rcyaon/cmos-lnb/Schematic/Gain Stage/mc_data.csv

 _net0           out
 3.30000000e+00  1.68583395e+00
 3.30000000e+00  1.68202784e+00
 3.30000000e+00  1.63784445e+00
 3.30000000e+00  1.67969787e+00
 3.30000000e+00  1.66346403e+00
 3.30000000e+00  1.72007400e+00
 3.30000000e+00  1.66306128e+00
 3.30000000e+00  1.65420103e+00
 3.30000000e+00  1.64092329e+00
 3.30000000e+00  1.68198193e+00
 3.30000000e+00  1.68303207e+00
 3.30000000e+00  1.72075115e+00
 3.30000000e+00  1.74998021e+00
 3.30000000e+00  1.75943422e+00
 3.30000000e+00  1.70848397e+00
 3.30000000e+00  1.75111769e+00
 3.30000000e+00  1.63028762e+00
 3.30000000e+00  1.72789546e+00
 3.30000000e+00  1.71950260e+00
 3.30000000e+00  1.64782215e+00
 3.30000000e+00  1.65489096e+00
 3.30000000e+00  1.69533768e+00
 3.30000000e+00  1.70911867e+00
 3.30000000e+00  1.63577114e+00
 3.30000000e+00  1.69450837e+00
 3.30000000e+00  1.64470949e+00
 3.30000000e+00  1.66045326e+00
 3.30000000e+00  1.69922742e+00
 3.30000000e+00  1.68772599e+00
 3.30000000e+00  1.66191446e+00
 3.30000000e+00  1.65378743e+00
 3.30000000e+00  1.70569348e+00
 3.30000000e+00  1.71278133e+00
 3.30000000e+00  1.75738077e+00
 3.30000000e+00  1.71392175e+00
 3.30000000e+00  1.72858636e+00
 3.30000000e+00  1.67343731e+00
 3.30000000e+00  1.69081392e+00
 3.30000000e+00  1.75463824e+00
 3.30000000e+00  1.67305431e+00
 3.30000000e+00  1.66519034e+00
 3.30000000e+00  1.67364047e+00
 3.30000000e+00  1.71924878e+00
 3.30000000e+00  1.74024214e+00
 3.30000000e+00  1.77166651e+00
 3.30000000e+00  1.65648861e+00
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
 3.30000000e+00  1.70047558e+00
 3.30000000e+00  1.70060708e+00
 3.30000000e+00  1.68307297e+00
 3.30000000e+00  1.70125979e+00
 3.30000000e+00  1.66604276e+00
 3.30000000e+00  1.66890092e+00
 3.30000000e+00  1.68194118e+00
 3.30000000e+00  1.69823240e+00
 3.30000000e+00  1.72320882e+00
