rcyaon/cmos-lnb/Schematic/LDO/mc_data.csv

 _net2           out_1v7         out_2v5
 9.77246243e-01  1.70468408e+00  2.47625812e+00
 9.77421526e-01  1.70310513e+00  2.48603720e+00
 9.75590573e-01  1.70203683e+00  2.47949161e+00
 9.76550721e-01  1.70259062e+00  2.48273581e+00
 9.76596335e-01  1.70550087e+00  2.48212616e+00
 9.75005960e-01  1.69989950e+00  2.48236986e+00
 9.76549995e-01  1.69609739e+00  2.47823842e+00
 9.73409559e-01  1.70357592e+00  2.48407099e+00
 9.75771300e-01  1.70350521e+00  2.47812514e+00
 9.74613815e-01  1.70708728e+00  2.48560461e+00
 9.76063830e-01  1.70111546e+00  2.47862901e+00
 9.72481360e-01  1.70052850e+00  2.47899641e+00
 9.74198809e-01  1.70414366e+00  2.47800581e+00
 9.75233957e-01  1.70443093e+00  2.47888064e+00
 9.74503848e-01  1.70601858e+00  2.48215969e+00
 9.74639859e-01  1.70541854e+00  2.48683475e+00
 9.76736413e-01  1.69925143e+00  2.48072915e+00
 9.77827186e-01  1.70107792e+00  2.47469940e+00
 9.74937529e-01  1.70460157e+00  2.48048242e+00
 9.77582034e-01  1.70518079e+00  2.47160845e+00
 9.75825789e-01  1.70420694e+00  2.48341043e+00
 9.77357153e-01  1.70313988e+00  2.48285104e+00
 9.77428814e-01  1.69990745e+00  2.46804022e+00
 9.76853585e-01  1.70119539e+00  2.48719937e+00
 9.76476334e-01  1.70490760e+00  2.47670279e+00
 9.76364884e-01  1.70555823e+00  2.47984207e+00
 9.74880539e-01  1.70559182e+00  2.47901247e+00
 9.78136822e-01  1.70012559e+00  2.48126371e+00
 9.74008382e-01  1.70031722e+00  2.48817627e+00
 9.74580847e-01  1.69861129e+00  2.47567711e+00
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
 9.76390307e-01  1.70285434e+00  2.48463038e+00
 9.77330476e-01  1.70351396e+00  2.48061591e+00
 9.75548920e-01  1.70058418e+00  2.47610699e+00
 9.76323225e-01  1.70569119e+00  2.48474366e+00
 9.76735605e-01  1.70648532e+00  2.48374045e+00
 9.76780395e-01  1.70302016e+00  2.48521266e+00
 9.75597833e-01  1.70398375e+00  2.48273363e+00
 9.76262722e-01  1.70223109e+00  2.47880831e+00
 9.79748683e-01  1.70448570e+00  2.48529902e+00
 9.76016633e-01  1.69828643e+00  2.47832998e+00
 9.76586605e-01  1.70104679e+00  2.47897045e+00
 9.75772829e-01  1.70842233e+00  2.48127845e+00
 9.77791422e-01  1.69877060e+00  2.48227929e+00
 9.76446421e-01  1.70296661e+00  2.47796003e+00
 9.77571122e-01  1.70454232e+00  2.47848129e+00
 9.75471506e-01  1.70080852e+00  2.48277905e+00
 9.77778661e-01  1.70513684e+00  2.47938800e+00
 9.75961408e-01  1.70553503e+00  2.47356947e+00
 9.78091968e-01  1.69991725e+00  2.48165223e+00
 9.75946097e-01  1.70102088e+00  2.48385812e+00
 9.75693006e-01  1.69732371e+00  2.47734892e+00
 9.75691131e-01  1.70352415e+00  2.47394726e+00
 9.76035717e-01  1.70485462e+00  2.47853882e+00
 9.77915350e-01  1.70219673e+00  2.48410119e+00
 9.76820954e-01  1.70484325e+00  2.47872105e+00
 9.75818506e-01  1.70050121e+00  2.47844079e+00
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
