rcyaon/cmos-lnb/Images/LNA_Block_Diagram.png

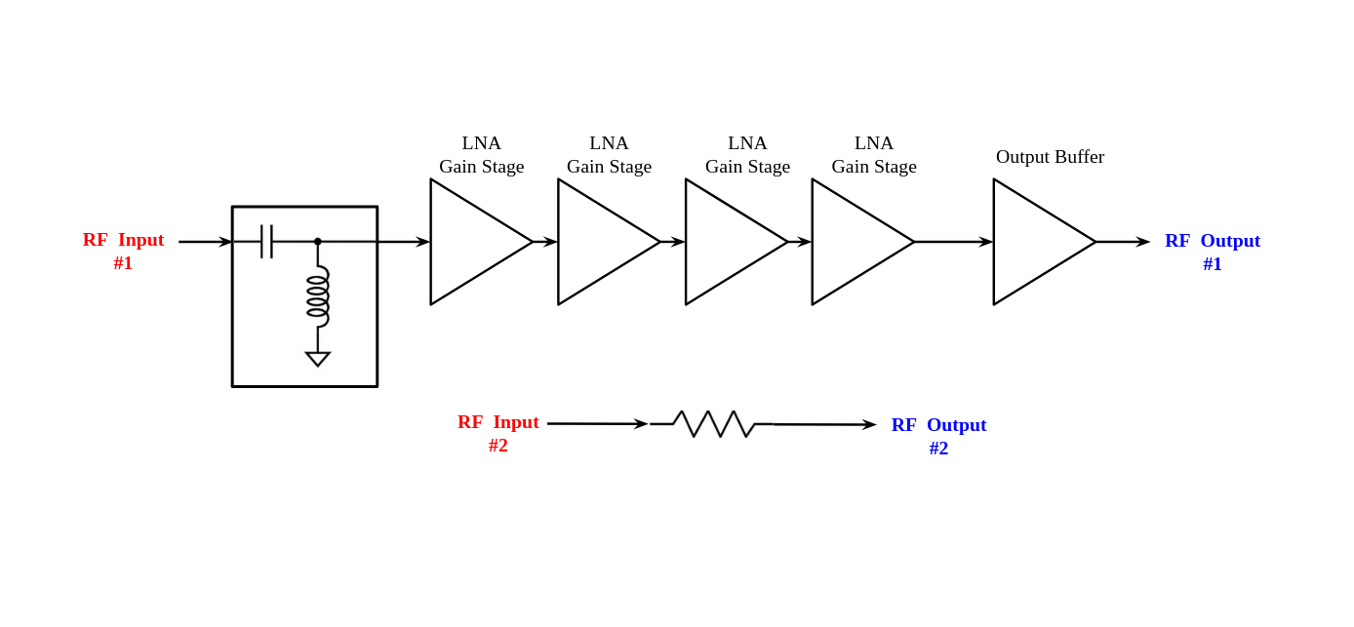
Images/LNA_Block_Diagram.png
