rcyaon/cmos-lnb/Images/LNB_Block_Diagram.png

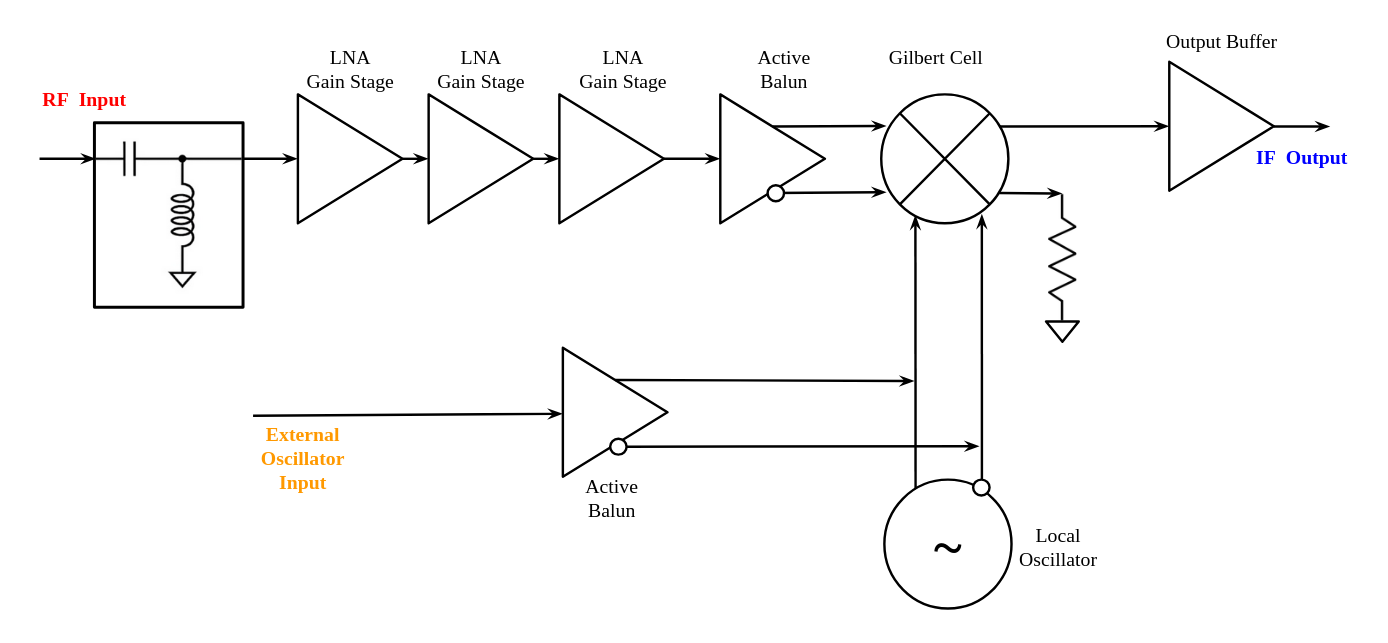
Images/LNB_Block_Diagram.png
