rcyaon/cmos-lnb/Images/LNB_Frequency_Converter_Block_Diagram.png

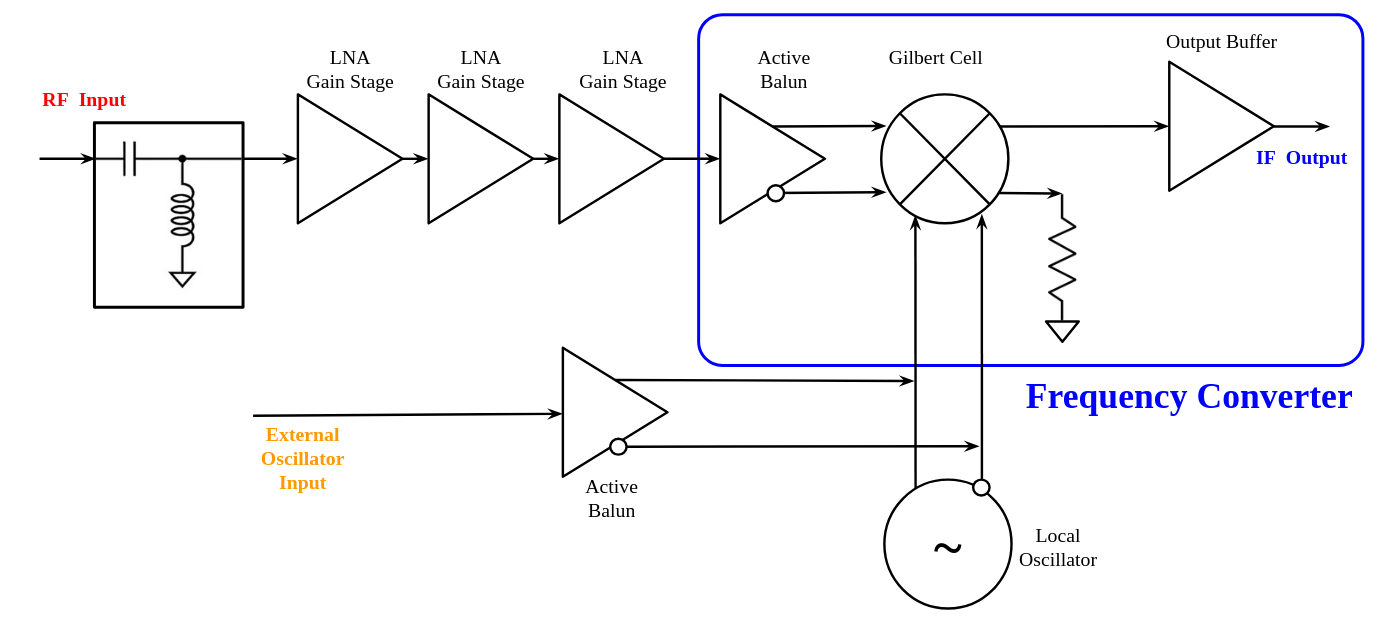
Images/LNB_Frequency_Converter_Block_Diagram.png
