rcyaon/cmos-lnb/Images/LNB_Front_End_Block_Diagram.png

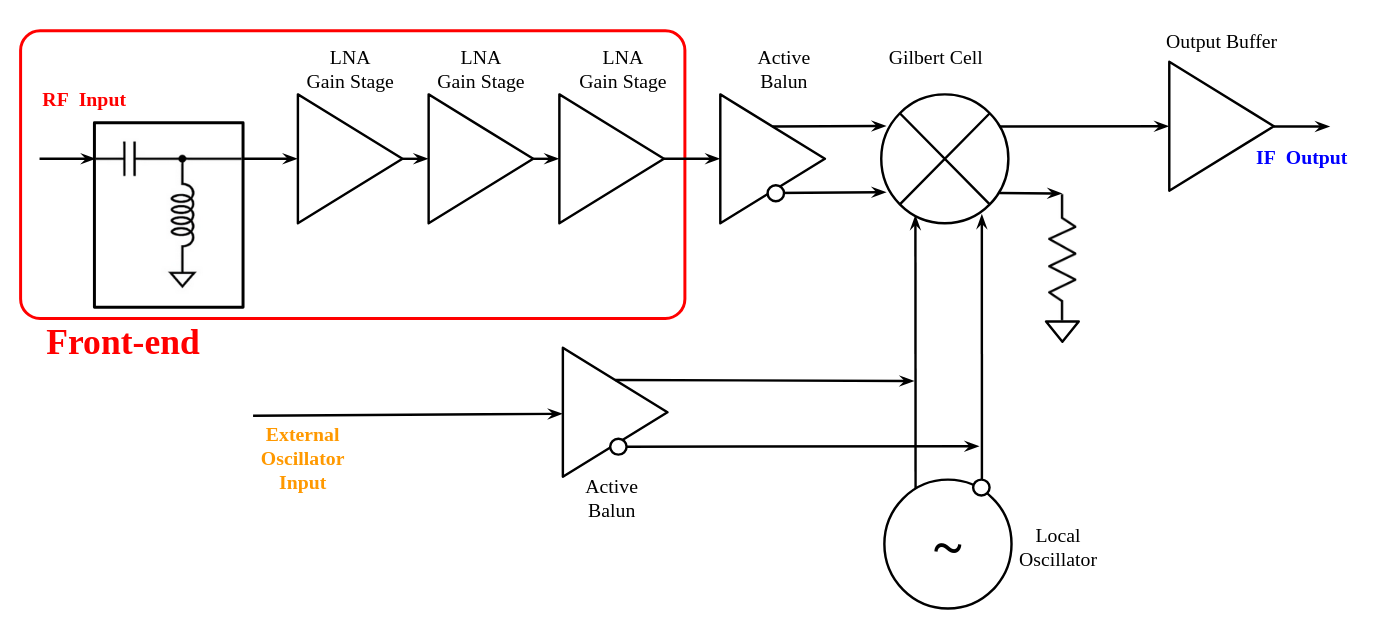
Images/LNB_Front_End_Block_Diagram.png
