rcyaon/cmos-lnb/Images/MC__net0_TT.png

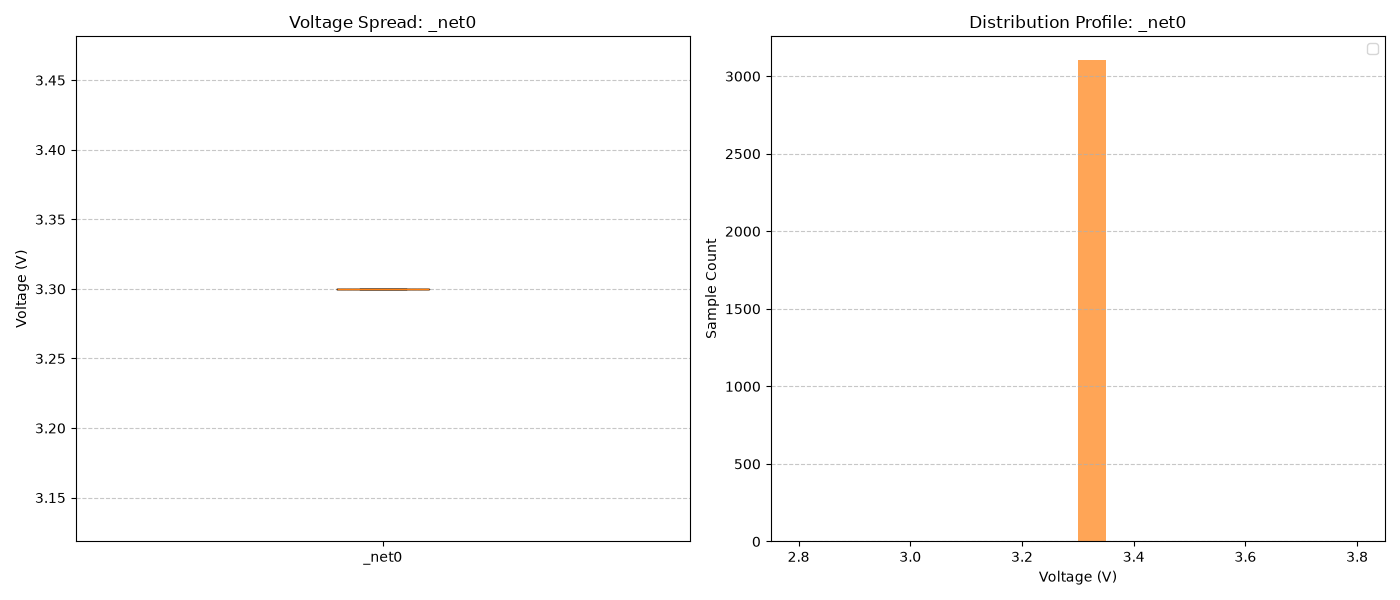
Images/MC__net0_TT.png
