rcyaon/cmos-lnb/Images/MC__net2_TT.png

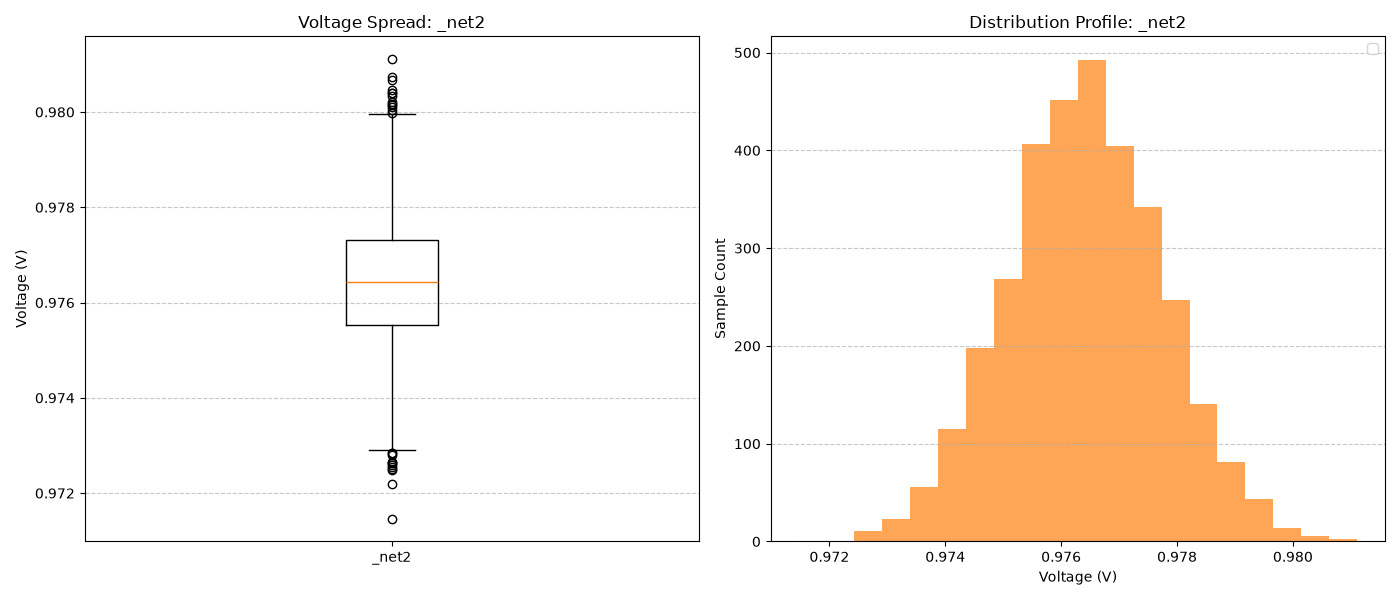
Images/MC__net2_TT.png
