rcyaon/cmos-lnb/Images/QUCS_ota5.png

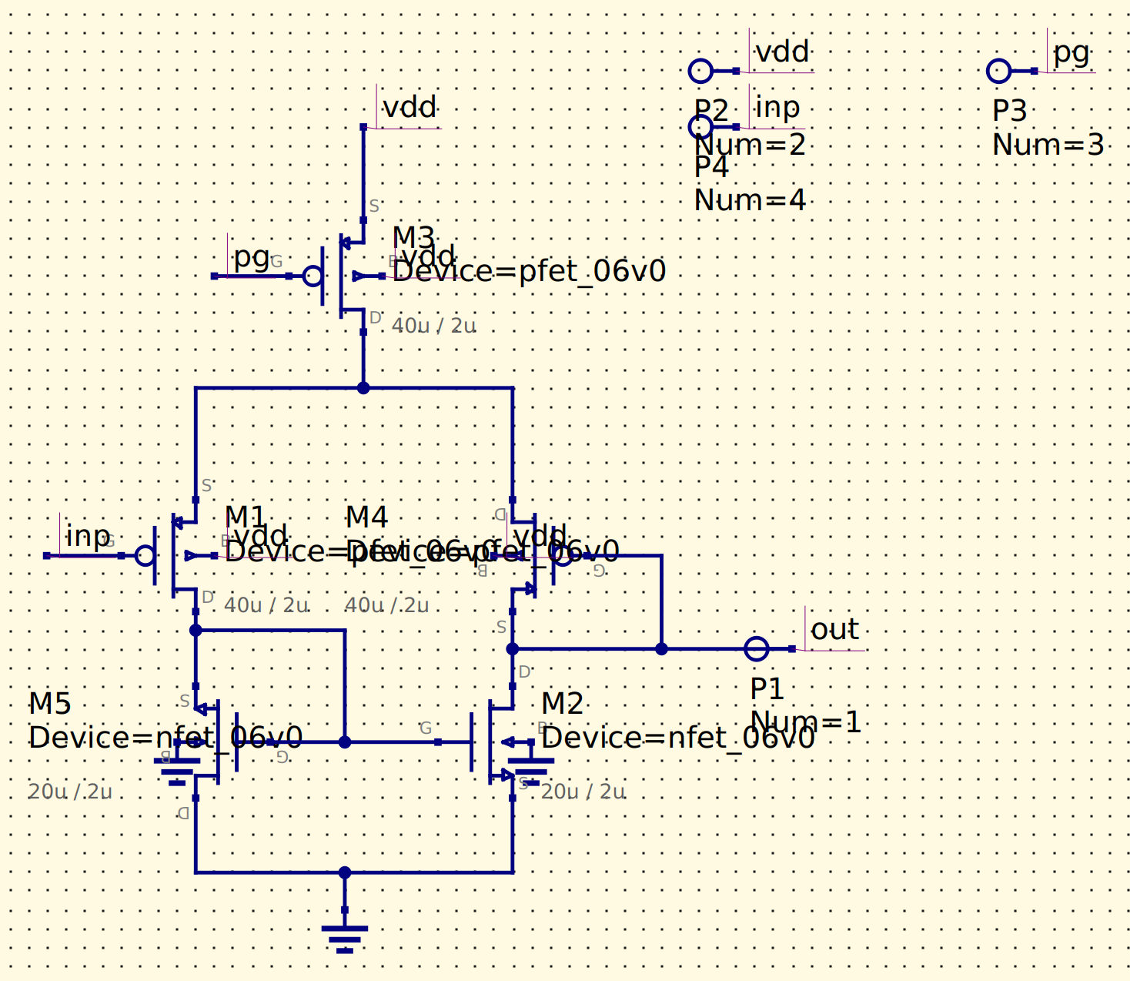
Images/QUCS_ota5.png
