rcyaon/cmos-lnb/Images/QUCS_tb_beta_mult_startup.png

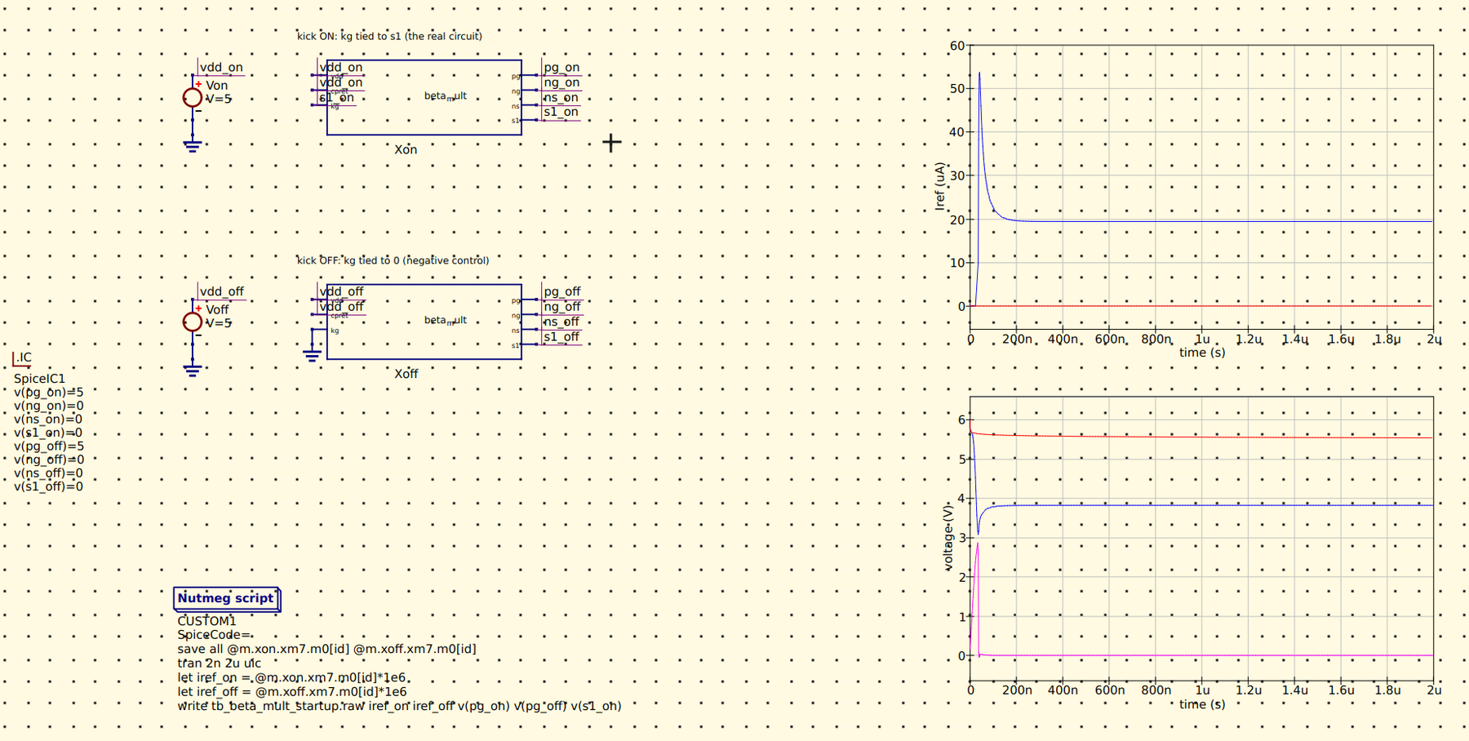
Images/QUCS_tb_beta_mult_startup.png
