rcyaon/cmos-lnb/Images/QUCS_tb_beta_mult_supply.png

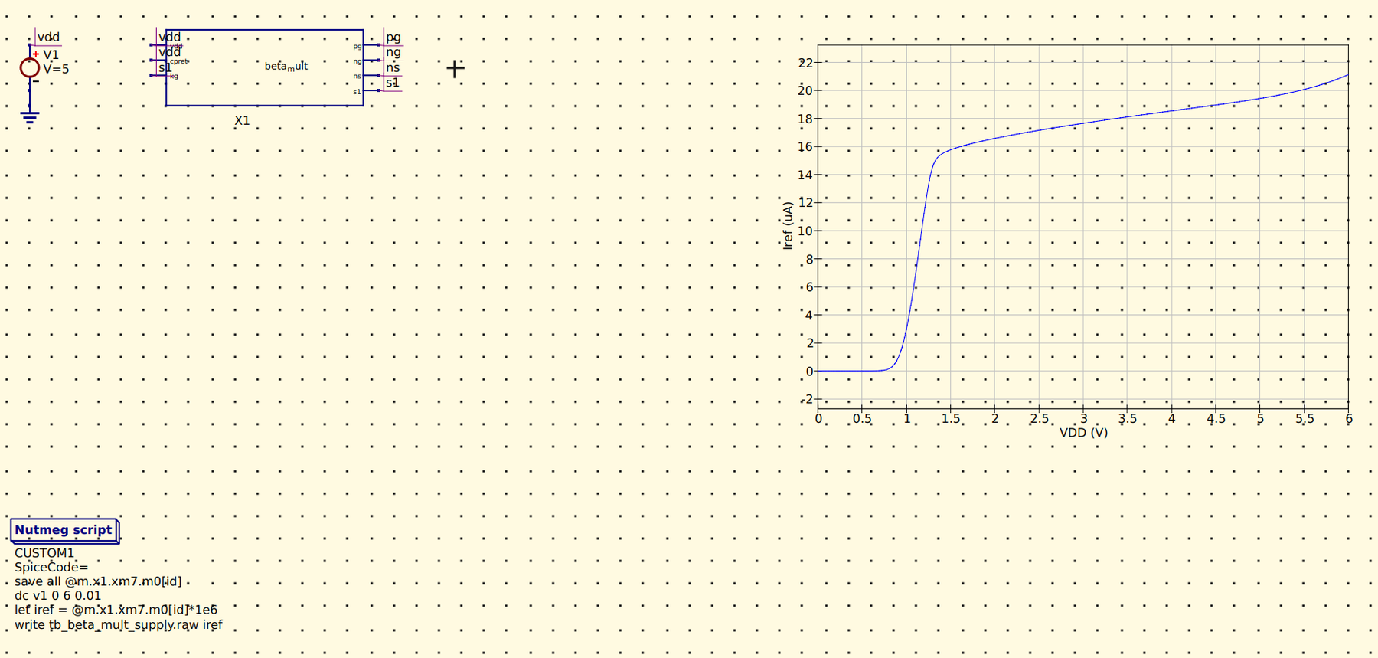
Images/QUCS_tb_beta_mult_supply.png
