rcyaon/cmos-lnb/Images/QUCS_tb_beta_mult_temp.png

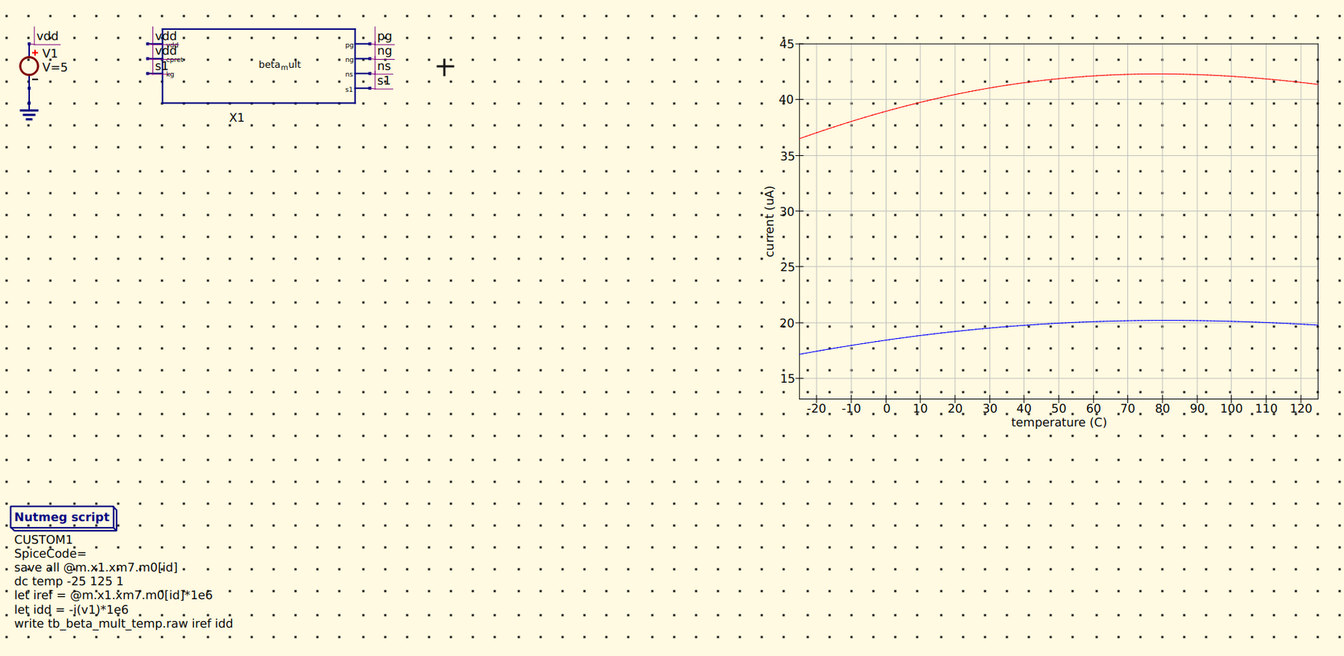
Images/QUCS_tb_beta_mult_temp.png
