rcyaon/cmos-lnb/Images/QUCS_tb_inv_vtc.png

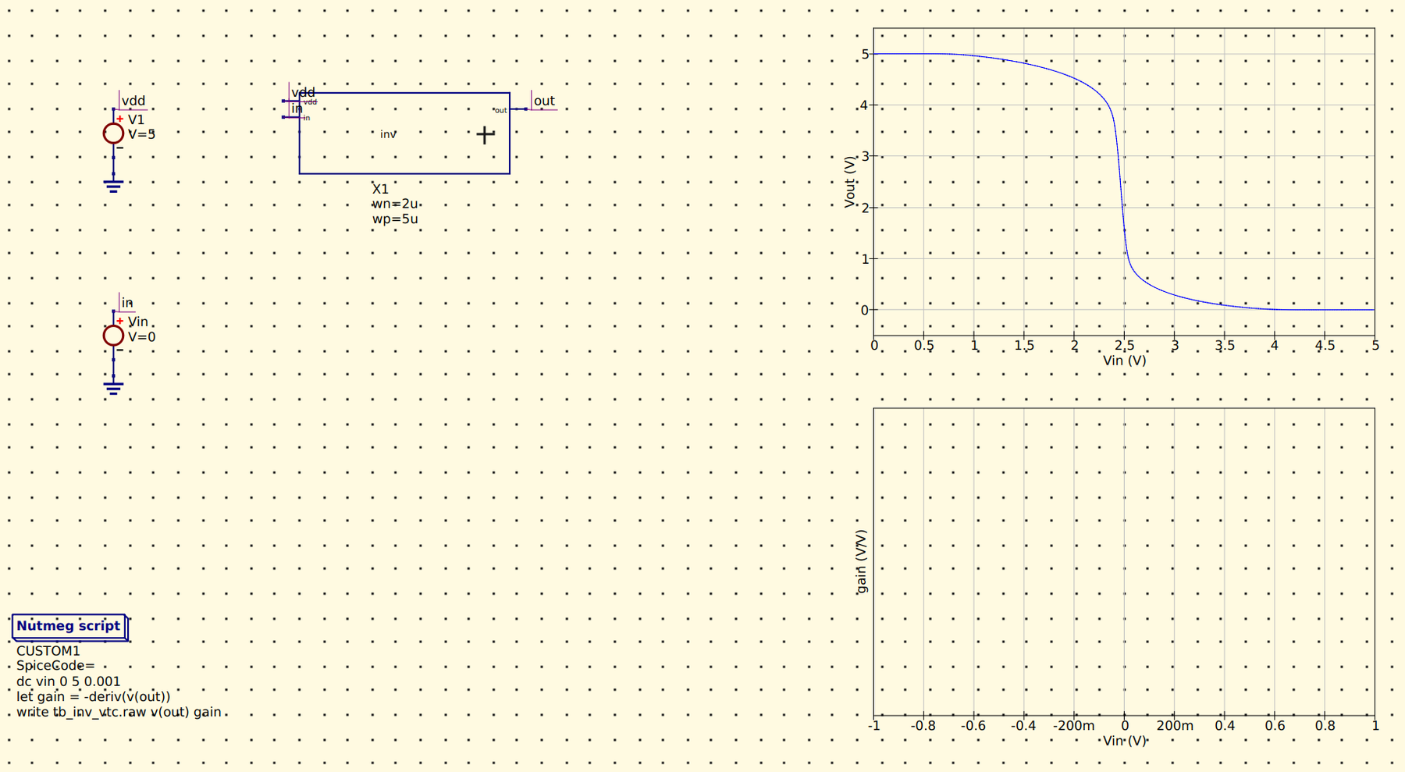
Images/QUCS_tb_inv_vtc.png
