rcyaon/cmos-lnb/Images/QUCS_tb_ringosci.png

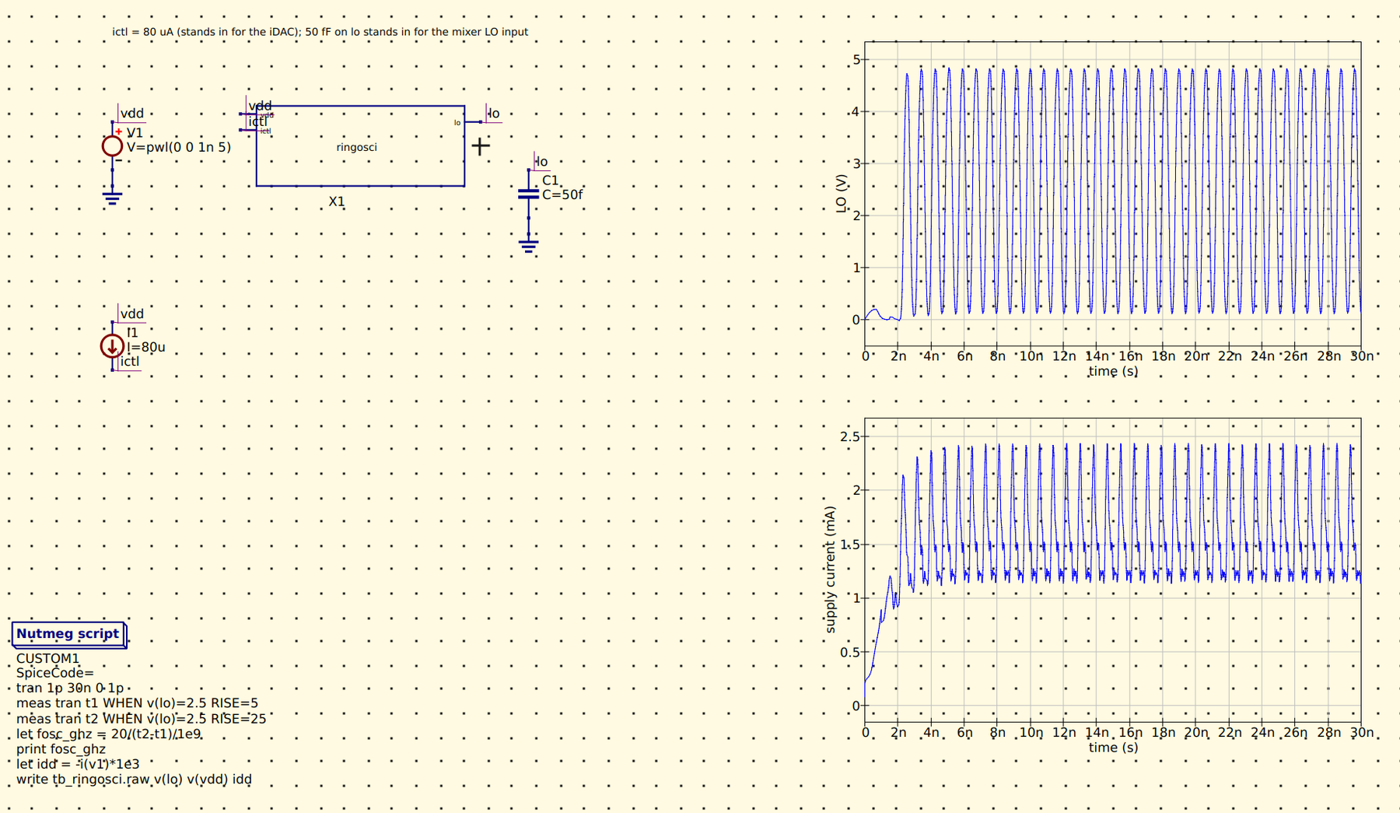
Images/QUCS_tb_ringosci.png
