rcyaon/cmos-lnb/Images/QUCS_tb_ringosci_disable.png

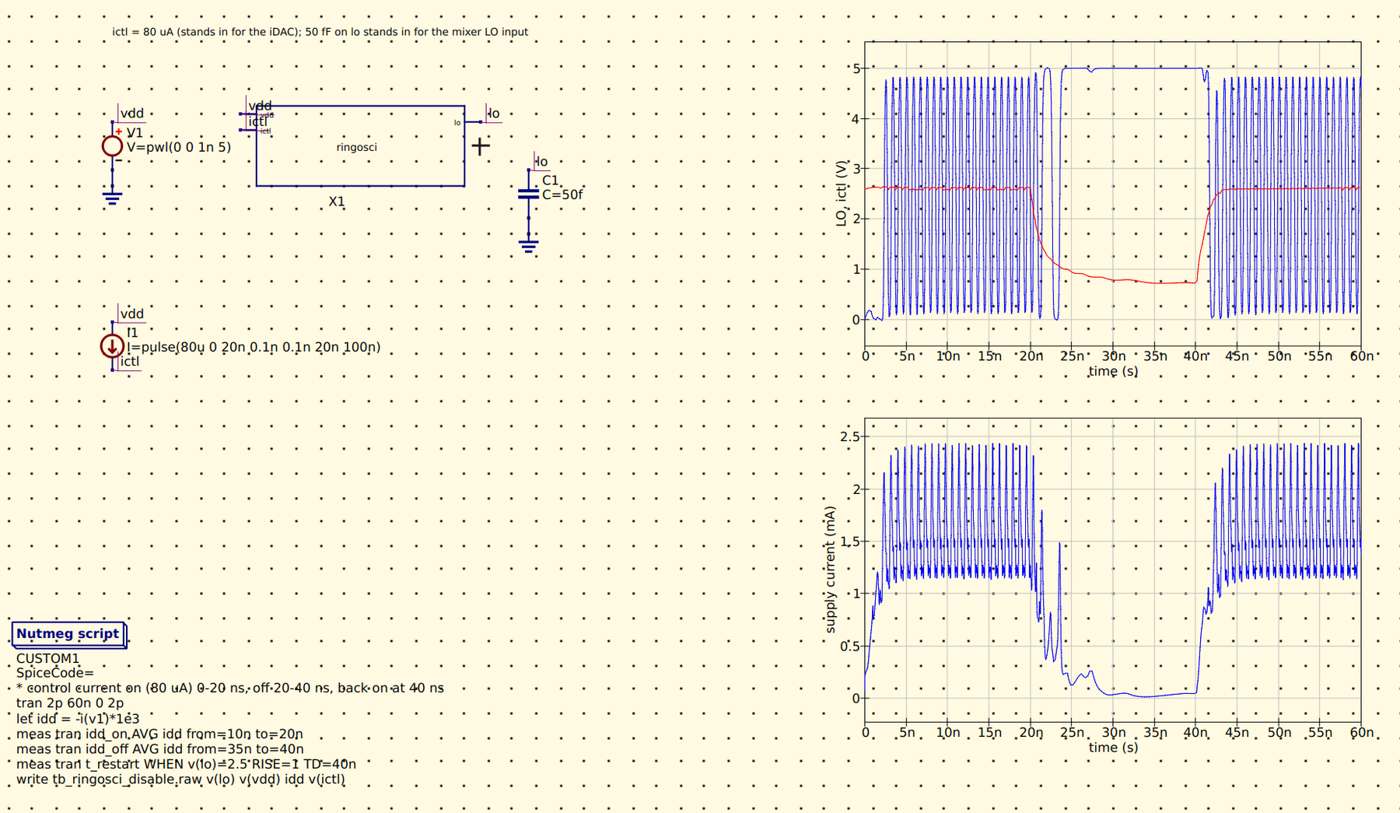
Images/QUCS_tb_ringosci_disable.png
