rcyaon/cmos-lnb/Images/QUCS_tb_vref_load.png

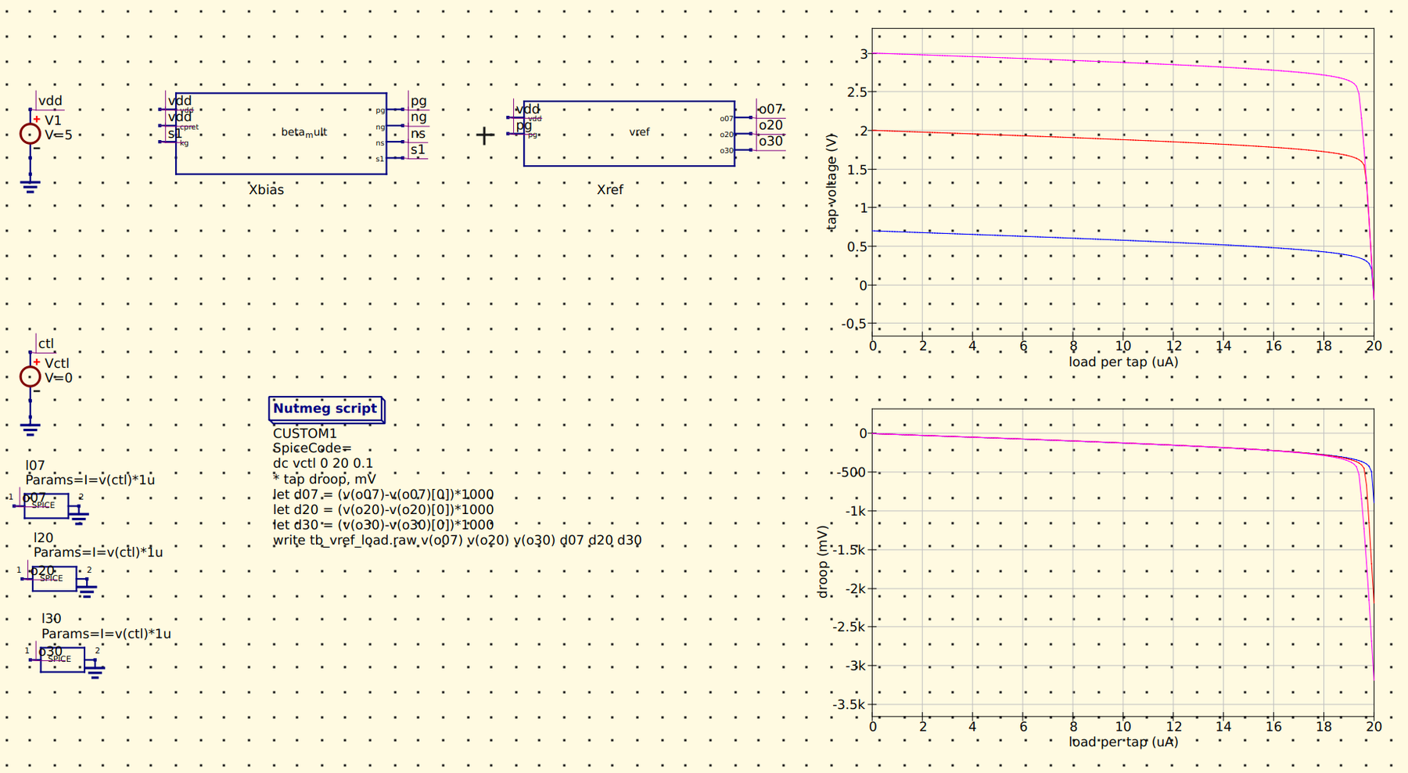
Images/QUCS_tb_vref_load.png
