rcyaon/cmos-lnb/Images/QUCS_tb_vref_loadstep.png

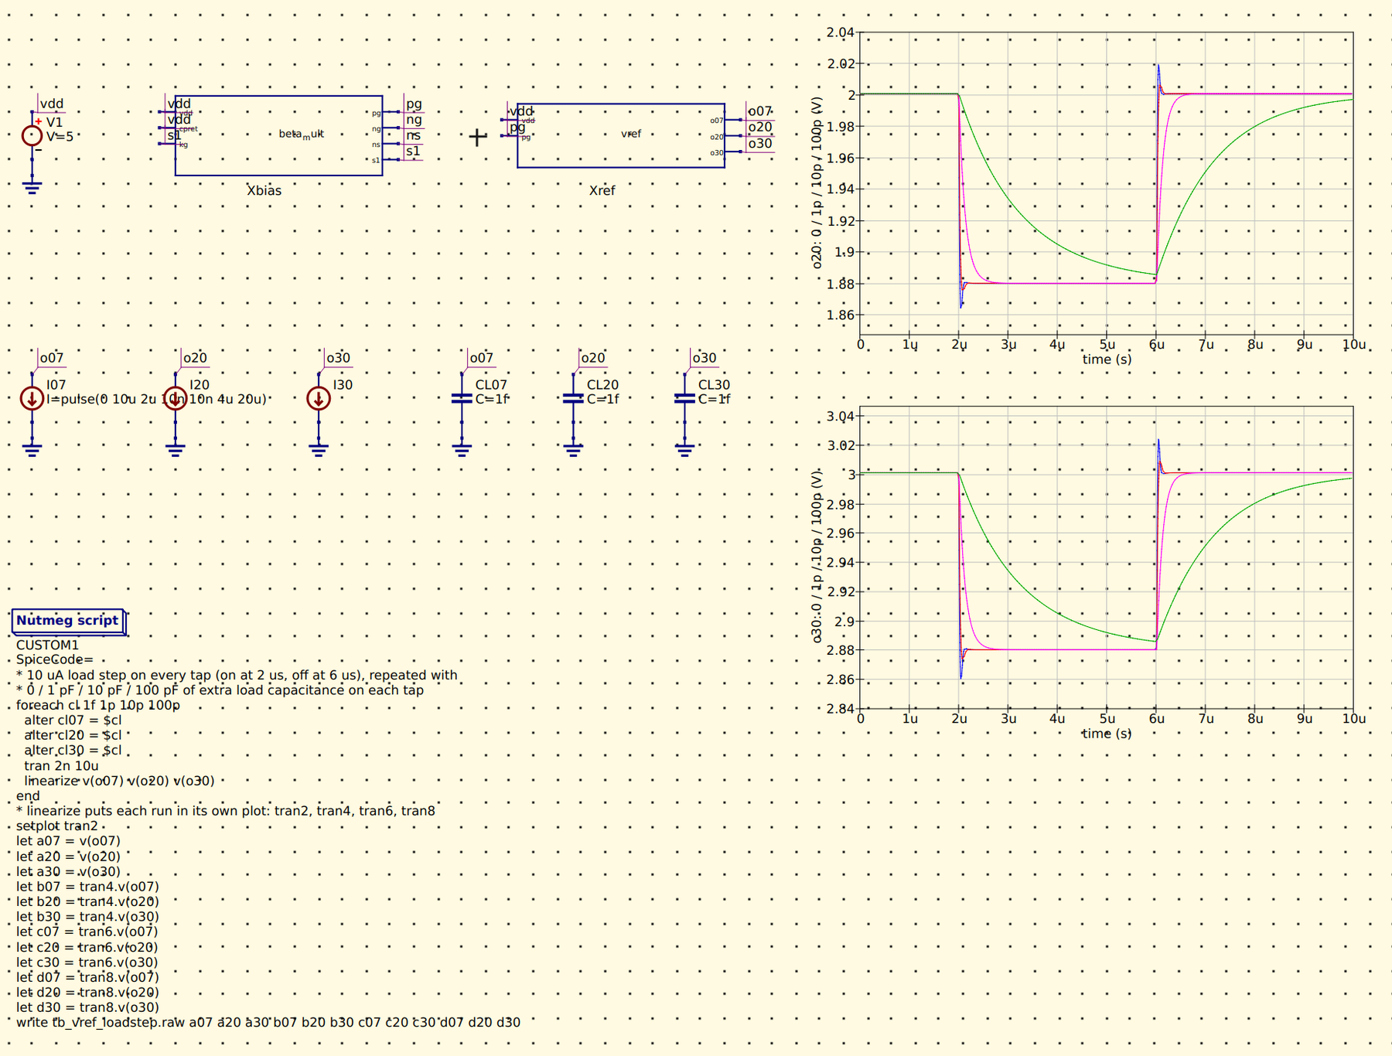
Images/QUCS_tb_vref_loadstep.png
