rcyaon/cmos-lnb/Images/QUCS_tb_vref_noise.png

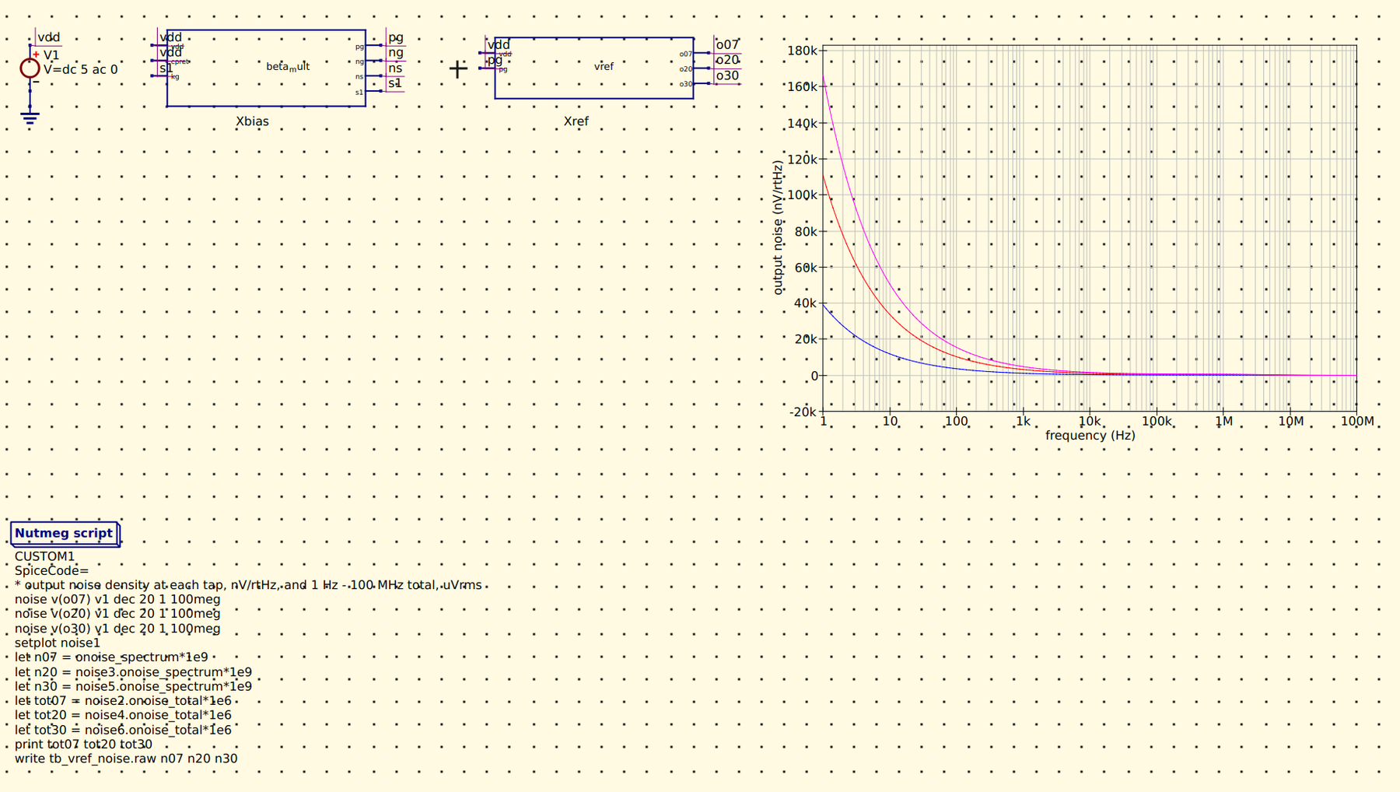
Images/QUCS_tb_vref_noise.png
