rcyaon/cmos-lnb/Images/QUCS_tb_vref_powerup.png

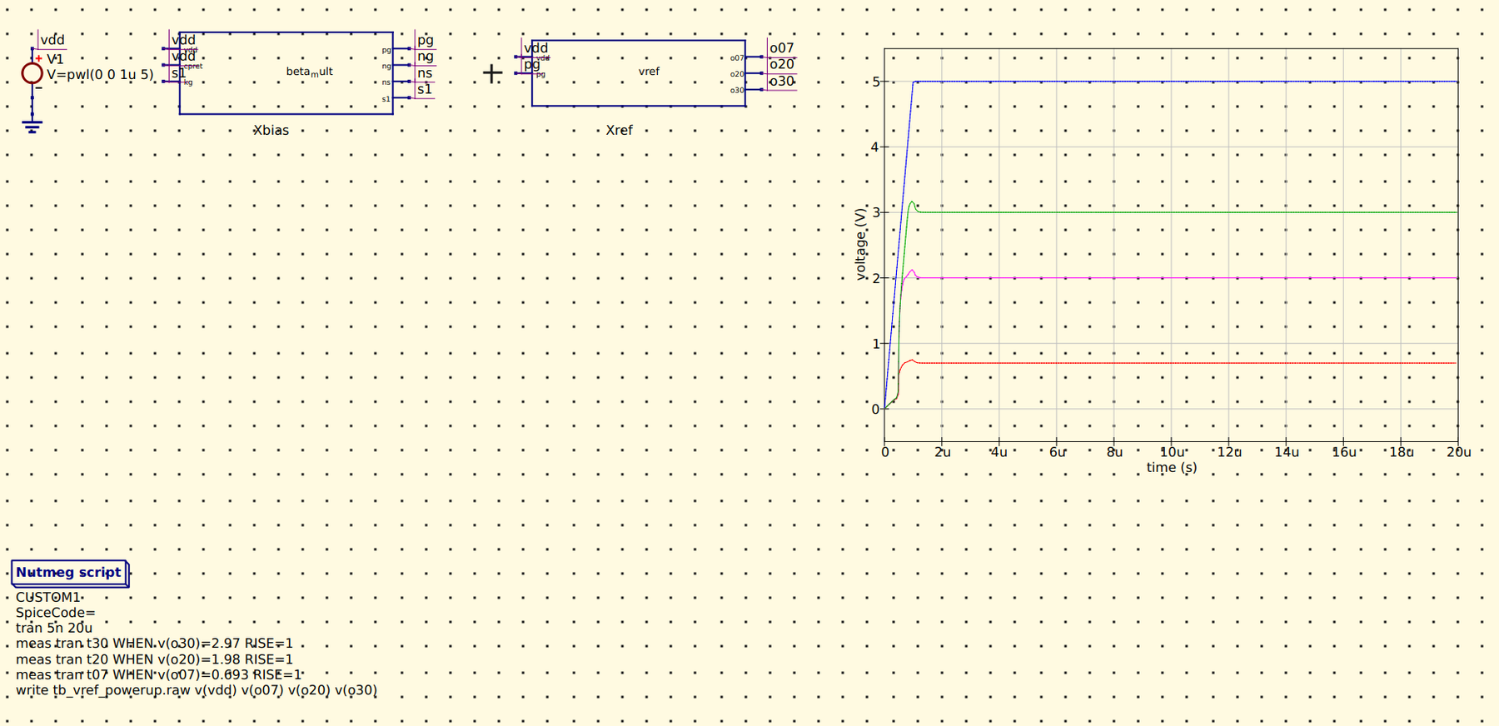
Images/QUCS_tb_vref_powerup.png
