rcyaon/cmos-lnb/Images/QUCS_tb_vref_psrr.png

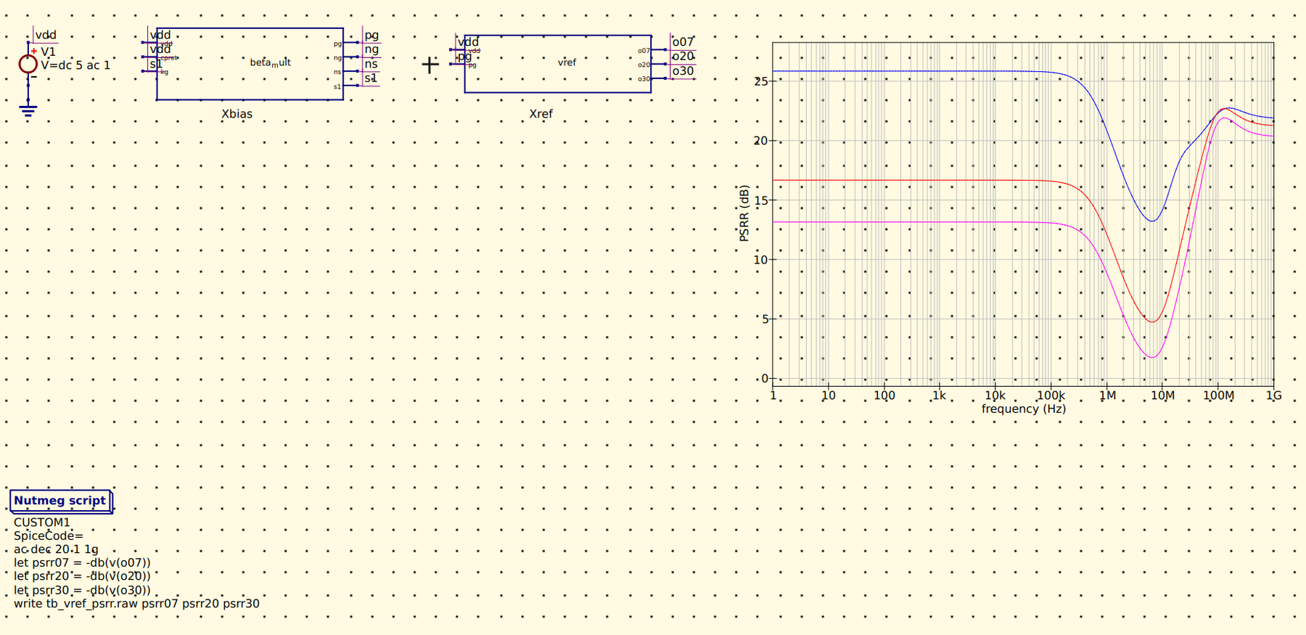
Images/QUCS_tb_vref_psrr.png
