rcyaon/cmos-lnb/Images/QUCS_tb_vref_supply.png

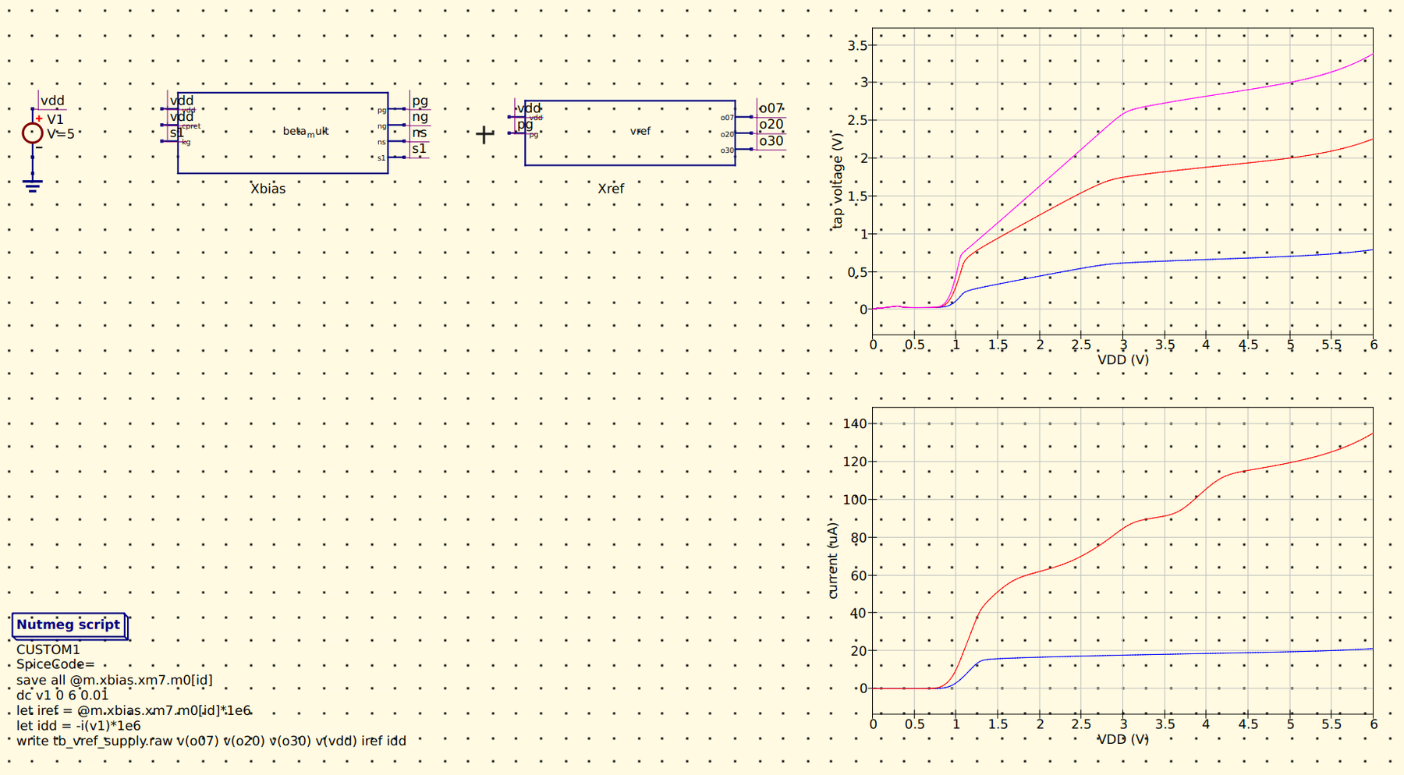
Images/QUCS_tb_vref_supply.png
