rcyaon/cmos-lnb/Images/QUCS_tb_vref_temp.png

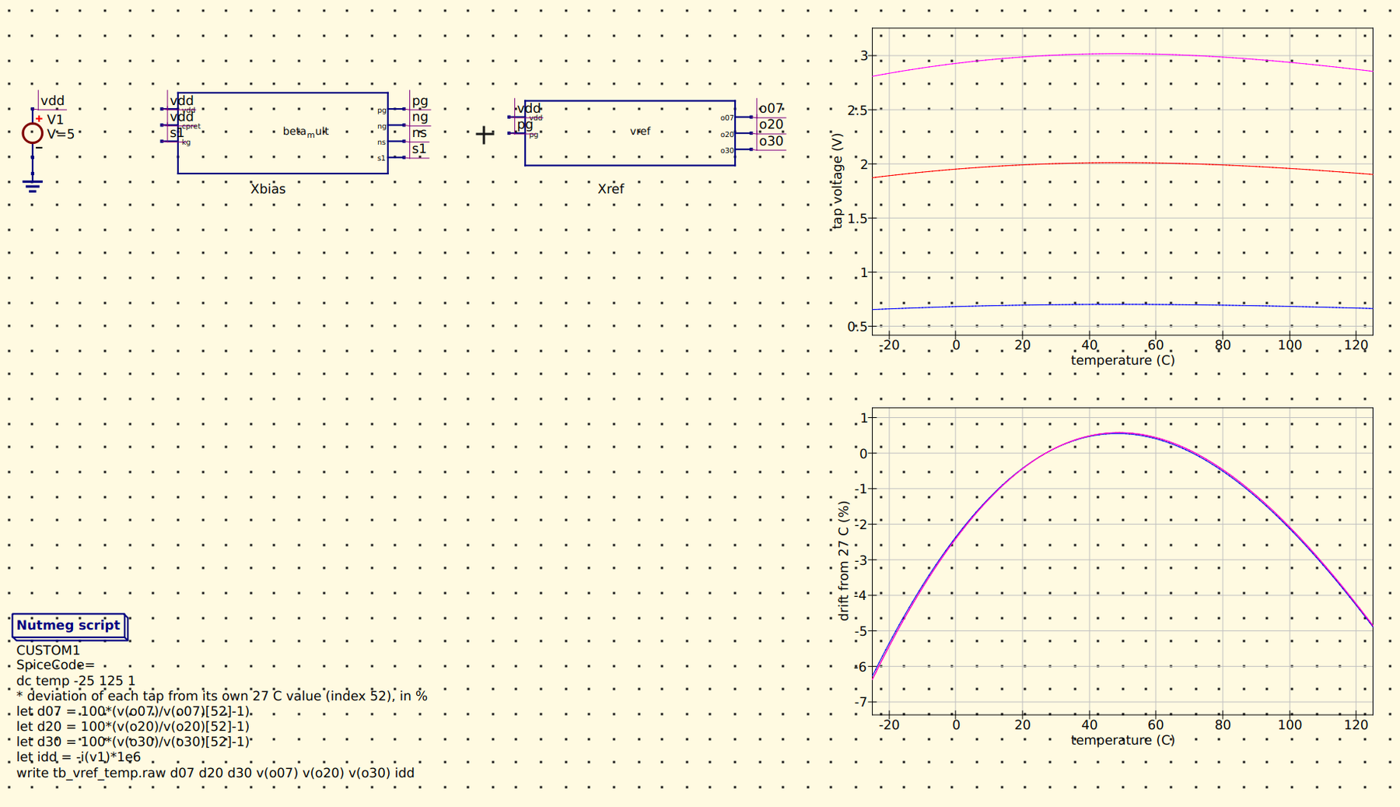
Images/QUCS_tb_vref_temp.png
