rcyaon/cmos-lnb/Images/Reference_Rise_Time_FF.png

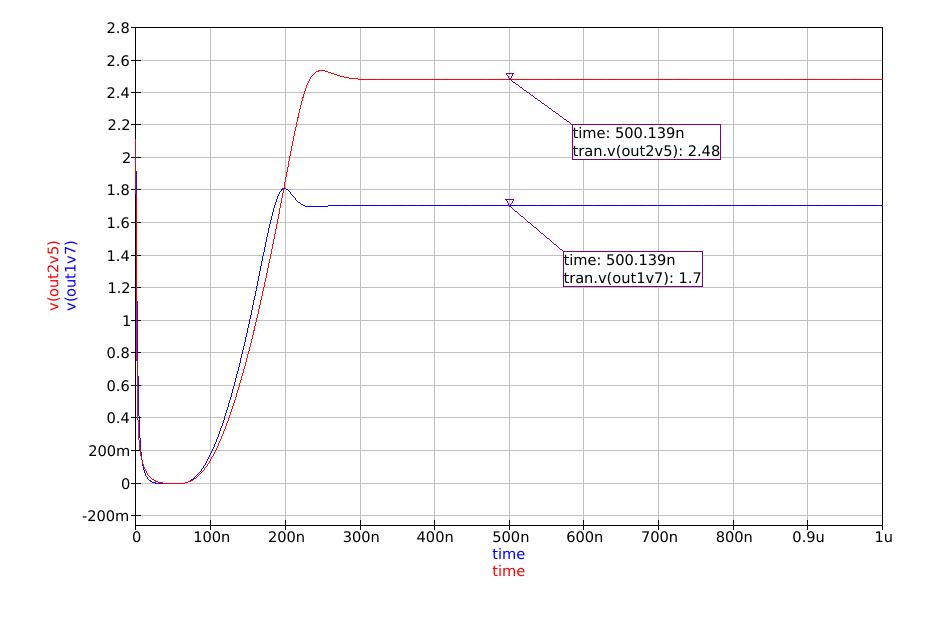
Images/Reference_Rise_Time_FF.png
