rcyaon/cmos-lnb/Images/Reference_Rise_Time_SF.png

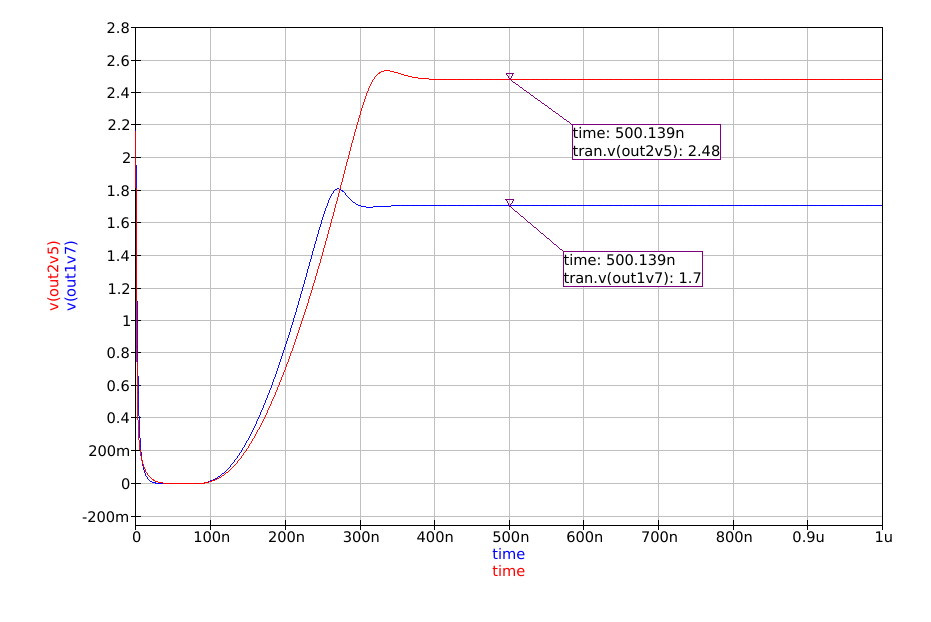
Images/Reference_Rise_Time_SF.png
