rcyaon/cmos-lnb/Images/Reference_Rise_Time_SS.png

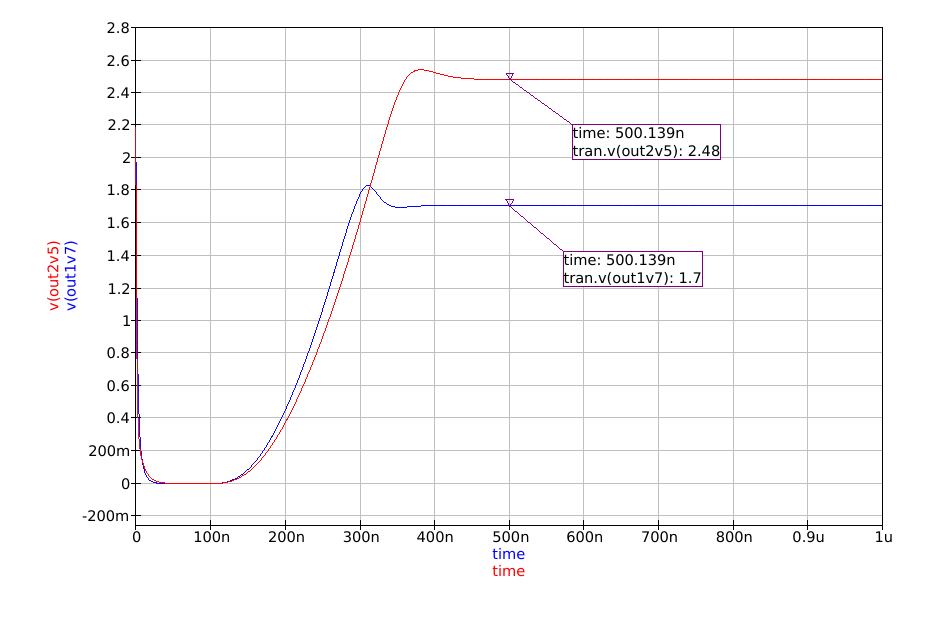
Images/Reference_Rise_Time_SS.png
