rcyaon/cmos-lnb/Schematic/LNB/Characterization.md

# Low Noise Block Down Converter

*Most Up-To-Date Schematic: Schematic/LNB/LNBMkII.sch*

All characterization was done with a 3.3V supply, at 27 C and with the oscillator current limiters provided with 2 mA of current.

## S Parameter Test Bench

*Most Up-To-Date Schematic: Schematic/LNB/LNB_Testing_S_Parameters_MkI.sch*

### Typical

|Parameter|Simulation|
|---|---|
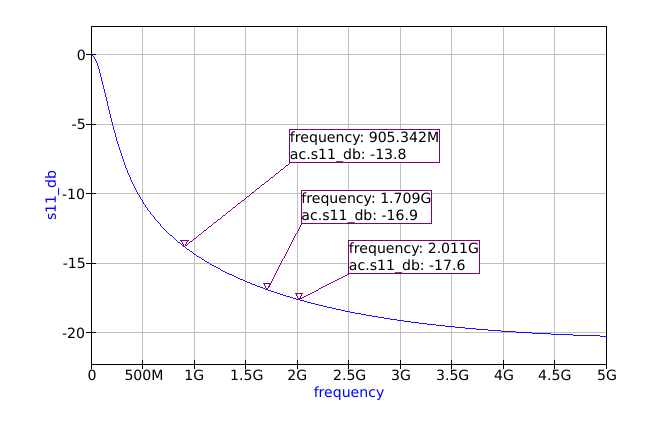
[picture p45: Images/LNB_S11_TT.png]
|S11||
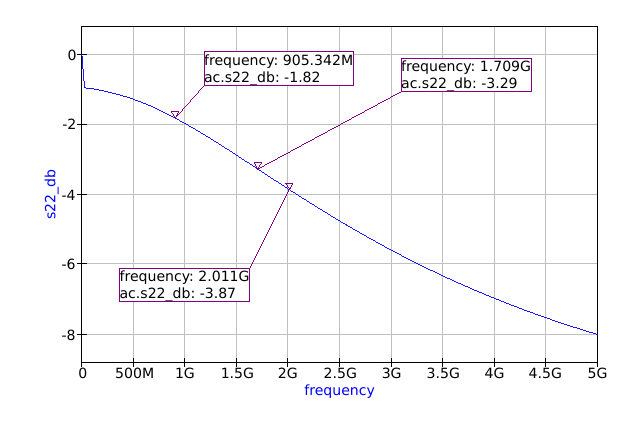
[picture p46: Images/LNB_S22_TT.png]
|S22||

### Slow-Slow Corner

|Parameter|Simulation|
|---|---|
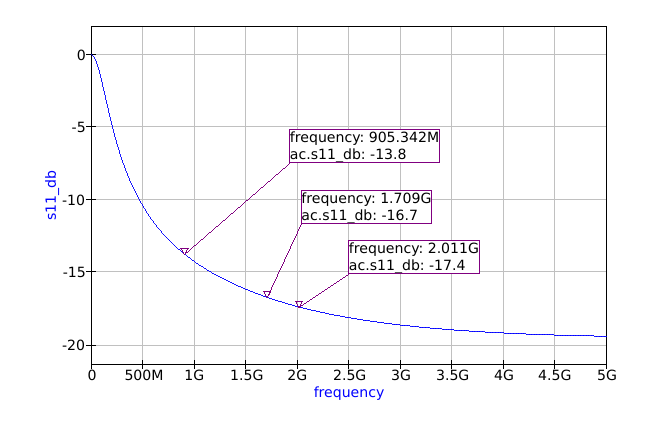
[picture p47: Images/LNB_S11_SS.png]
|S11||
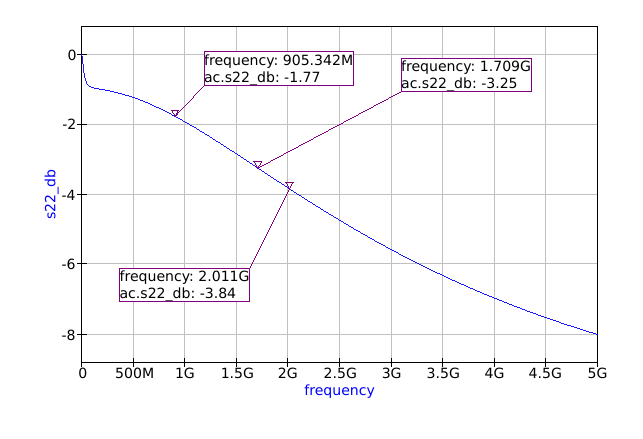
[picture p48: Images/LNB_S22_SS.png]
|S22||

### Fast-Fast Corner

|Parameter|Simulation|
|---|---|
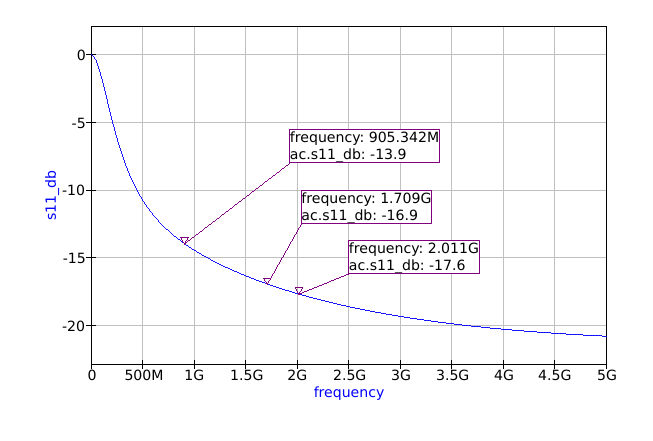
[picture p49: Images/LNB_S11_FF.png]
|S11||
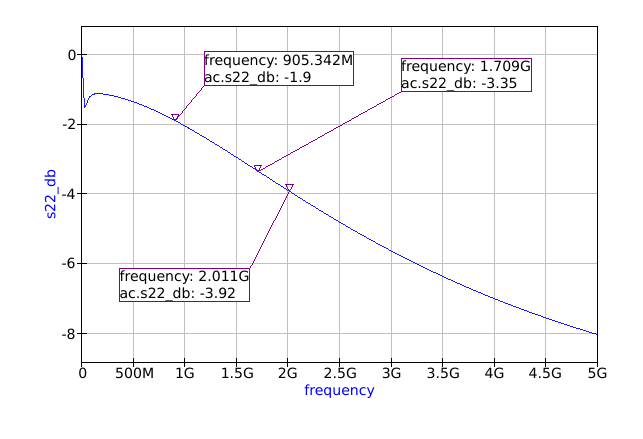
[picture p50: Images/LNB_S22_FF.png]
|S22||

### Slow-Fast Corner

|Parameter|Simulation|
|---|---|
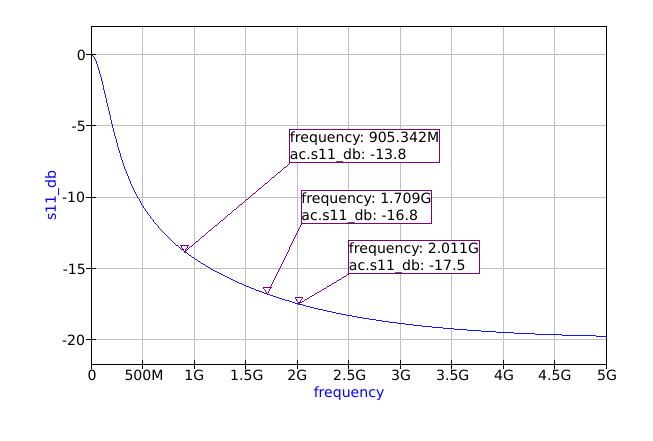
[picture p51: Images/LNB_S11_SF.png]
|S11||
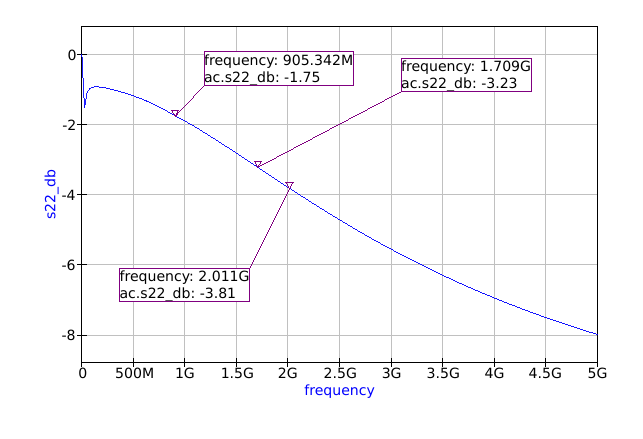
[picture p52: Images/LNB_S22_SF.png]
|S22||

### Fast-Slow Corner

|Parameter|Simulation|
|---|---|
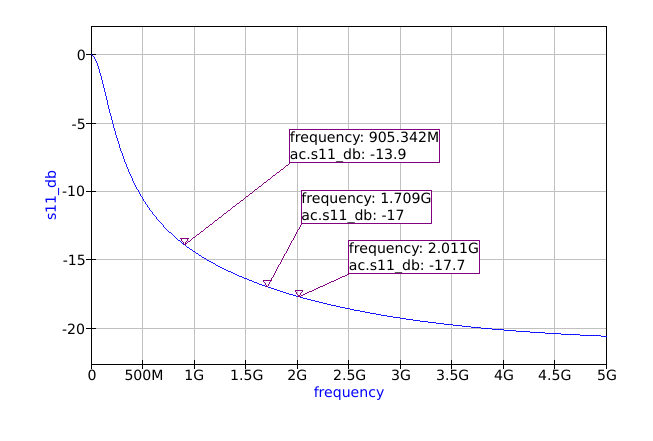
[picture p53: Images/LNB_S11_FS.png]
|S11||
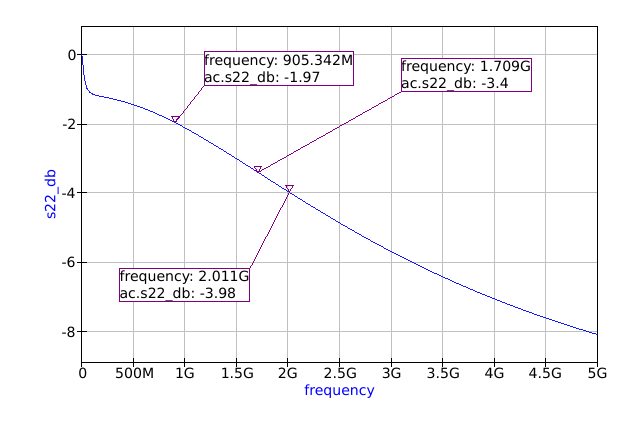
[picture p54: Images/LNB_S22_FS.png]
|S22||

## Gain Test Bench

*Most Up-To-Date Schematic: Schematic/LNB/LNB_Testing_Gain_MkI.sch*

### Typical

|900 MHz|1.7 GHz|2.0 GHz|
|---|---|---|
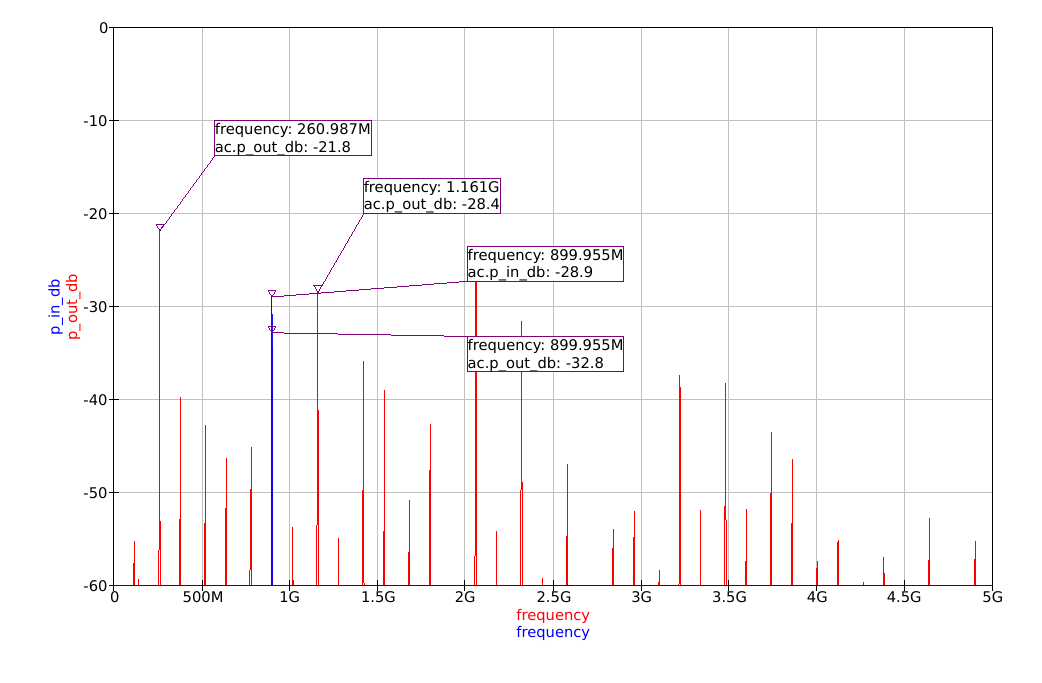
[picture p55: Images/LNB_Gain_0p9G_TT.png]
Gain
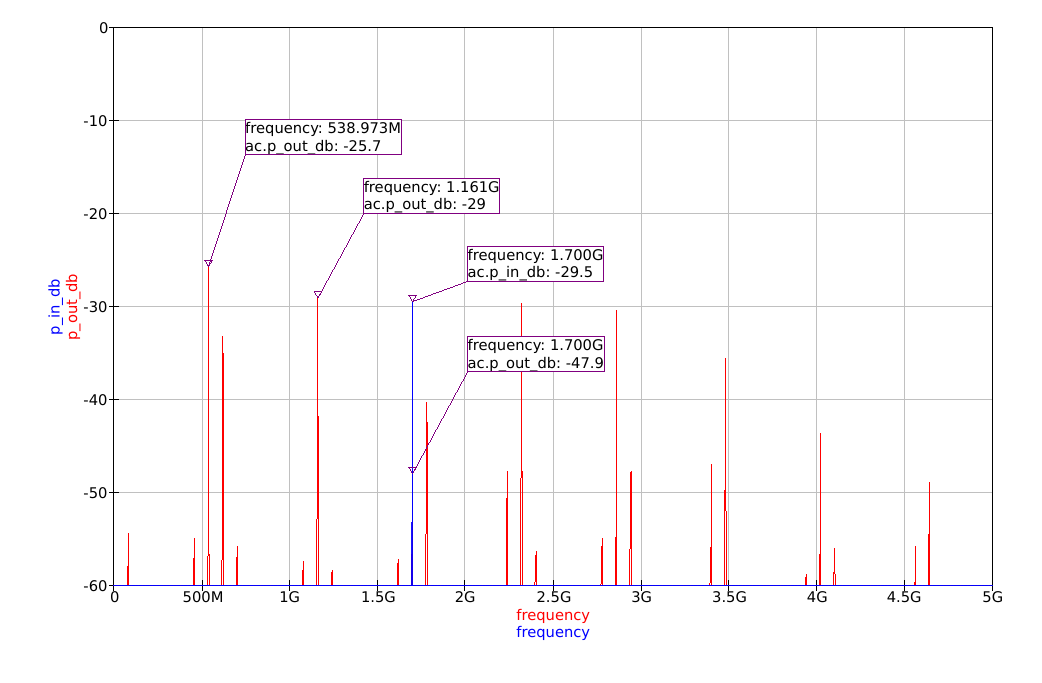
[picture p56: Images/LNB_Gain_1p7G_TT.png]
Gain
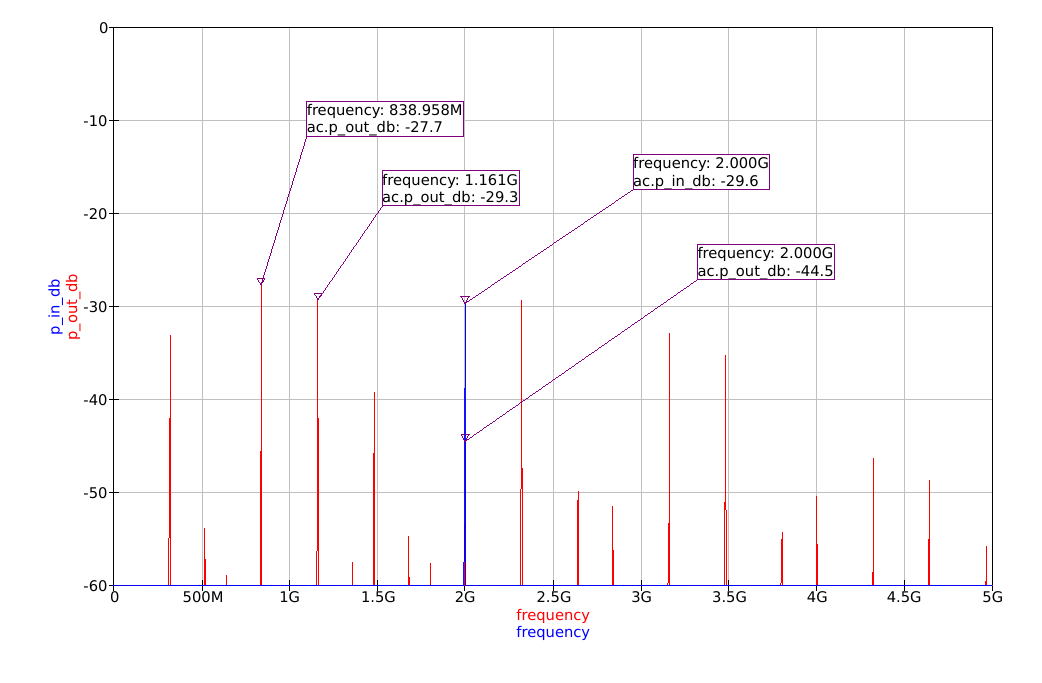
[picture p57: Images/LNB_Gain_2p0G_TT.png]
Gain
||||

### Slow-Slow Corner

|900 MHz|1.7 GHz|2.0 GHz|
|---|---|---|
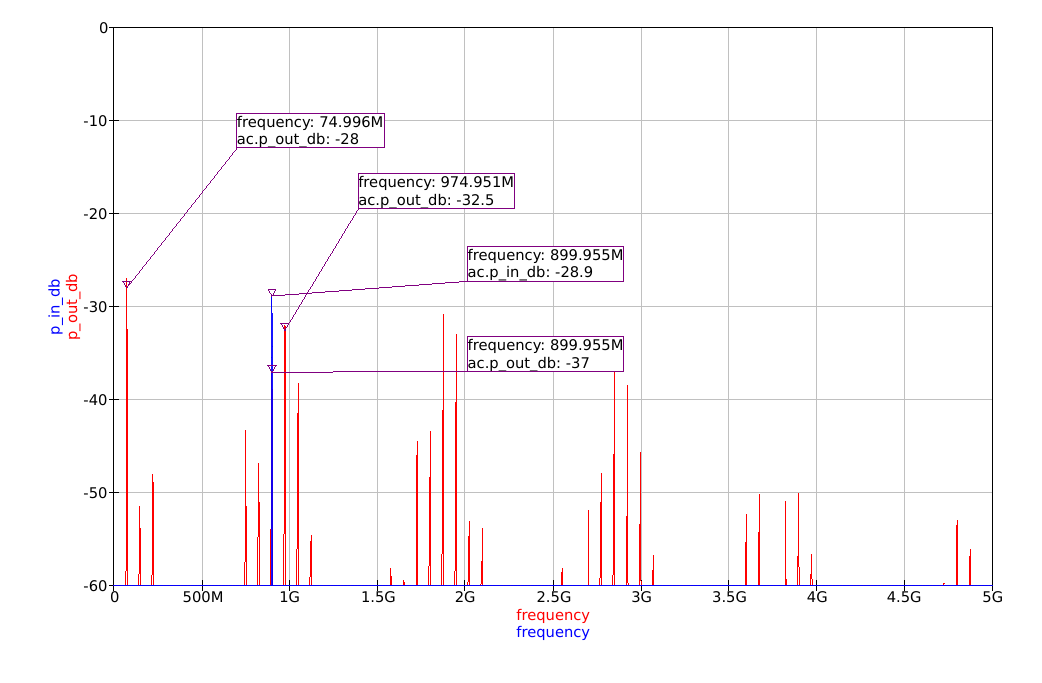
[picture p58: Images/LNB_Gain_0p9G_SS.png]
Gain
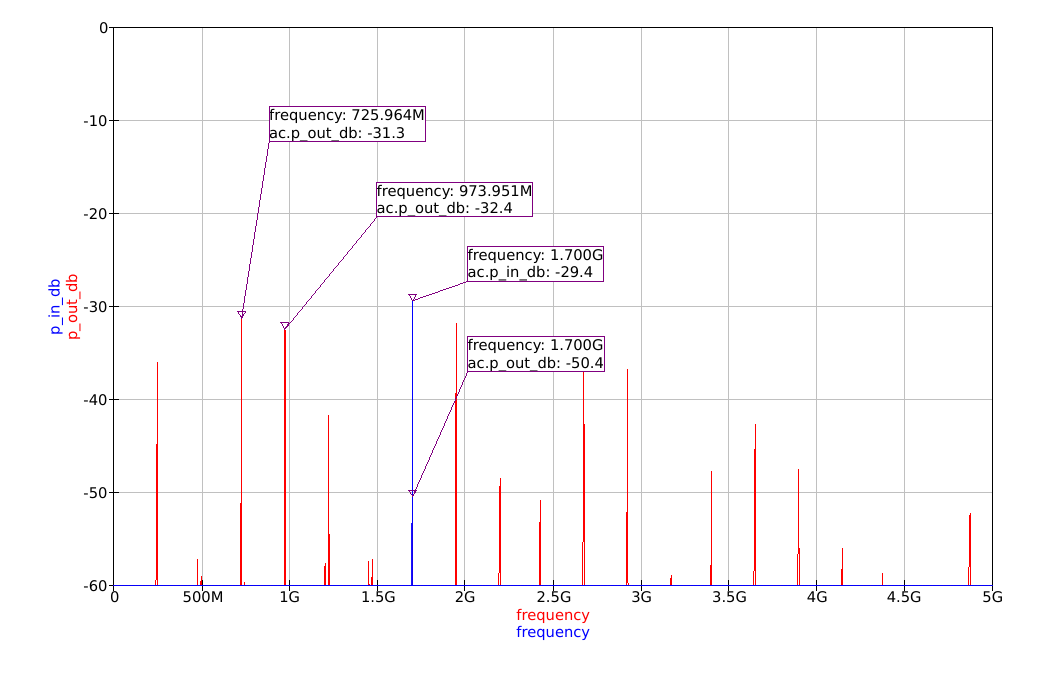
[picture p59: Images/LNB_Gain_1p7G_SS.png]
Gain
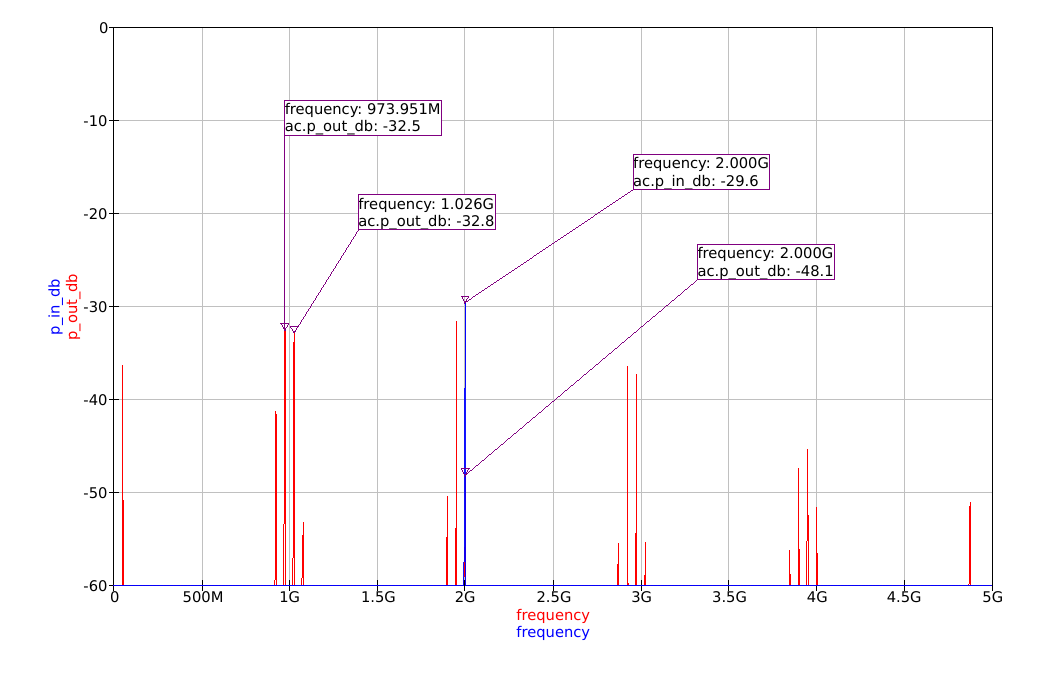
[picture p60: Images/LNB_Gain_2p0G_SS.png]
Gain
||||

### Fast-Fast Corner

|900 MHz|1.7 GHz|2.0 GHz|
|---|---|---|
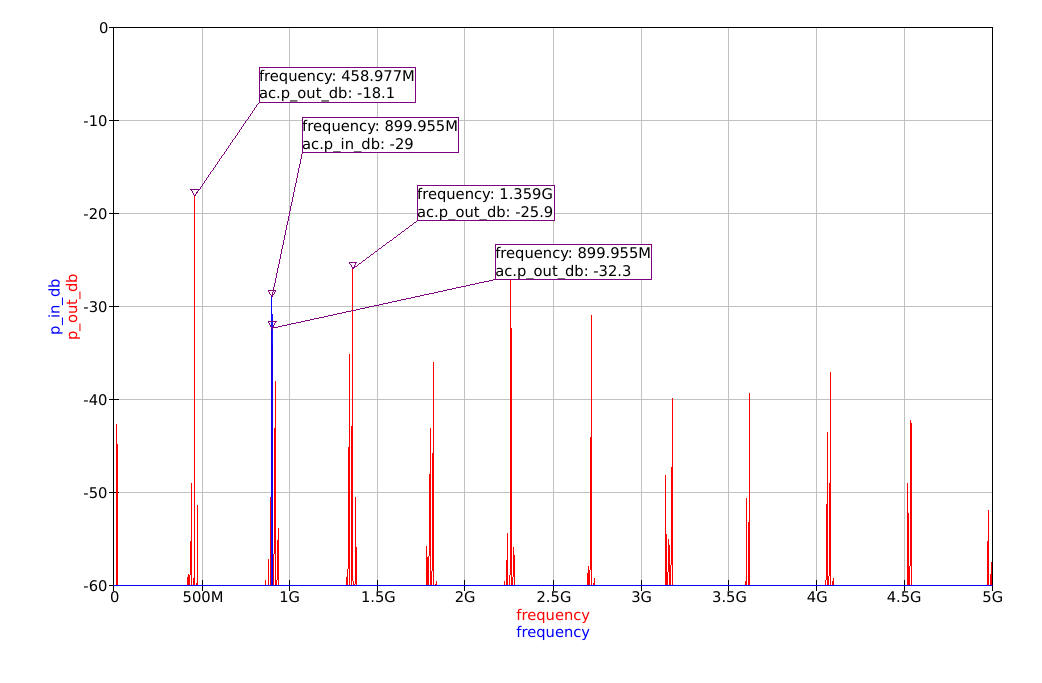
[picture p61: Images/LNB_Gain_0p9G_FF.png]
Gain
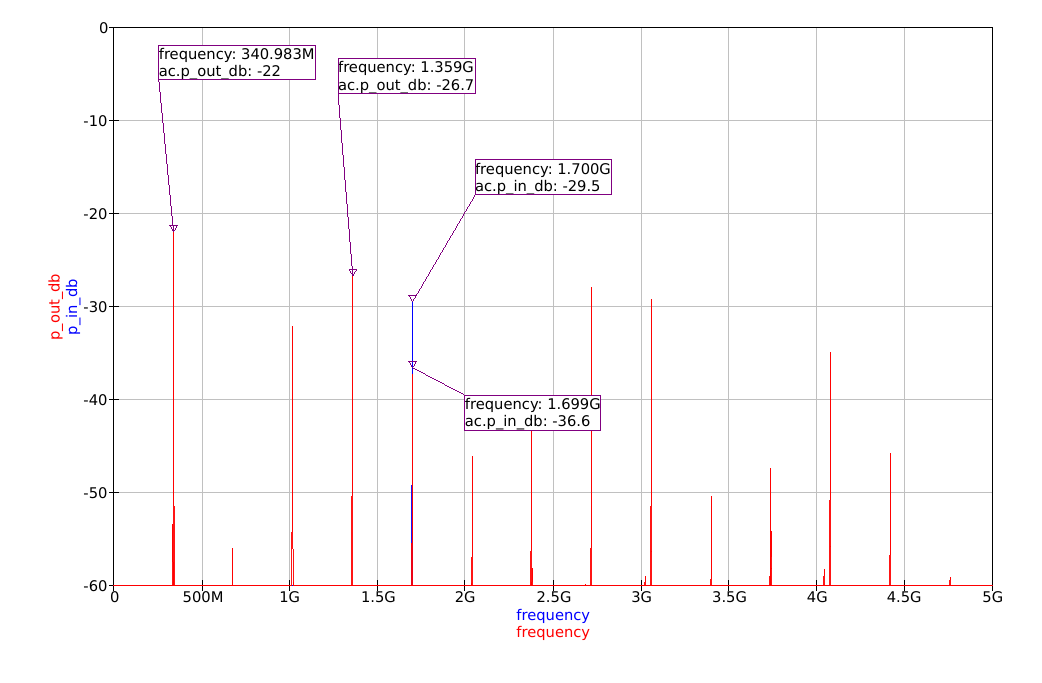
[picture p62: Images/LNB_Gain_1p7G_FF.png]
Gain
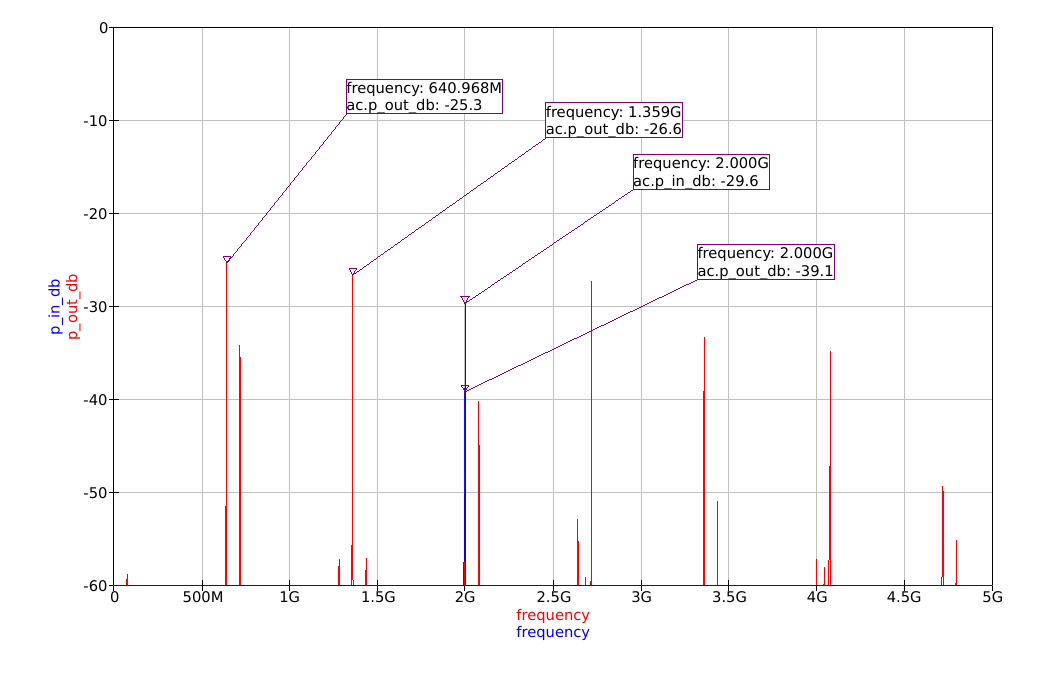
[picture p63: Images/LNB_Gain_2p0G_FF.png]
Gain
||||

### Slow-Fast Corner

|900 MHz|1.7 GHz|2.0 GHz|
|---|---|---|
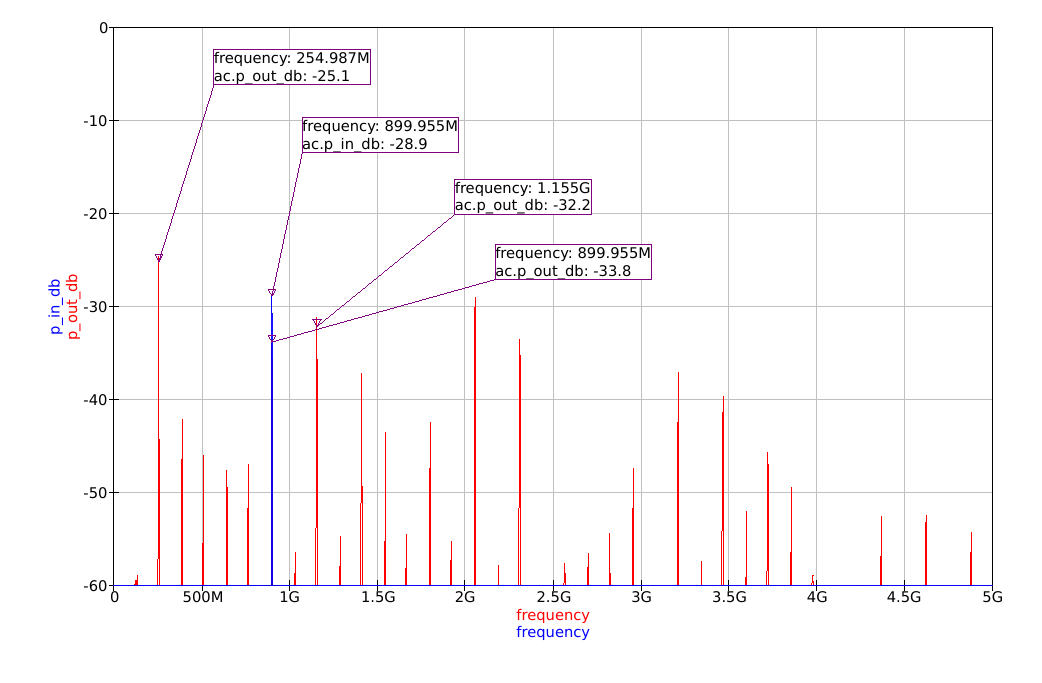
[picture p64: Images/LNB_Gain_0p9G_SF.png]
Gain
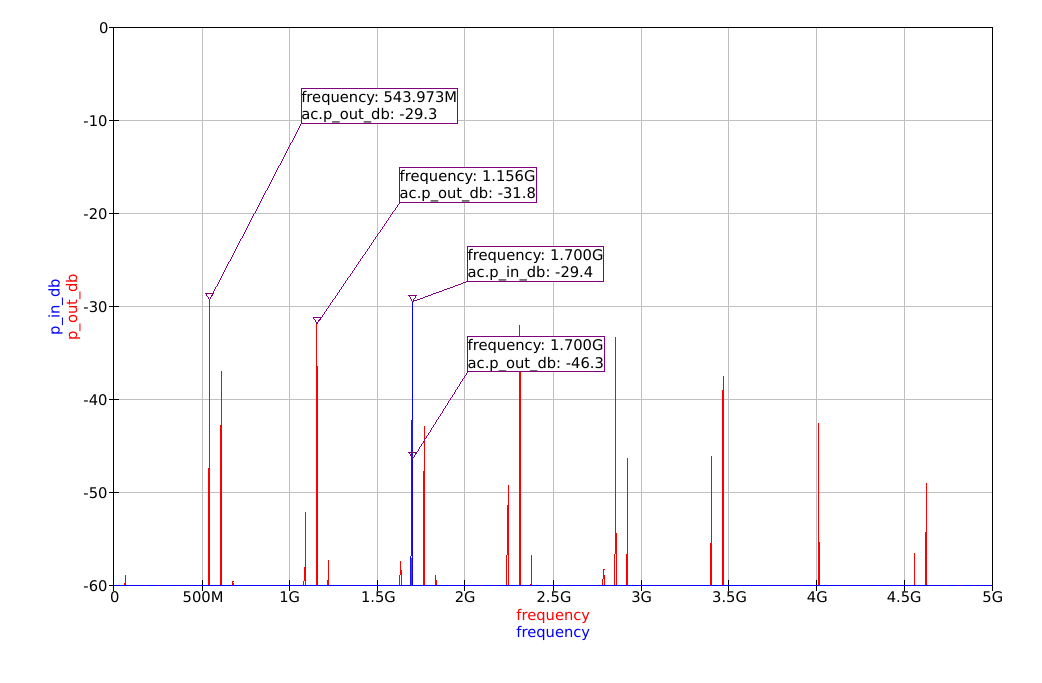
[picture p65: Images/LNB_Gain_1p7G_SF.png]
Gain
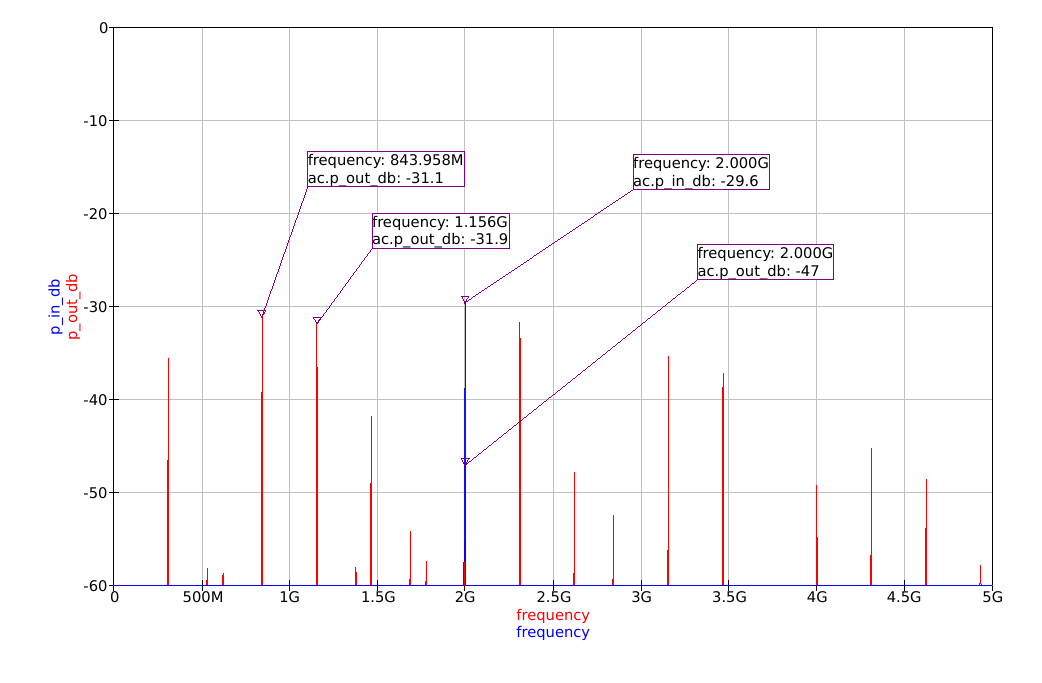
[picture p66: Images/LNB_Gain_2p0G_SF.png]
Gain
||||

### Fast-Slow Corner

|900 MHz|1.7 GHz|2.0 GHz|
|---|---|---|
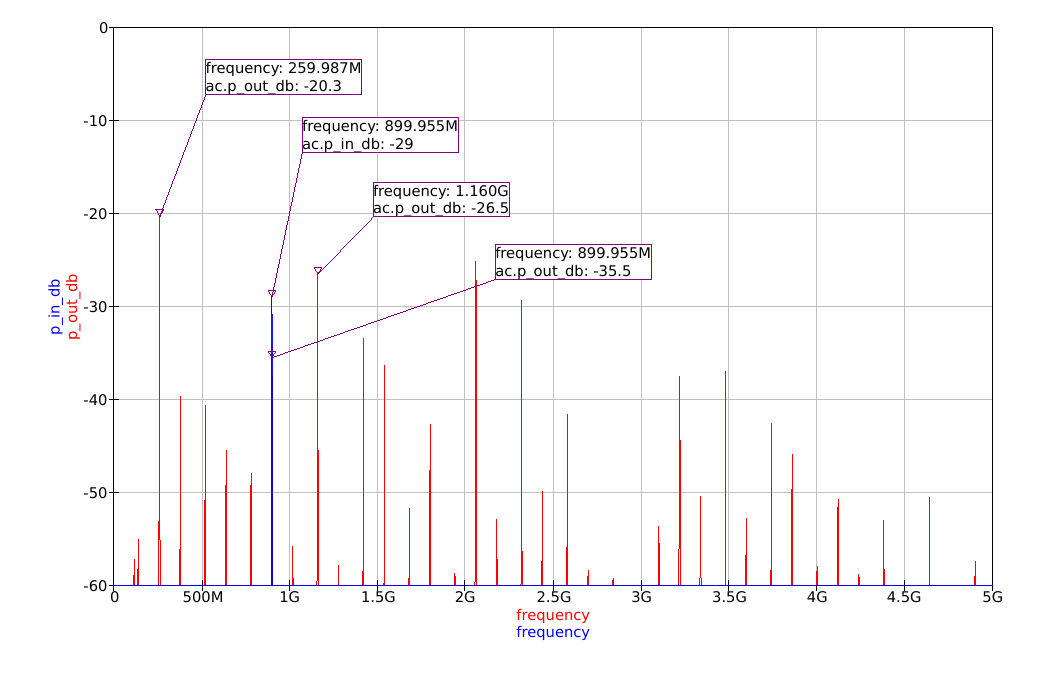
[picture p67: Images/LNB_Gain_0p9G_FS.png]
Gain
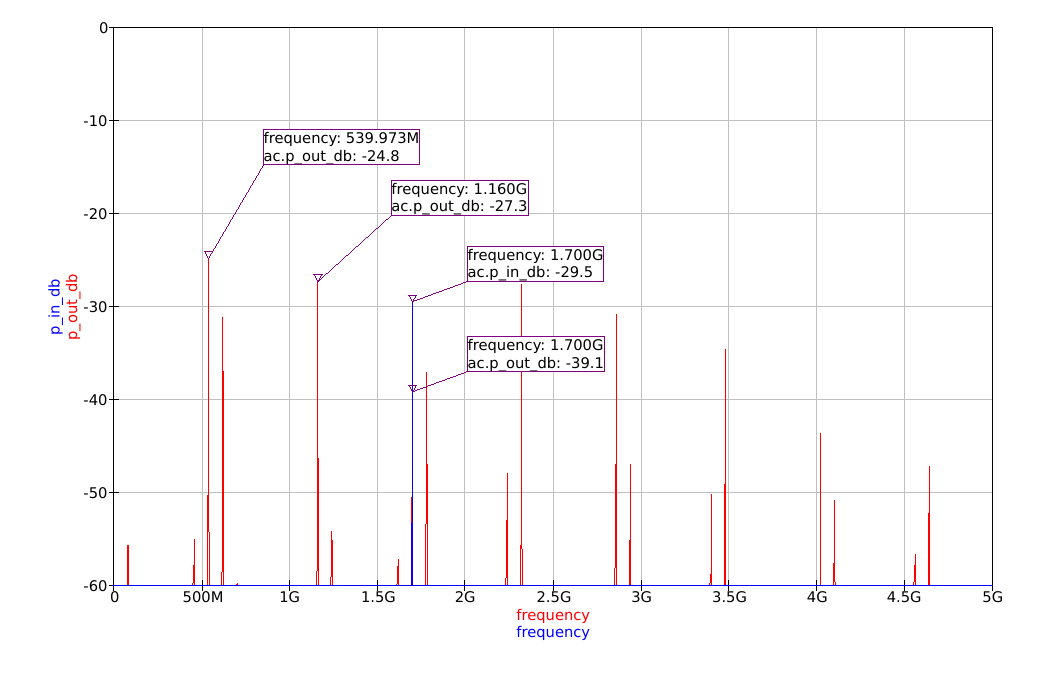
[picture p68: Images/LNB_Gain_1p7G_FS.png]
Gain
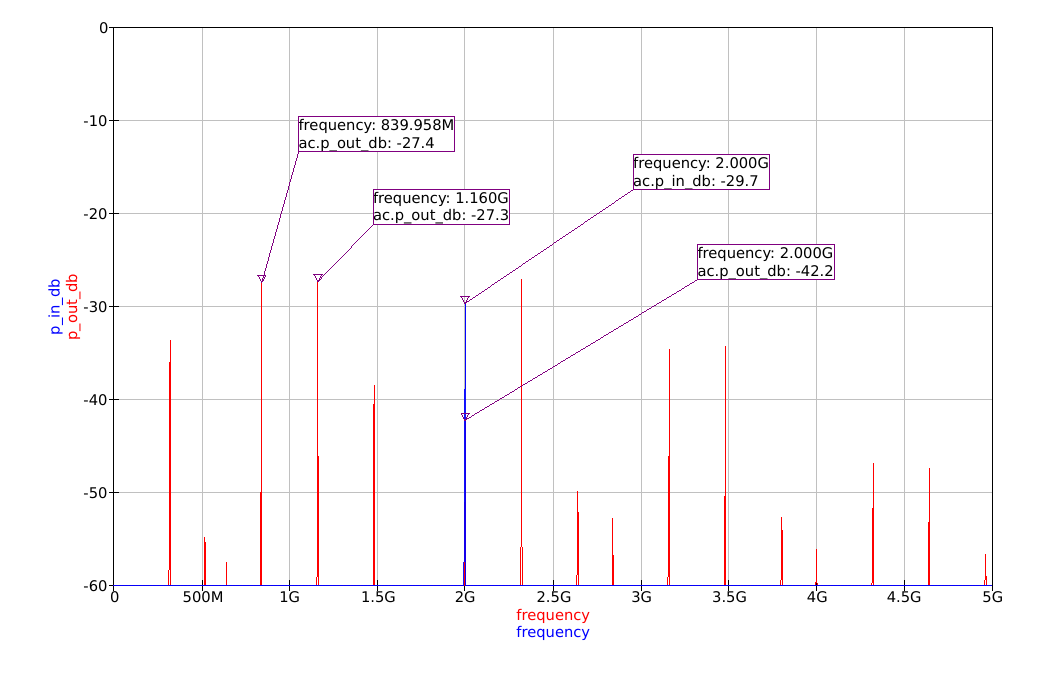
[picture p69: Images/LNB_Gain_2p0G_FS.png]
Gain
||||

## Compression Test Bench
*The newest topology is not fully characterized yet*

## Linearity Test Bench
*The newest topology is not fully characterized yet*

## Power Consumption Test Bench
*The newest topology is not fully characterized yet*

## Supply Test Bench
*The newest topology is not fully characterized yet*

## Temperature Test Bench
*The newest topology is not fully characterized yet*
