rcyaon/cmos-lnb/Schematic/LDO/Characterization.md

# Biasing Reference Supply

*Most Up-To-Date Schematic: Schematic/LDO/Reference.sch*

This characterization assumes an ideally stable 1.2V supply because the performance of the GF180MCU harness band gap reference design remains unclear.  In actuality, many of these performance metrics may be limited by the stability of the band gap reference.  Testing was performed with the reference supply unloaded because the biased transistor gates provide nearly no additional loading to the reference.

## Rise Time Test Bench

*Most Up-To-Date Schematic: Schematic/LDO/LDO_Testing_Rise_Time_MkI.sch*

The voltage reference takes at most 500 nS to stabilize, reaching the desired steady output voltage.

### Typical 
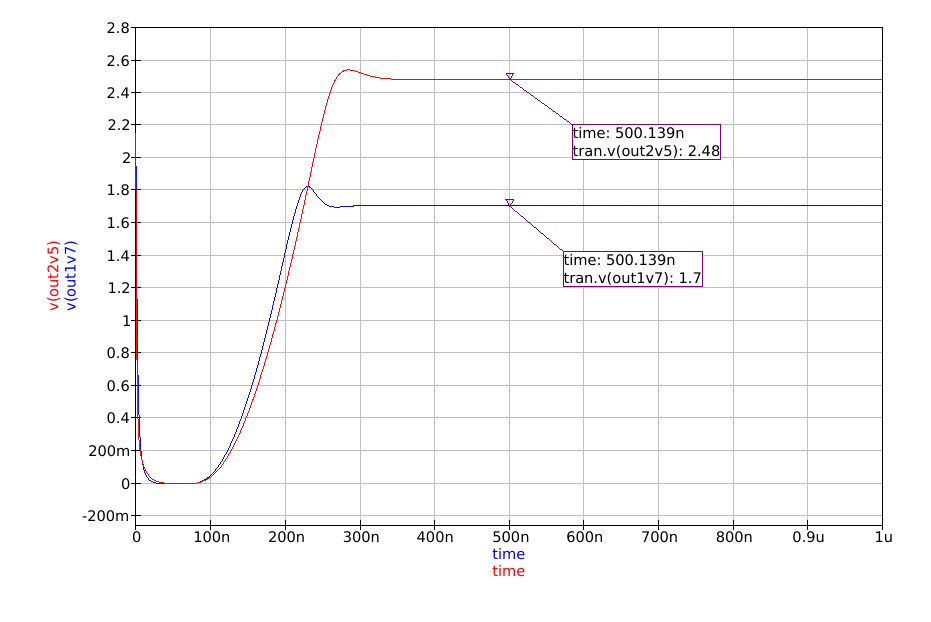
[picture p84: Images/Reference_Rise_Time_TT.png]
Rise Time


### Slow-Slow Corner

Rise Time

### Fast-Fast Corner

Rise Time

### Slow-Fast Corner

Rise Time

### Fast-Slow Corner

Rise Time

## Supply Voltage Test Bench

*Most Up-To-Date Schematic: Schematic/LDO/LDO_Testing_Supply_MkI.sch*

The bias supply reference remains functional and stable between 3V and 4V.

### Typical 
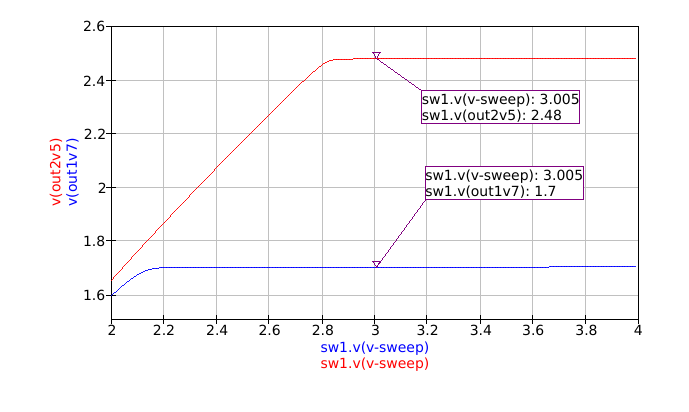
[picture p85: Images/Reference_Supply_TT.png]
Supply


### Slow-Slow Corner

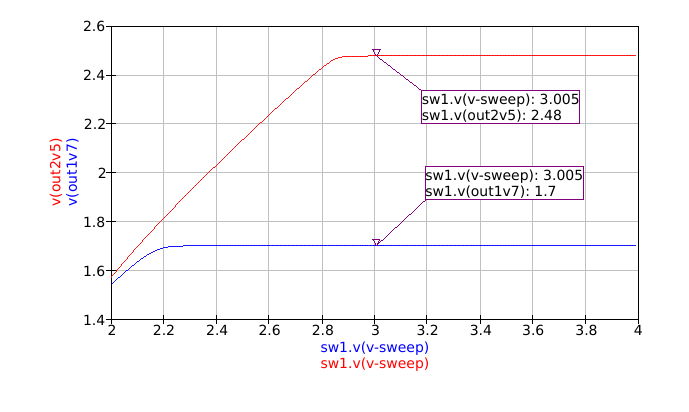
[picture p86: Images/Reference_Supply_SS.png]
Supply


### Fast-Fast Corner

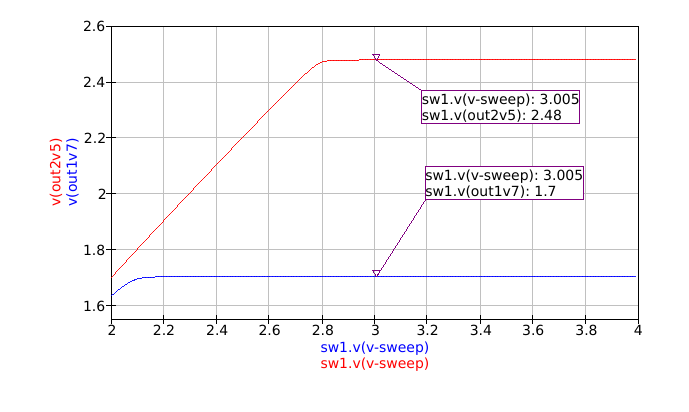
[picture p87: Images/Reference_Supply_FF.png]
Supply


### Slow-Fast Corner

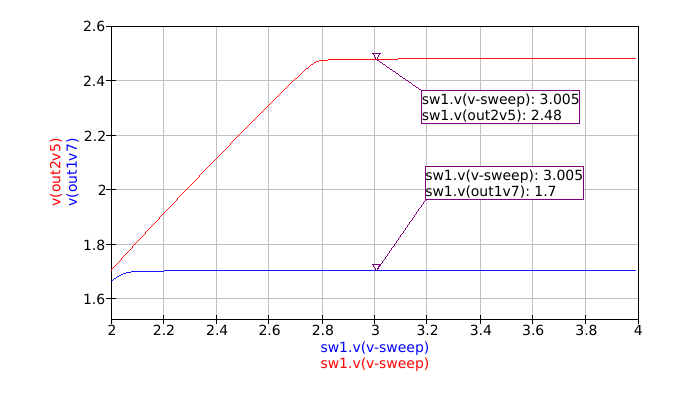
[picture p88: Images/Reference_Supply_SF.png]
Supply


### Fast-Slow Corner

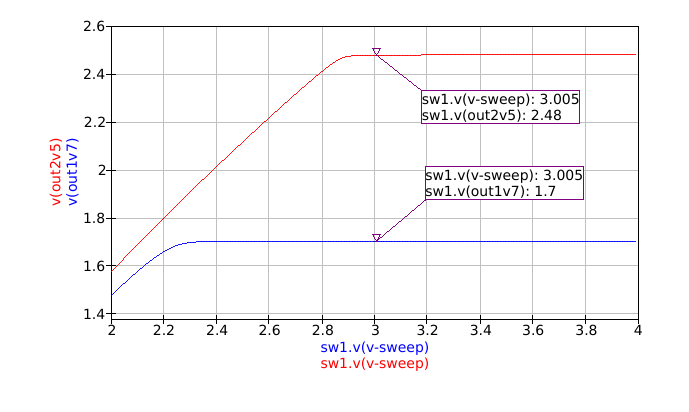
[picture p89: Images/Reference_Supply_FS.png]
Supply


## Temperature Sweep Test Bench

*Most Up-To-Date Schematic: Schematic/LDO/LDO_Testing_Temp_MkI.sch*

Temperature was swept over the automotive span of -25 C to 125 C.  The LDO remained stable over the entire temperature span.

### Typical 
| 1.7 V | 2.5 V |
|---|---|
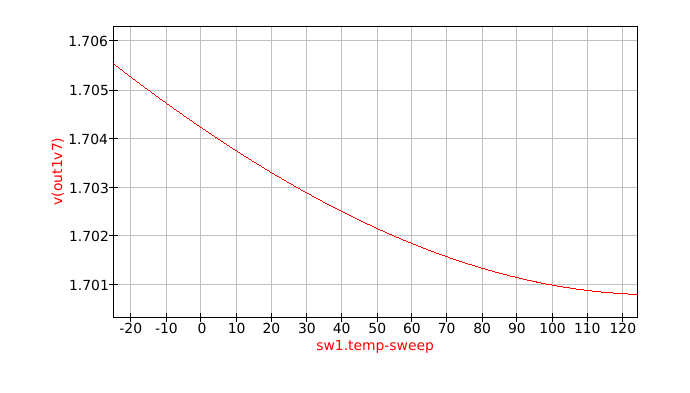
[picture p90: Images/Reference_Temp_1v7_TT.png]
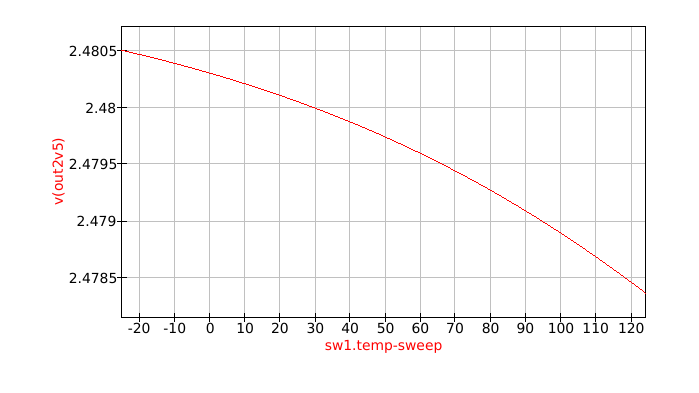
[picture p91: Images/Reference_Temp_2v5_TT.png]
|||

### Slow-Slow Corner
| 1.7 V | 2.5 V |
|---|---|
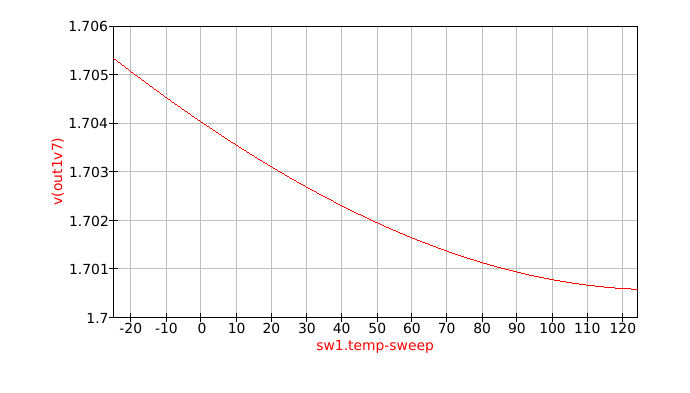
[picture p92: Images/Reference_Temp_1v7_SS.png]
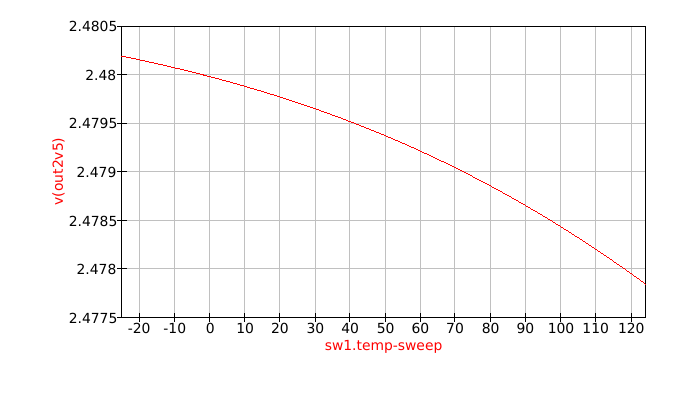
[picture p93: Images/Reference_Temp_2v5_SS.png]
|||

### Fast-Fast Corner
| 1.7 V | 2.5 V |
|---|---|
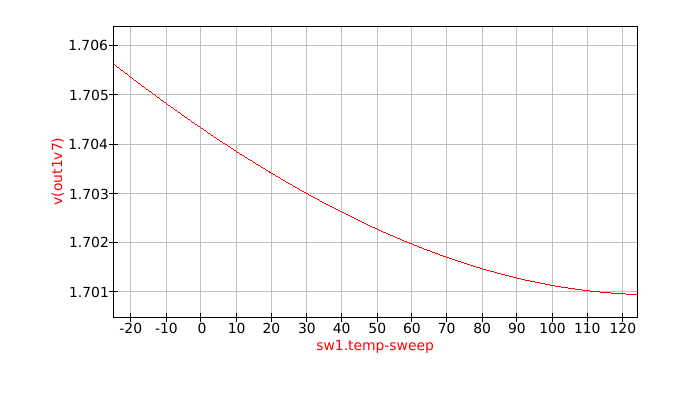
[picture p94: Images/Reference_Temp_1v7_FF.png]
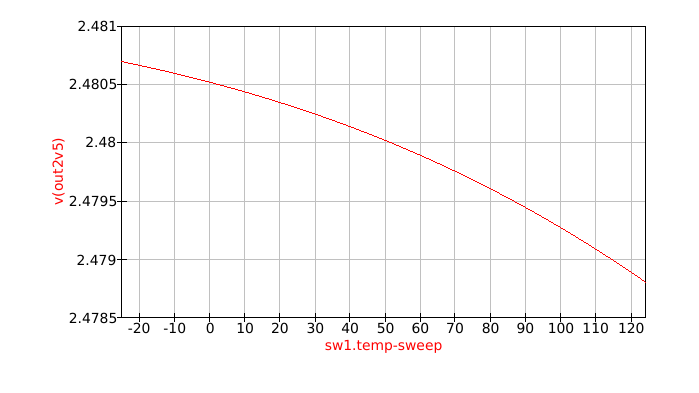
[picture p95: Images/Reference_Temp_2v5_FF.png]
|||

### Slow-Fast Corner
| 1.7 V | 2.5 V |
|---|---|
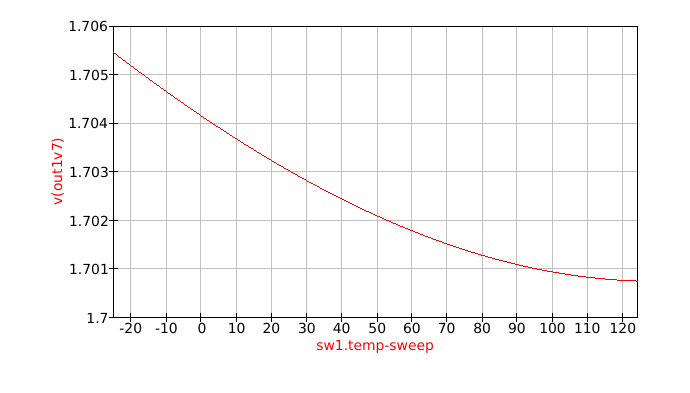
[picture p96: Images/Reference_Temp_1v7_SF.png]
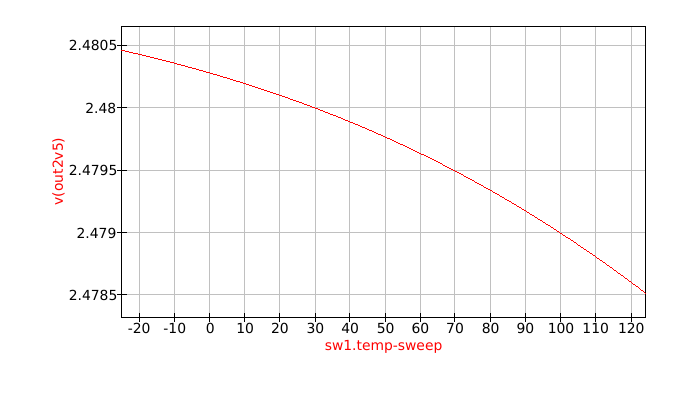
[picture p97: Images/Reference_Temp_2v5_SF.png]
|||

### Fast-Slow Corner
| 1.7 V | 2.5 V |
|---|---|
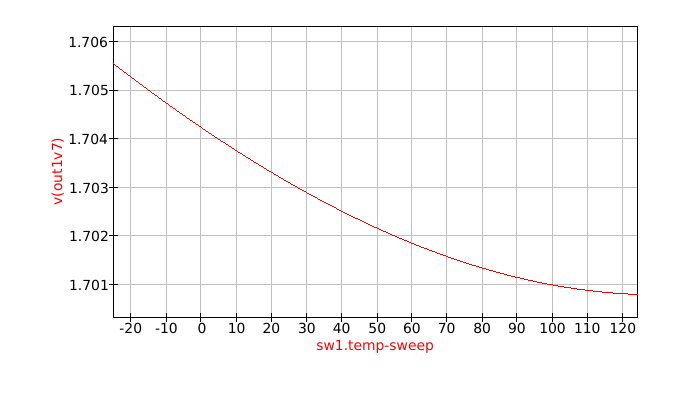
[picture p98: Images/Reference_Temp_1v7_FS.png]
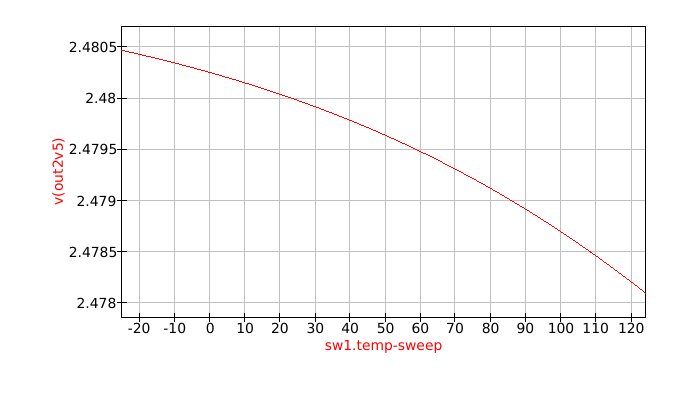
[picture p99: Images/Reference_Temp_2v5_FS.png]
|||

## Monte Carlo Mismatch Test Bench

*Most Up-To-Date Schematic: Schematic/LDO/LDO_Monte_Carlo_MkI.sch*

A 3000 run Monte Carlo simulation was performed using the typical transistor corner in order to assess drift in the output due to transistor mismatch.  The results showed a 2 standard deviation drift of around ±10 mV.  This is more than enough for the bias supply.  This uses the worst-case die-to-die variance model.  It is likely matching would be better on transistors near each other on the same die.

### 1.7 V Reference

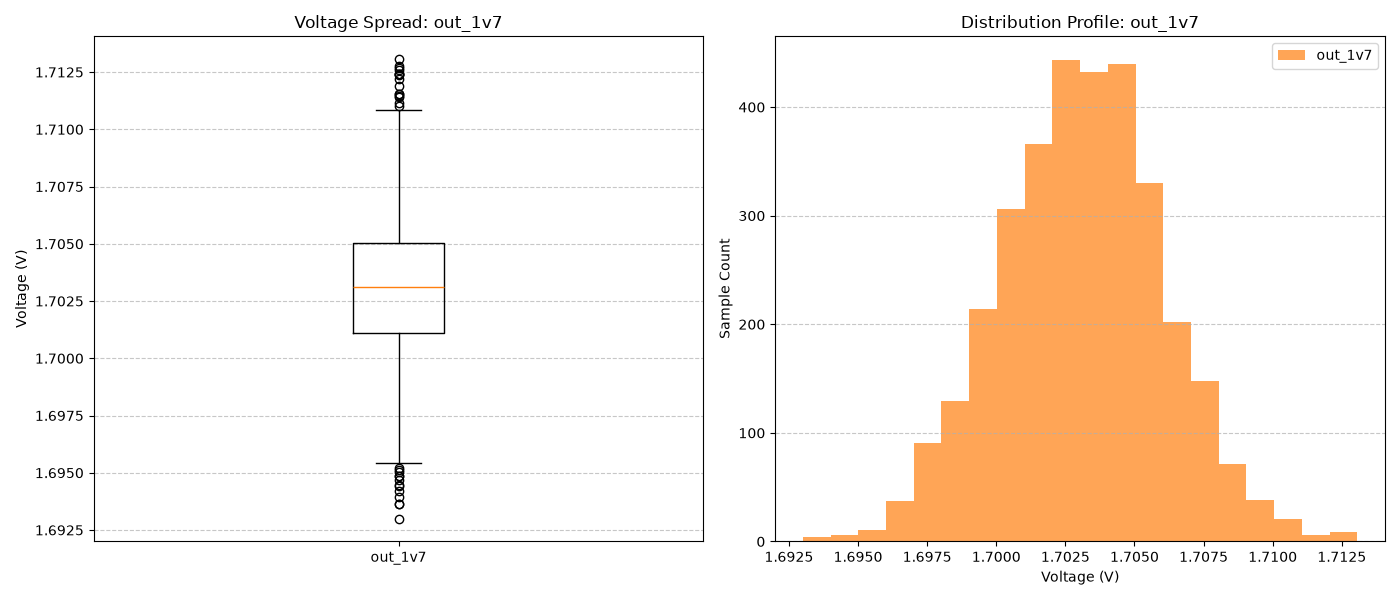
[picture p100: Images/MC_out_1v7_TT.png]


### 2.5 V Reference

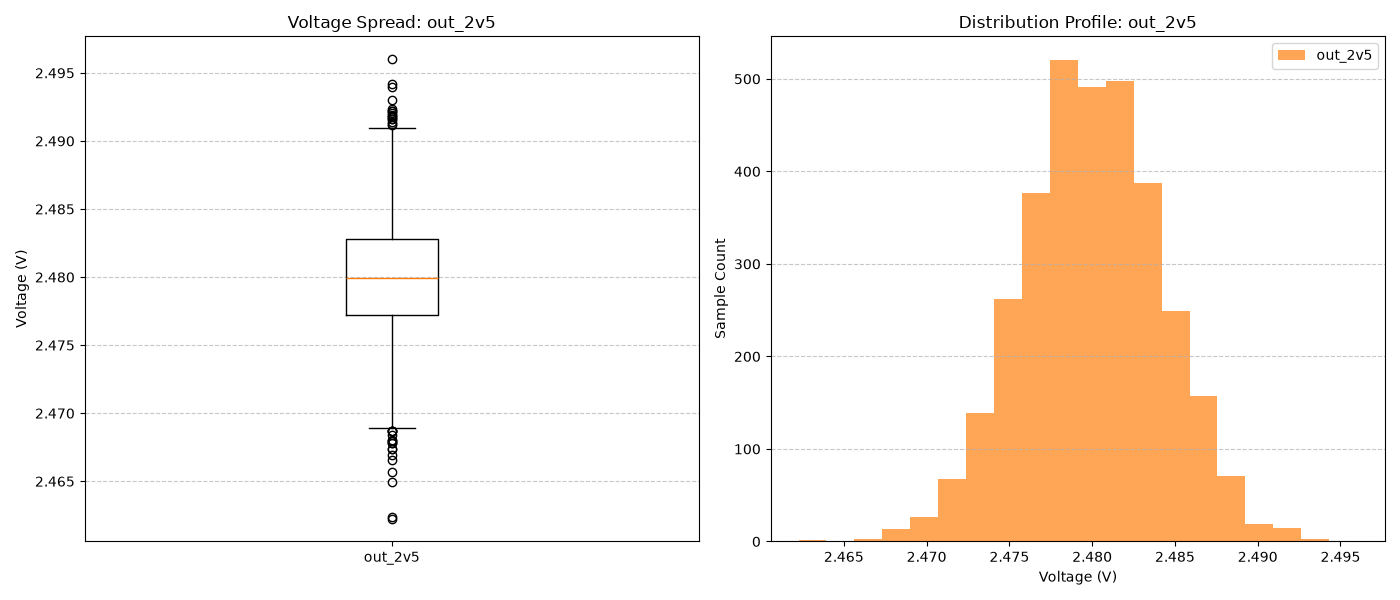
[picture p101: Images/MC_out_2v5_TT.png]
