rcyaon/cmos-lnb/Schematic/LNA/Characterization.md

# Low Noise Amplifier

LNA Block Diagram

*Most Up-To-Date Schematic: Schematic/LNA/LNAMkII.sch*

## S Parameter Test Bench

*Most Up-To-Date Test Bench: Schematic/LNA/LNA_Testing_S_Parameters_MkII.sch*

This testing was performed using the QUCS-S S paramter simulation utility.  It shows the linear response of the amplifier at all corners.

### Typical

| Parameter | Simulation |
|---|---|
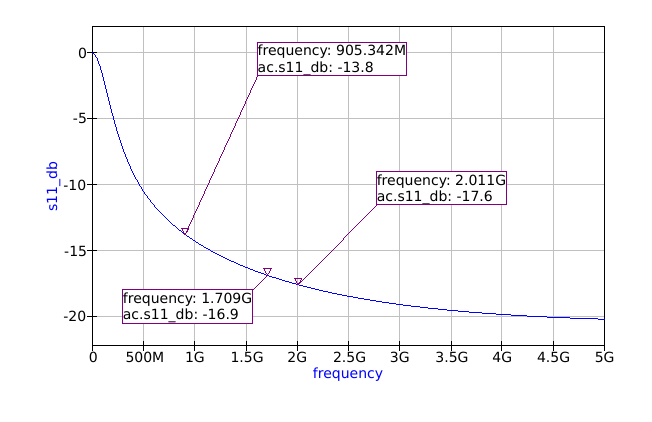
[picture p103: Images/LNA_S11_dB_TT.png]
|S11||
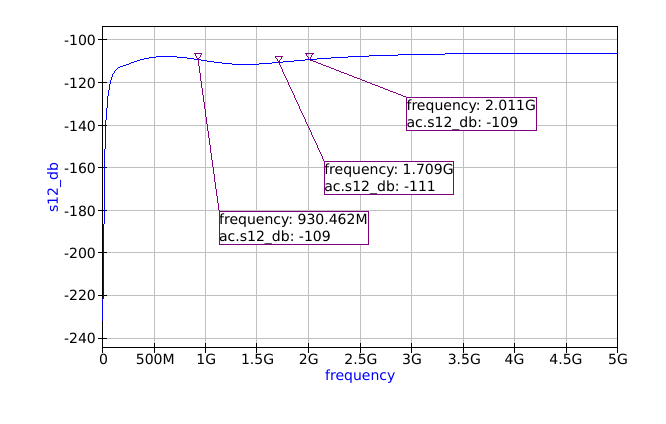
[picture p104: Images/LNA_S12_dB_TT.png]
|S12||
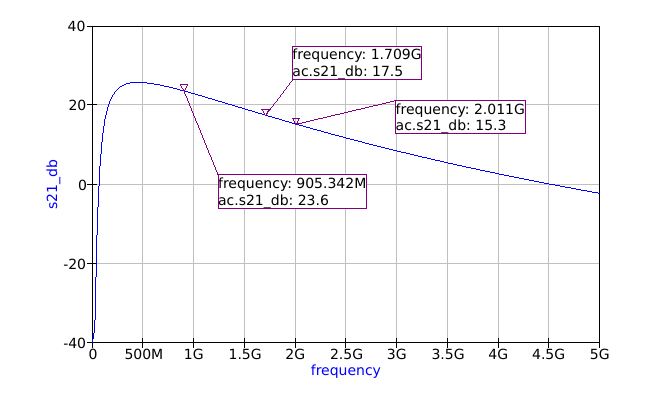
[picture p105: Images/LNA_S21_dB_TT.png]
|S21||
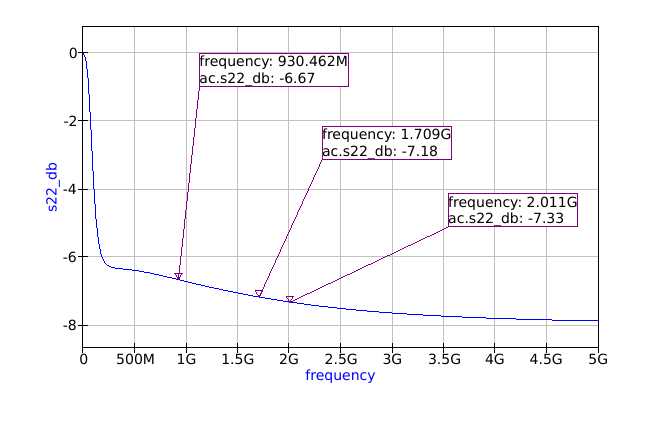
[picture p106: Images/LNA_S22_dB_TT.png]
|S22||
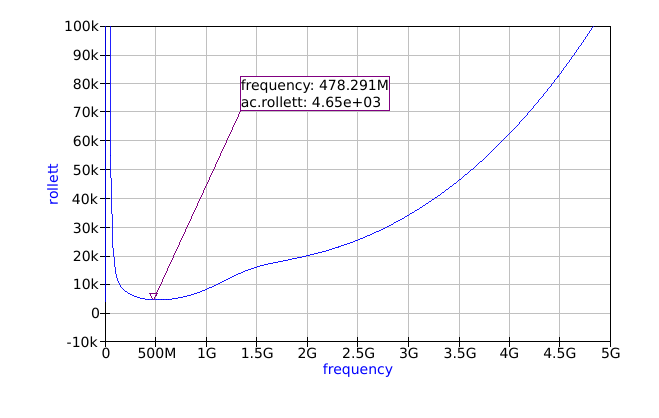
[picture p107: Images/LNA_Rollett_TT.png]
Rollett
|Rollett Stability Factor||
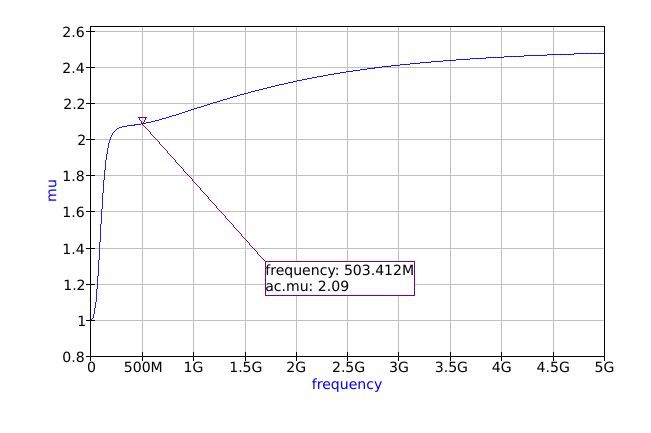
[picture p108: Images/LNA_Mu_TT.png]
|Mu Stability Factor||
|Noise Figure|Noise Figure|

### Slow-Slow Corner

| Parameter | Simulation |
|---|---|
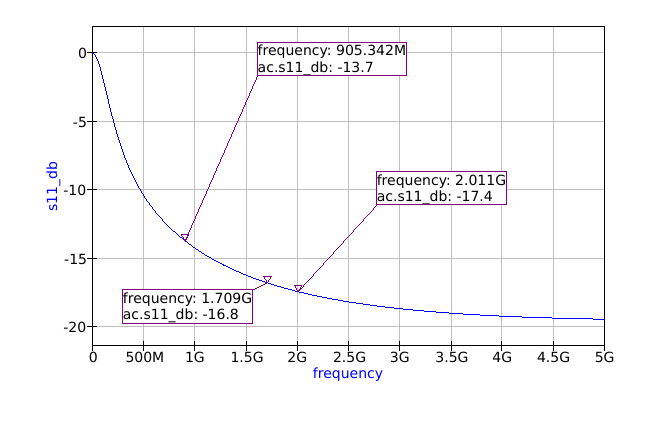
[picture p109: Images/LNA_S11_dB_SS.png]
|S11||
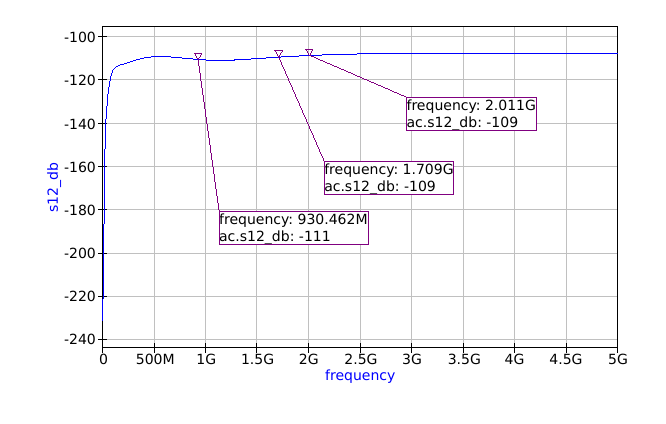
[picture p110: Images/LNA_S12_dB_SS.png]
|S12||
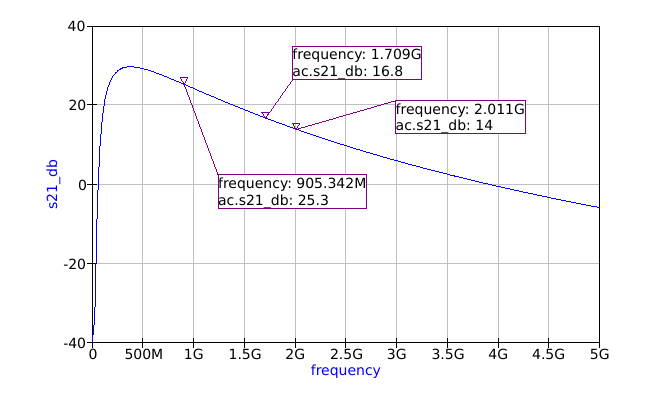
[picture p111: Images/LNA_S21_dB_SS.png]
|S21||
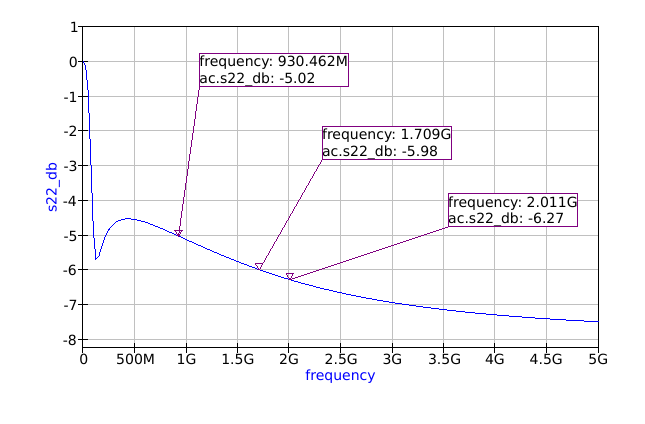
[picture p112: Images/LNA_S22_dB_SS.png]
|S22||
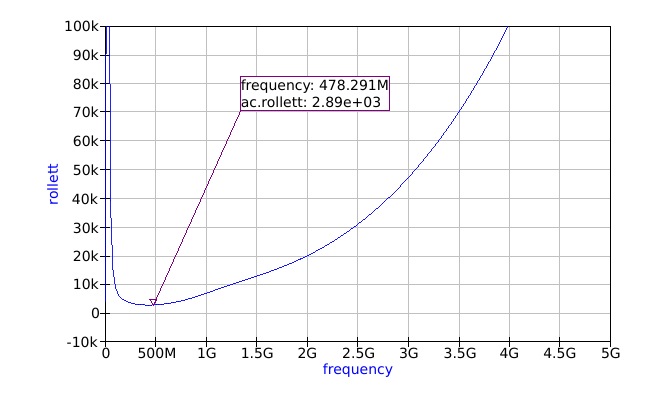
[picture p113: Images/LNA_Rollett_SS.png]
Rollett
|Rollett Stability Factor||
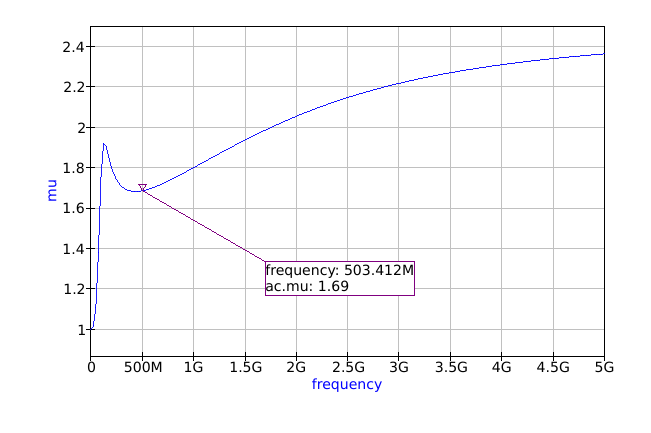
[picture p114: Images/LNA_Mu_SS.png]
|Mu Stability Factor||
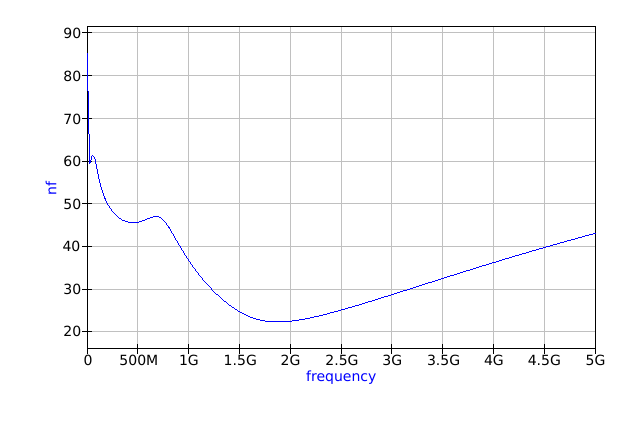
[picture p115: Images/LNA_Noise_Figure_SS.png]
Noise Figure
|Noise Figure||

### Fast-Fast Corner

| Parameter | Simulation |
|---|---|
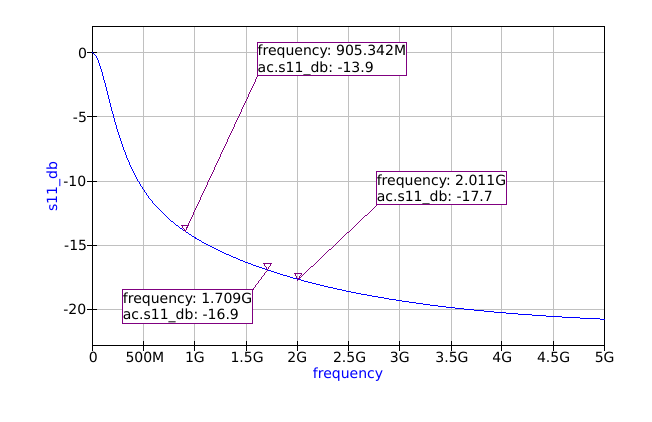
[picture p116: Images/LNA_S11_dB_FF.png]
|S11||
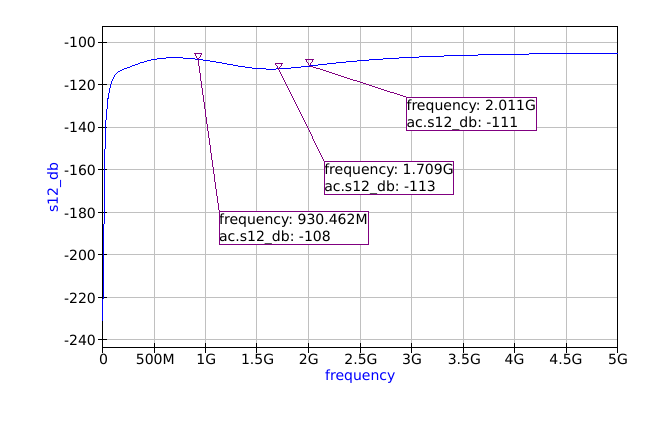
[picture p117: Images/LNA_S12_dB_FF.png]
|S12||
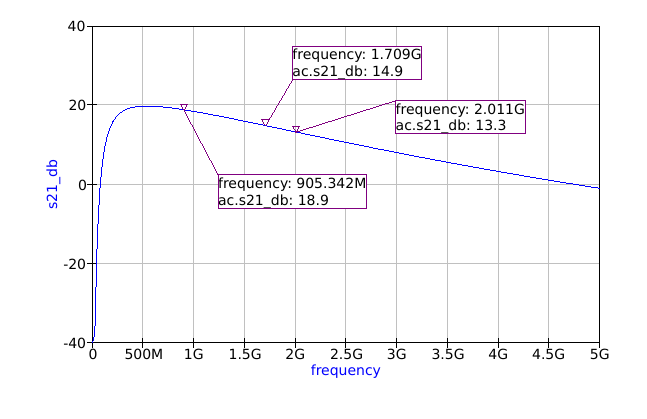
[picture p118: Images/LNA_S21_dB_FF.png]
|S21||
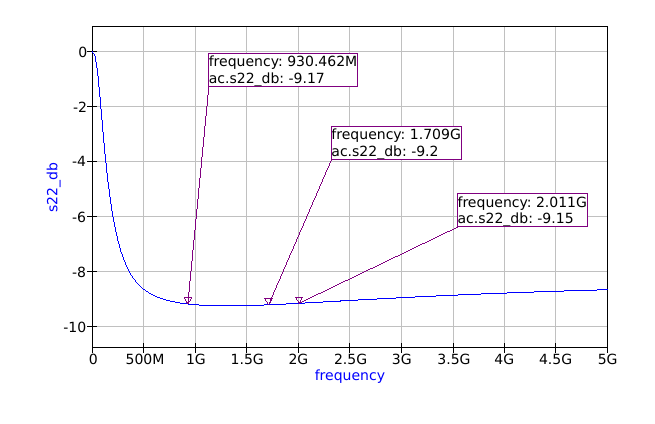
[picture p119: Images/LNA_S22_dB_FF.png]
|S22||
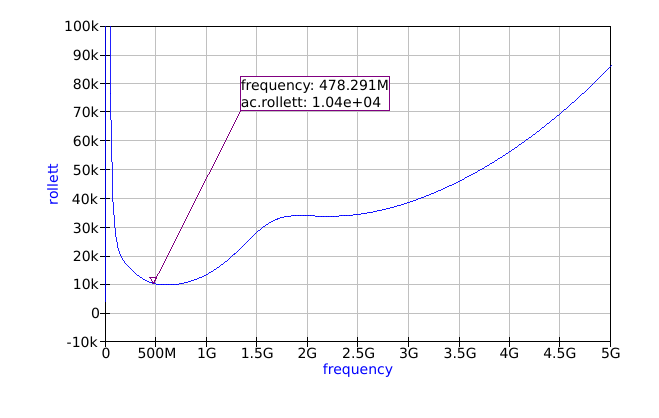
[picture p120: Images/LNA_Rollett_FF.png]
Rollett
|Rollett Stability Factor||
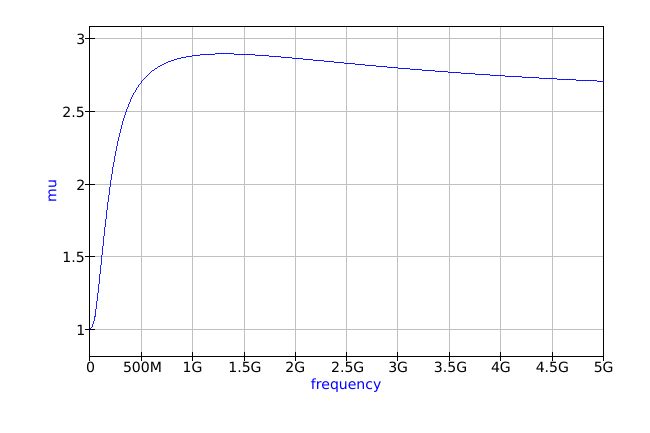
[picture p121: Images/LNA_Mu_FF.png]
|Mu Stability Factor||
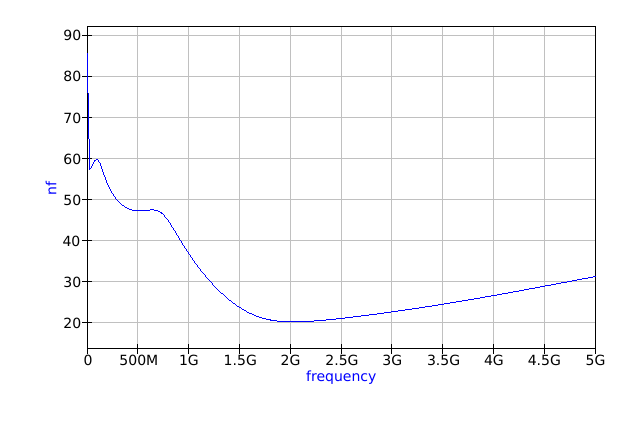
[picture p122: Images/LNA_Noise_Figure_FF.png]
Noise Figure
|Noise Figure||

### Slow-Fast Corner

| Parameter | Simulation |
|---|---|
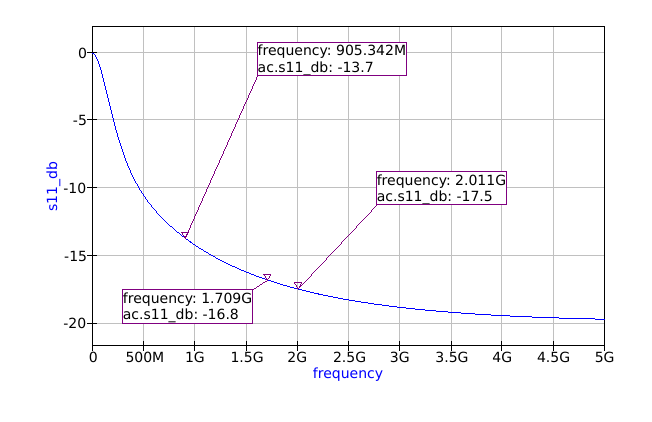
[picture p123: Images/LNA_S11_dB_SF.png]
|S11||
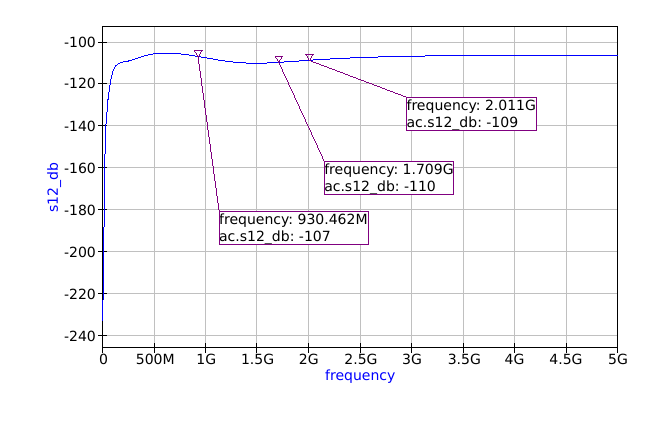
[picture p124: Images/LNA_S12_dB_SF.png]
|S12||
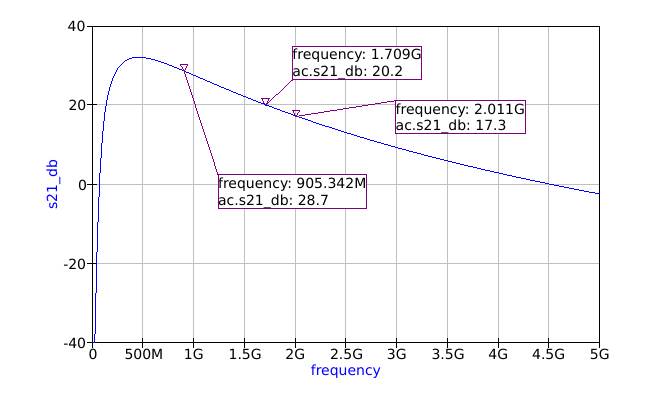
[picture p125: Images/LNA_S21_dB_SF.png]
|S21||
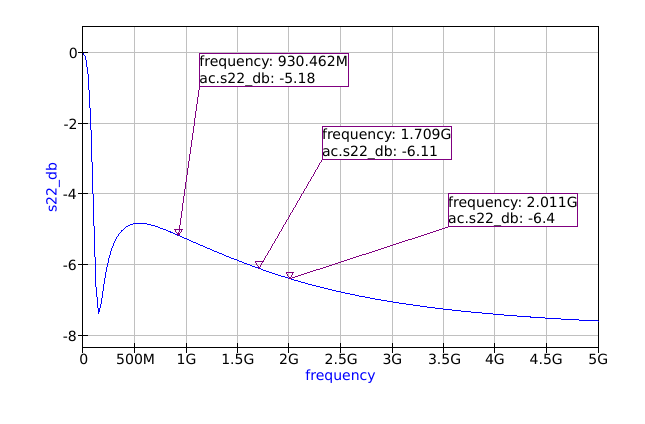
[picture p126: Images/LNA_S22_dB_SF.png]
|S22||
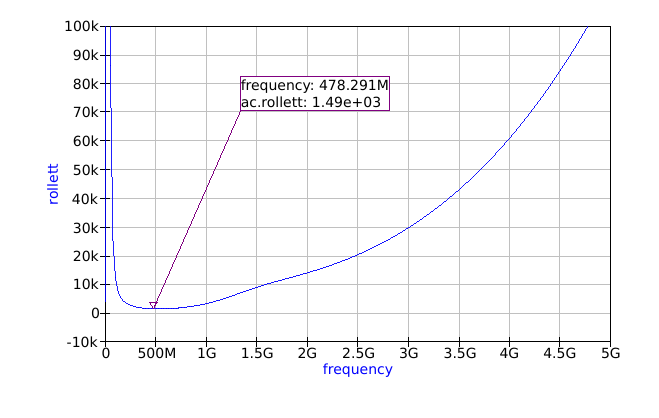
[picture p127: Images/LNA_Rollett_SF.png]
Rollett
|Rollett Stability Factor||
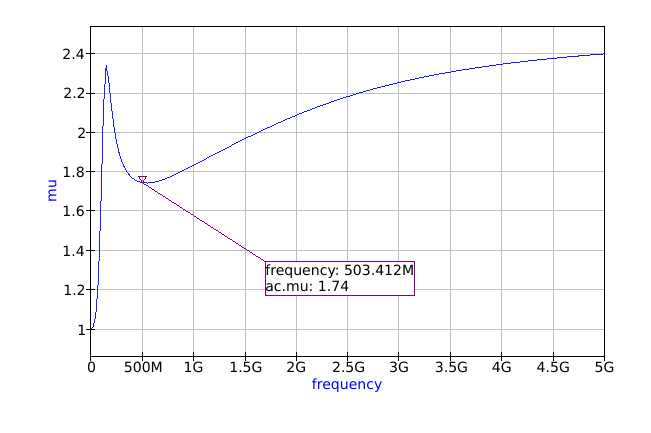
[picture p128: Images/LNA_Mu_SF.png]
|Mu Stability Factor||
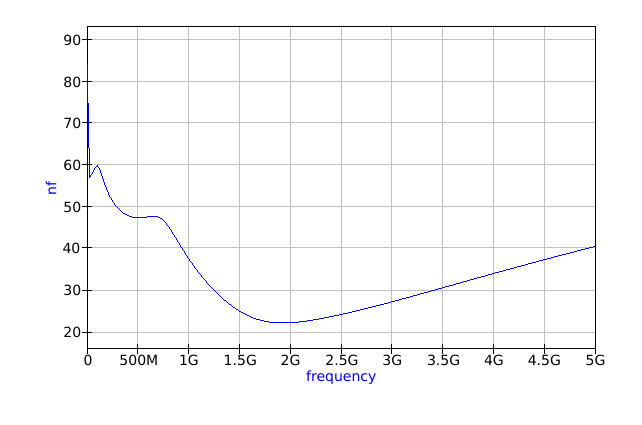
[picture p129: Images/LNA_Noise_Figure_SF.png]
Noise Figure
|Noise Figure||

### Fast-Slow Corner

| Parameter | Simulation |
|---|---|
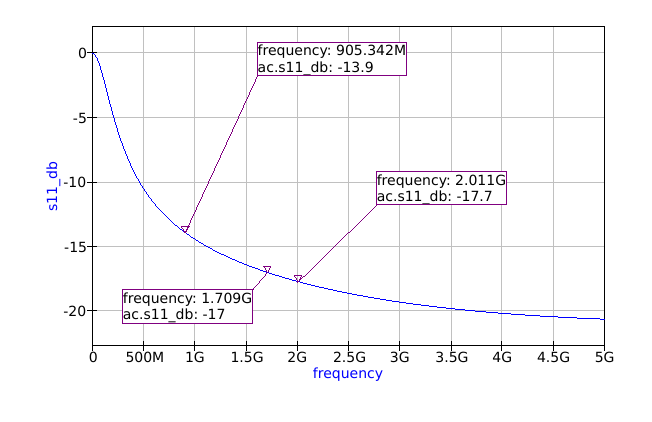
[picture p130: Images/LNA_S11_dB_FS.png]
|S11||
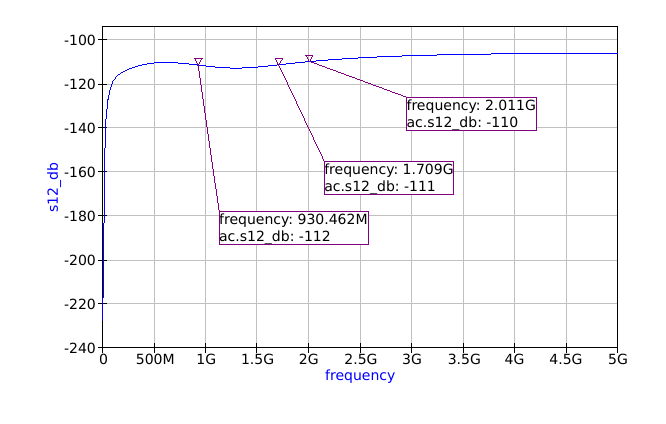
[picture p131: Images/LNA_S12_dB_FS.png]
|S12||
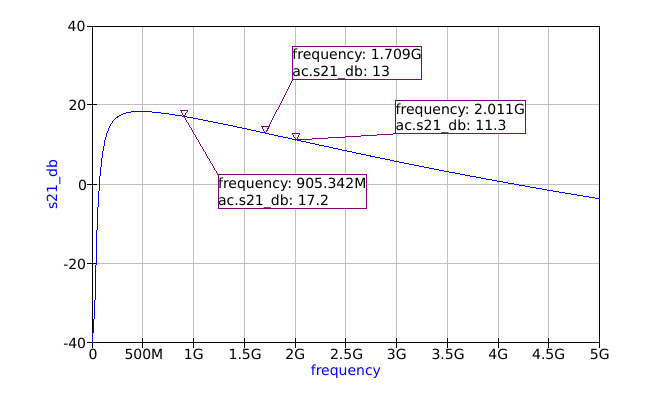
[picture p132: Images/LNA_S21_dB_FS.png]
|S21||
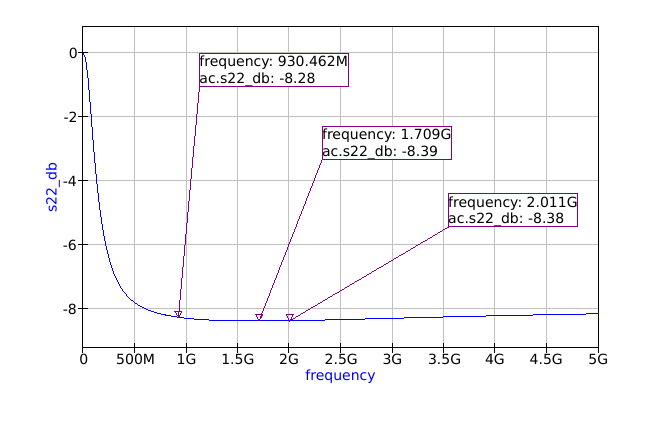
[picture p133: Images/LNA_S22_dB_FS.png]
|S22||
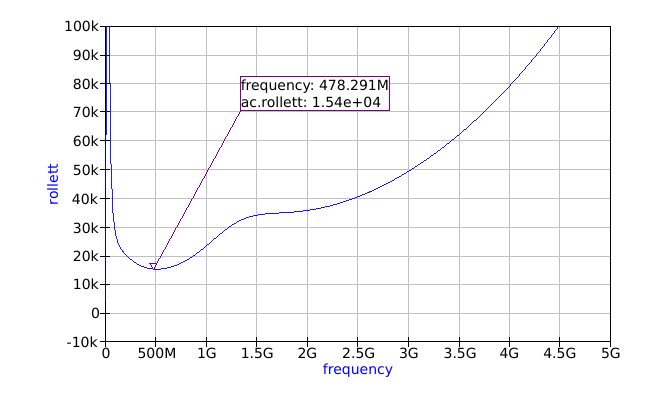
[picture p134: Images/LNA_Rollett_FS.png]
Rollett
|Rollett Stability Factor||
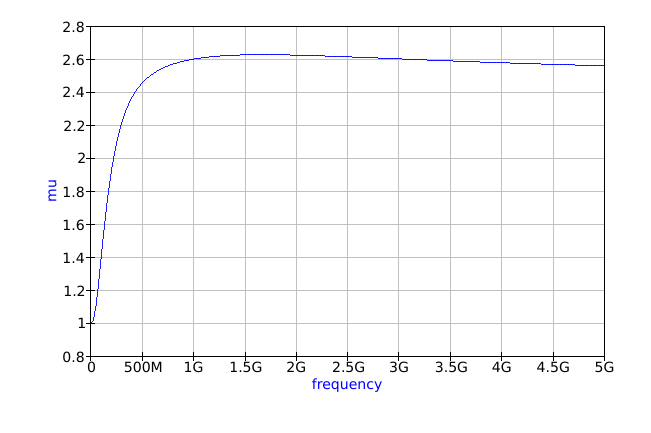
[picture p135: Images/LNA_Mu_FS.png]
|Mu Stability Factor||
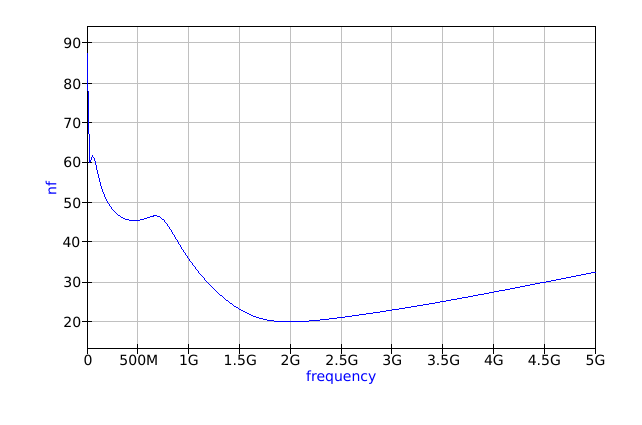
[picture p136: Images/LNA_Noise_Figure_FS.png]
Noise Figure
|Noise Figure||

## Compression Test Bench

*Most Up-To-Date Test Bench: Schematic/LNA/LNA_Testing_Compression_MkI.sch*

Gain compression testing was performed using a sweep of transient simulations, measuring the LNAs response to a tone at 1.7 GHz.  This gives the most accurate compression results.  Compression is clearly a weak spot for this design, sometimes compressing at output powers as low as -19 dBm.  This is one of the effects of degenerating the cascode drains in the middle gain stages to flatten the frequency response of the amplifier.  The degeneration limits the output power.

### Typical 
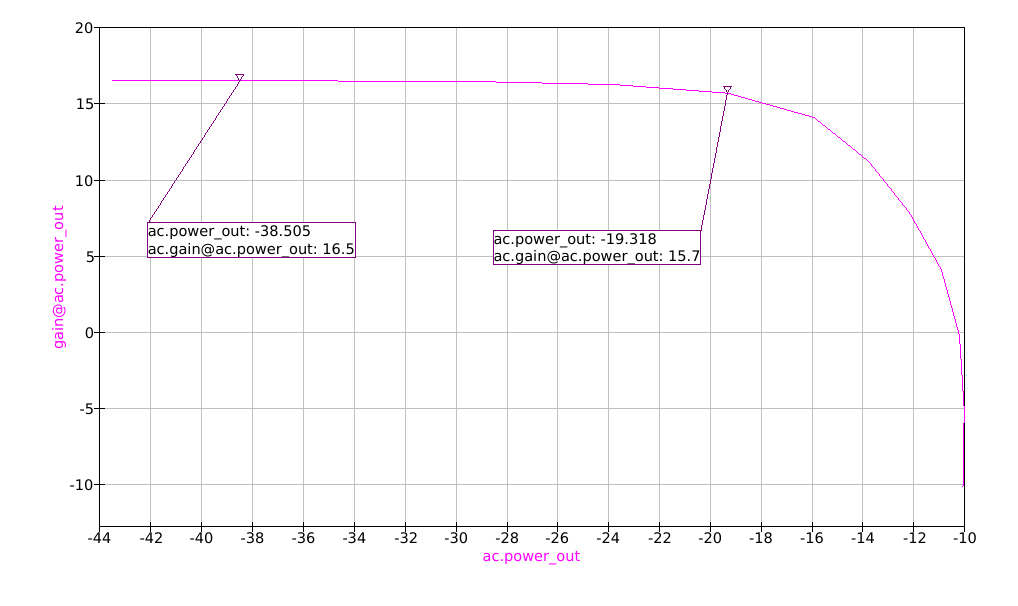
[picture p137: Images/LNA_Compression_TT.png]
Compression


|Parameter|Value|
|---|-----|
| OP1dB | -19.3 dBm |

### Slow-Slow Corner

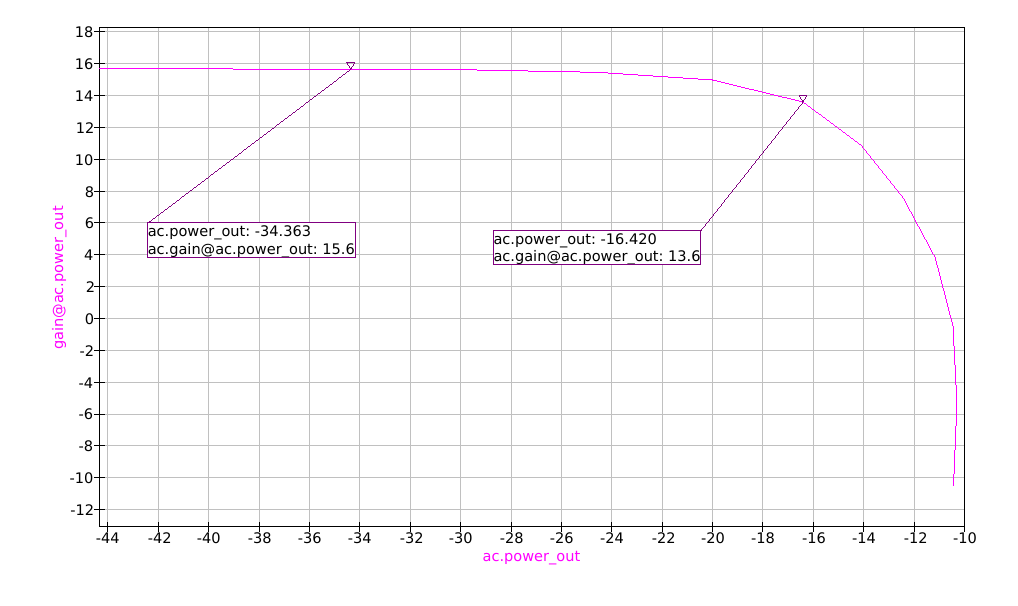
[picture p138: Images/LNA_Compression_SS.png]
Compression


|Parameter|Value|
|---|-----|
| OP1dB | -16.4 dBm |

### Fast-Fast Corner

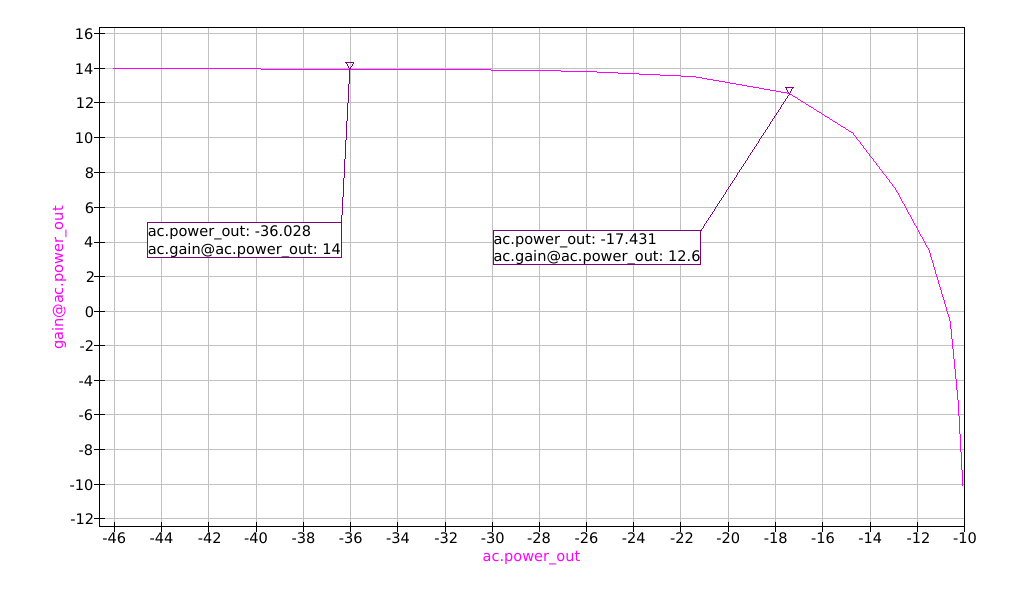
[picture p139: Images/LNA_Compression_FF.png]
Compression


|Parameter|Value|
|---|-----|
| OP1dB | -17.4 dBm |

### Slow-Fast Corner

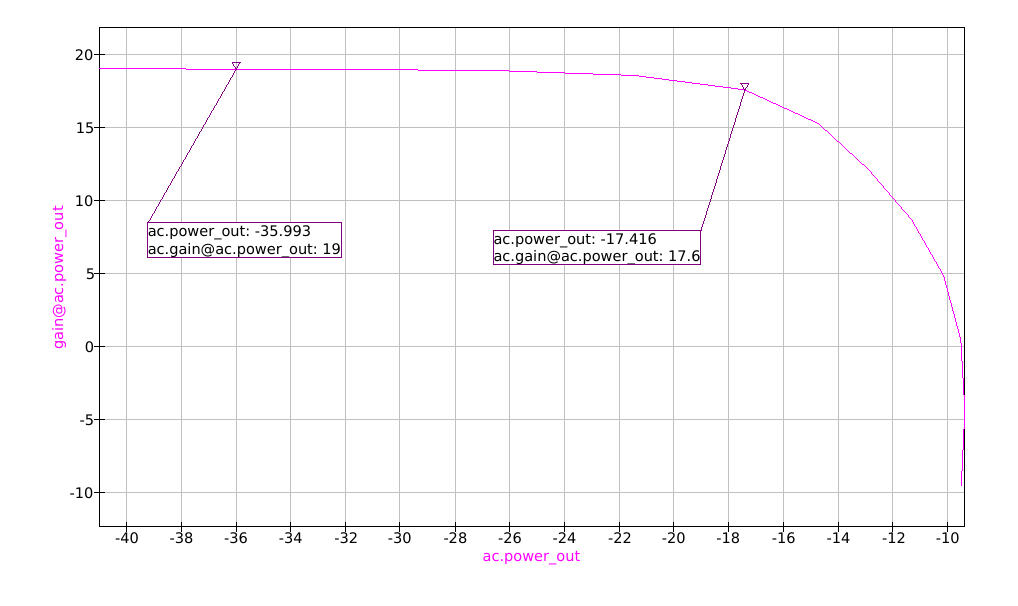
[picture p140: Images/LNA_Compression_SF.png]
Compression


|Parameter|Value|
|---|-----|
| OP1dB | -17.4 dBm |

### Fast-Slow Corner

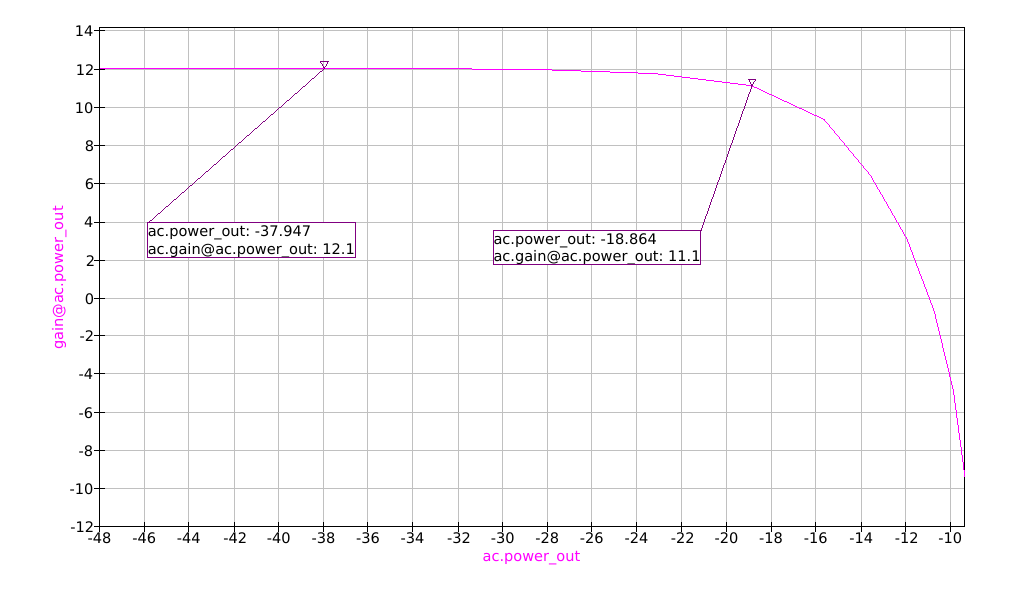
[picture p141: Images/LNA_Compression_FS.png]
Compression


|Parameter|Value|
|---|-----|
| OP1dB | -18.9 dBm |

## Linearity Test Bench

*Most Up-To-Date Test Bench: Schematic/LNA/LNA_Testing_Linearity_MkI.sch*

Linearity of the amplifier was assessed using a standard two tone test characterizing third order intermodulation products at ~1.7 GHz.  The test was performed at two different power input levels, -20 dBm and -30 dBm.  Interestingly, higher input power seemed to improve linearity slightly.  Both of these power levels are significantly far away from the compression point of the amplifier, so there were not concerns of beginning to compress any stages of the amplifier.

The "CalculateOIP3.py" file was used to calculate the amplifier OIP3 from the extracted linearity. 

### Typical 
| Low Power (-30 dBm) | High Power (-20dBm) |
|---|---|
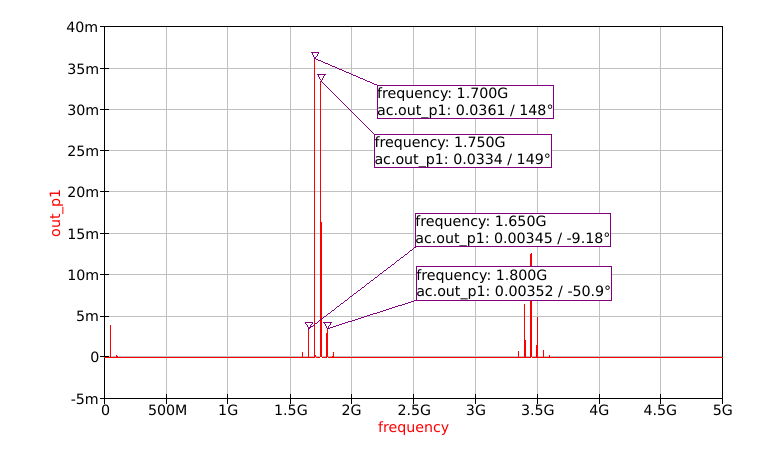
[picture p142: Images/LNA_Linearity_TT.png]
Linearity
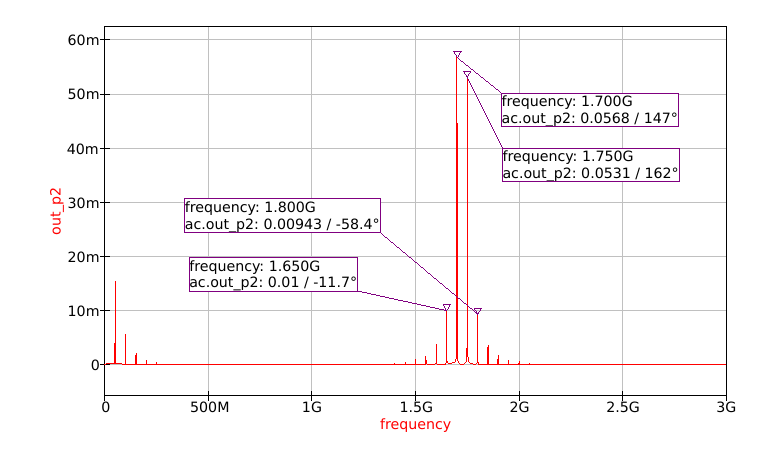
[picture p143: Images/LNA_Linearity_TT_HP.png]
Linearity
|||

#### Low Power (-30 dBm)
|Parameter|Value|
|---|-----|
|P<sub>low</sub>| -18.8 dBm |
|P<sub>high</sub>| -19.5 dBm |
|IM3<sub>low</sub>| -39.2 dBm |
|IM3<sub>high</sub>| -39.1 dBm |
|OIP3| -9.2 dBm |

#### High Power (-20 dBm)
|Parameter|Value|
|---|-----|
|P<sub>low</sub>| -14.9 dBm |
|P<sub>high</sub>| -15.5 dBm |
|IM3<sub>low</sub>| -30.0 dBm |
|IM3<sub>high</sub>| -30.6 dBm |
|OIP3| -7.7 dBm |

### Slow-Slow Corner
| Low Power (-30 dBm) | High Power (-20dBm) |
|---|---|
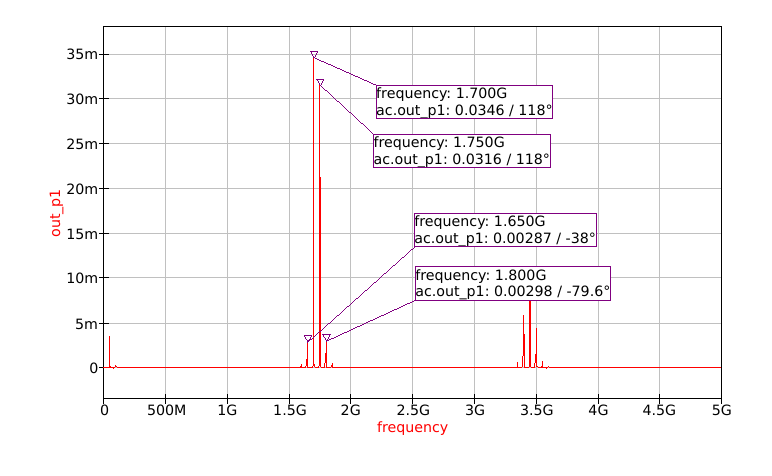
[picture p144: Images/LNA_Linearity_SS.png]
Linearity
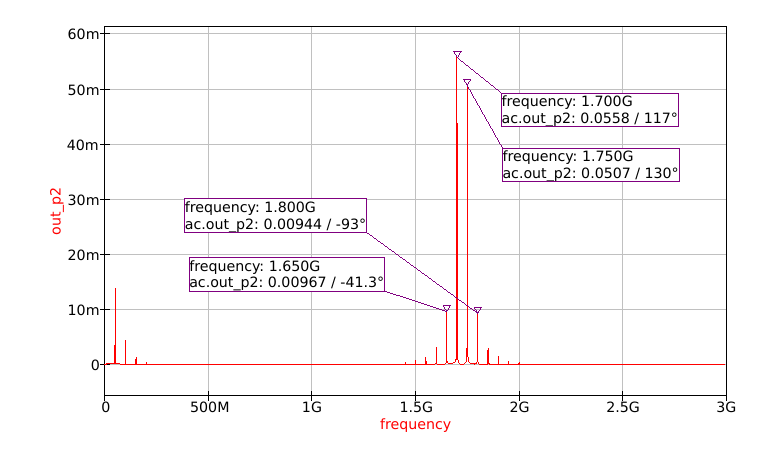
[picture p145: Images/LNA_Linearity_SS_HP.png]
Linearity
|||

#### Low Power (-30 dBm)
|Parameter|Value|
|---|-----|
|P<sub>low</sub>| -19.2 dBm |
|P<sub>high</sub>| -20.0 dBm |
|IM3<sub>low</sub>| -40.8 dBm |
|IM3<sub>high</sub>| -40.5 dBm |
|OIP3| -9.1 dBm |

#### High Power (-20 dBm)
|Parameter|Value|
|---|-----|
|P<sub>low</sub>| -15.1 dBm |
|P<sub>high</sub>| -15.9 dBm |
|IM3<sub>low</sub>| -30.3 dBm |
|IM3<sub>high</sub>| -30.5 dBm |
|OIP3| -8.0 dBm |

### Fast-Fast Corner
| Low Power (-30 dBm) | High Power (-20dBm) |
|---|---|
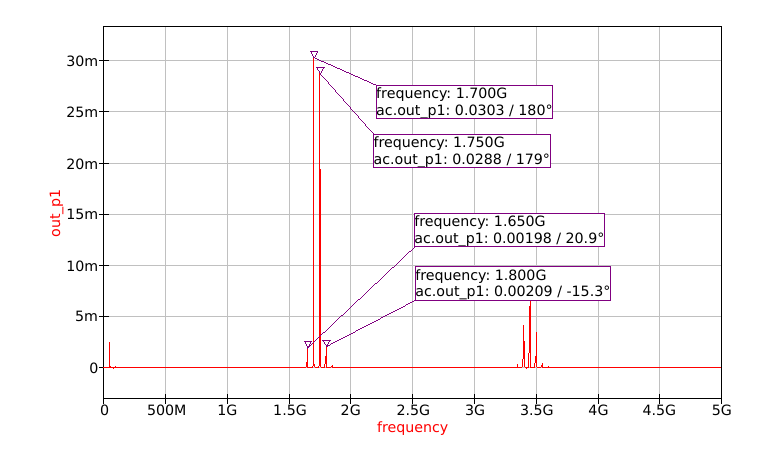
[picture p146: Images/LNA_Linearity_FF.png]
Linearity
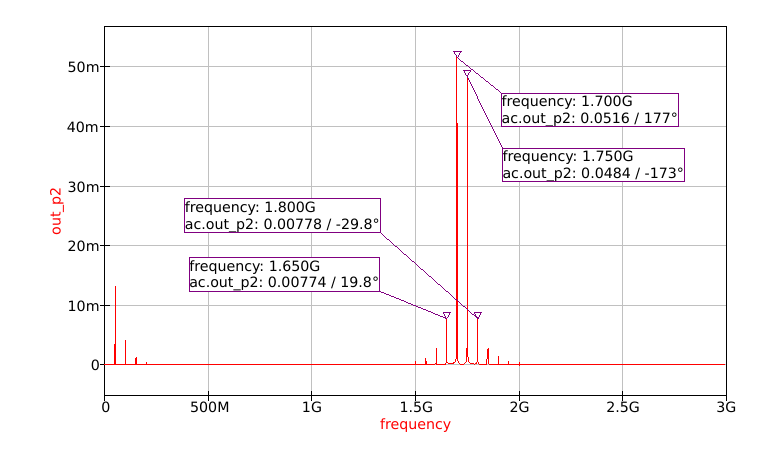
[picture p147: Images/LNA_Linearity_FF_HP.png]
Linearity
|||

#### Low Power (-30 dBm)
|Parameter|Value|
|---|-----|
|P<sub>low</sub>| -20.4 dBm |
|P<sub>high</sub>| -20.8 dBm |
|IM3<sub>low</sub>| -44.1 dBm |
|IM3<sub>high</sub>| -43.6 dBm |
|OIP3| -9.0 dBm |

#### High Power (-20 dBm)
|Parameter|Value|
|---|-----|
|P<sub>low</sub>| -15.7 dBm |
|P<sub>high</sub>| -16.3 dBm |
|IM3<sub>low</sub>| -32.2 dBm |
|IM3<sub>high</sub>| -32.2 dBm |
|OIP3| -7.9 dBm |

### Slow-Fast Corner
| Low Power (-30 dBm) | High Power (-20dBm) |
|---|---|
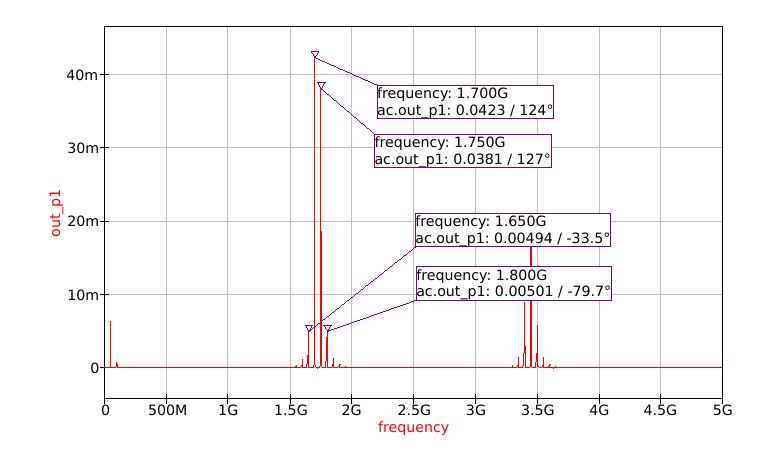
[picture p148: Images/LNA_Linearity_SF.png]
Linearity
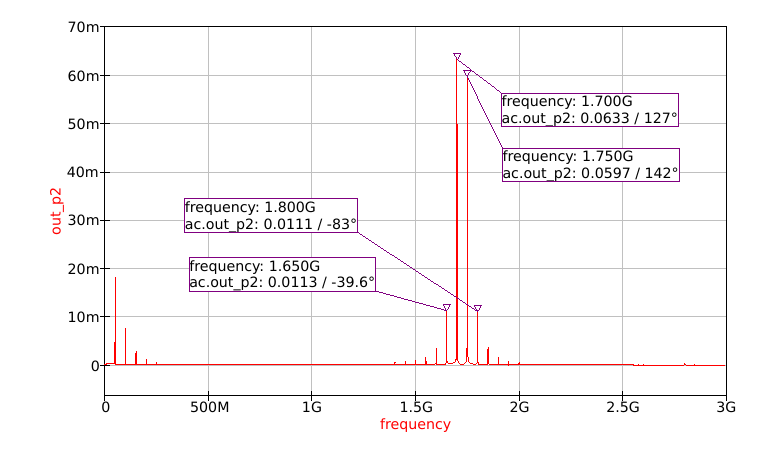
[picture p149: Images/LNA_Linearity_SF_HP.png]
Linearity
|||

#### Low Power (-30 dBm)
|Parameter|Value|
|---|-----|
|P<sub>low</sub>| -17.5 dBm |
|P<sub>high</sub>| -18.4 dBm |
|IM3<sub>low</sub>| -36.1 dBm |
|IM3<sub>high</sub>| -36.0 dBm |
|OIP3| -8.9 dBm |

#### High Power (-20 dBm)
|Parameter|Value|
|---|-----|
|P<sub>low</sub>| -14.0 dBm |
|P<sub>high</sub>| -14.5 dBm |
|IM3<sub>low</sub>| -28.9 dBm |
|IM3<sub>high</sub>| -29.1 dBm |
|OIP3| -6.8 dBm |

### Fast-Slow Corner
| Low Power (-30 dBm) | High Power (-20dBm) |
|---|---|
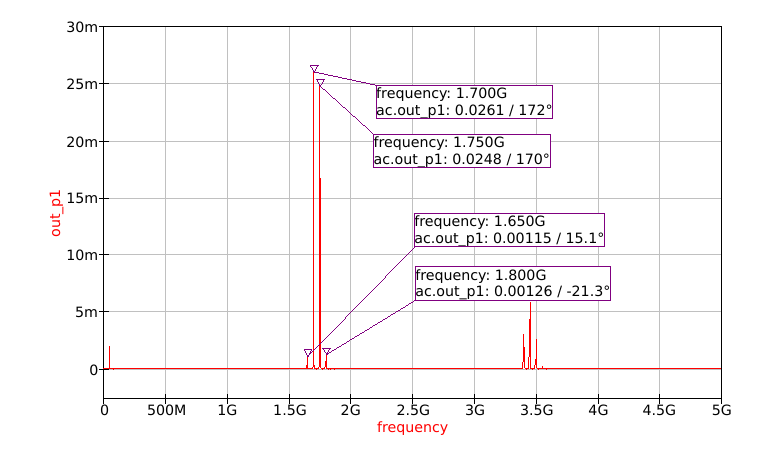
[picture p150: Images/LNA_Linearity_FS.png]
Linearity
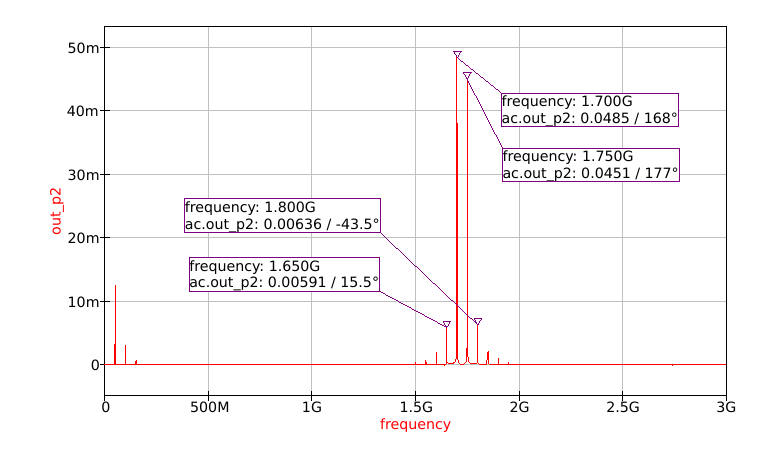
[picture p151: Images/LNA_Linearity_FS_HP.png]
Linearity
|||

#### Low Power (-30 dBm)
|Parameter|Value|
|---|-----|
|P<sub>low</sub>| -21.7 dBm |
|P<sub>high</sub>| -22.1 dBm |
|IM3<sub>low</sub>| -48.8 dBm |
|IM3<sub>high</sub>| -48.0 dBm |
|OIP3| -8.6 dBm |

#### High Power (-20 dBm)
|Parameter|Value|
|---|-----|
|P<sub>low</sub>| -16.3 dBm |
|P<sub>high</sub>| -16.9 dBm |
|IM3<sub>low</sub>| -34.6 dBm |
|IM3<sub>high</sub>| -33.9 dBm |
|OIP3| -7.8 dBm |

## DC Power Consumption Test Bench

*Most Up-To-Date Test Bench: Schematic/LNA/LNA_Testing_Power_MkI.sch*

The average and peak DC power consumption of the LNA was characterized when saturated with a 1.7GHz tone.

### Typical 
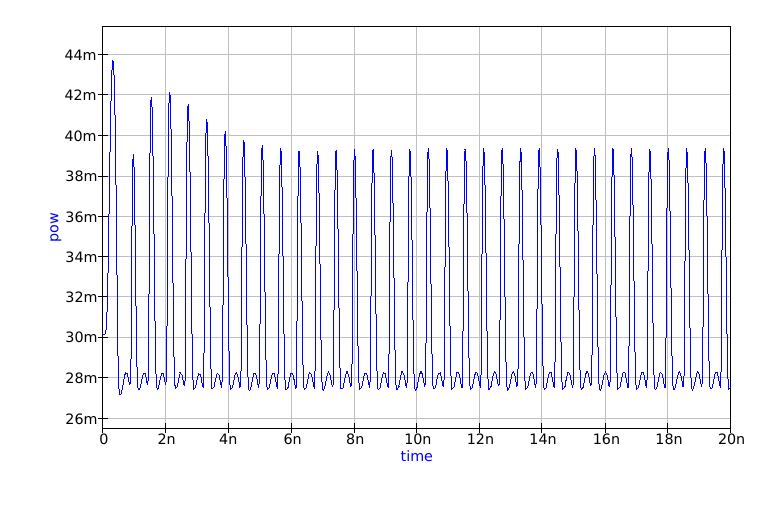
[picture p152: Images/LNA_Power_TT.png]
Power Consumption


|Parameter|Value|
|---|-----|
| Average DC Power Consumption | 31 mW |
| Peak DC Power Consumption | 44 mW |

### Slow-Slow Corner

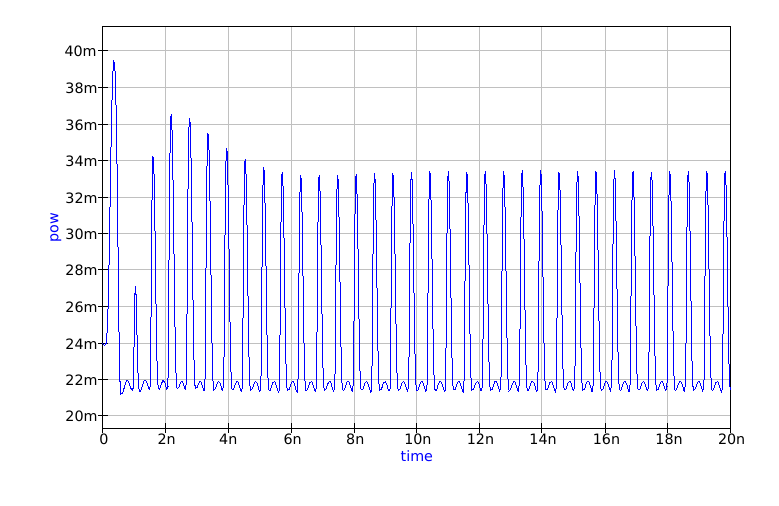
[picture p153: Images/LNA_Power_SS.png]
Power Consumption


|Parameter|Value|
|---|-----|
| Average DC Power Consumption | 25 mW |
| Peak DC Power Consumption | 40 mW |

### Fast-Fast Corner

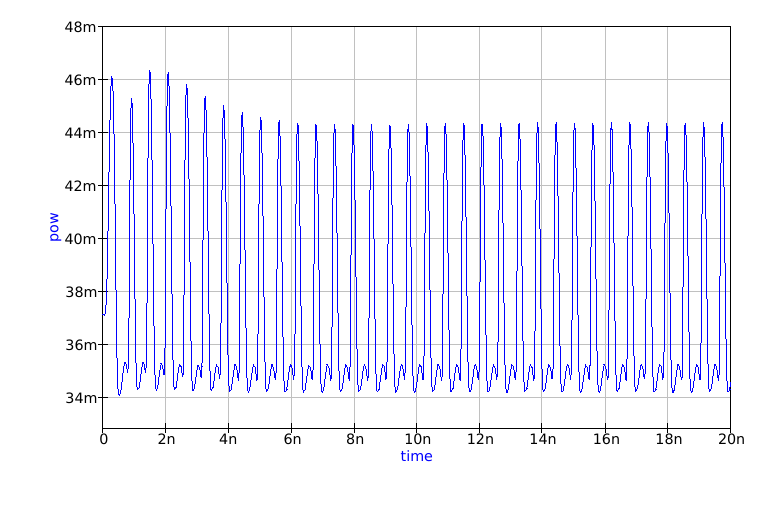
[picture p154: Images/LNA_Power_FF.png]
Power Consumption


|Parameter|Value|
|---|-----|
| Average DC Power Consumption | 37 mW |
| Peak DC Power Consumption | 47 mW |

### Slow-Fast Corner

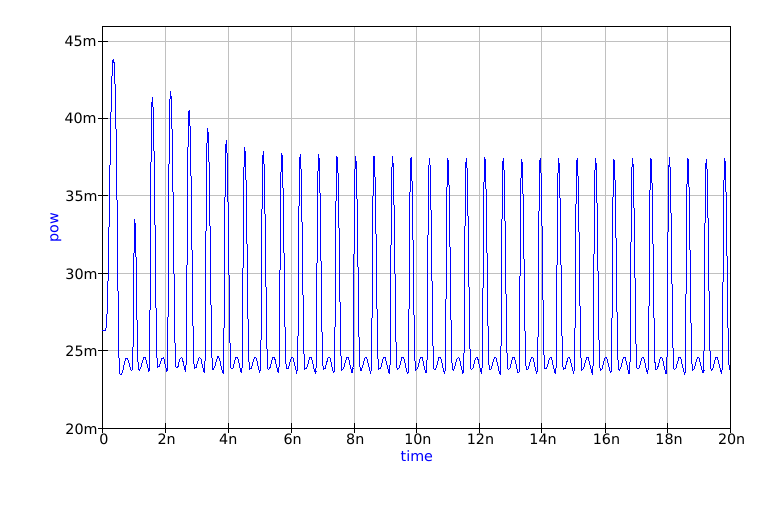
[picture p155: Images/LNA_Power_SF.png]
Power Consumption


|Parameter|Value|
|---|-----|
| Average DC Power Consumption | 27 mW |
| Peak DC Power Consumption | 44 mW |

### Fast-Slow Corner

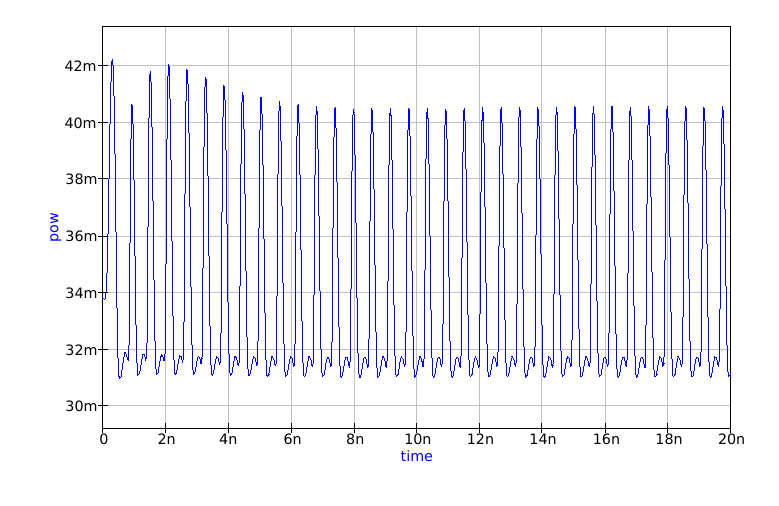
[picture p156: Images/LNA_Power_FS.png]
Power Consumption


|Parameter|Value|
|---|-----|
| Average DC Power Consumption | 34 mW |
| Peak DC Power Consumption | 42 mW |

## Supply Sweep Test Bench

*Most Up-To-Date Test Bench: Schematic/LNA/LNA_Testing_Power_MkI.sch*
The LNA voltage supply was sweeped between 2 and 4 volts.  As expected, the gain was positively corellated with operating voltage.  The thin oxide on the transistors will break down above 3.3V, but it is good to see the stability margins on the LNA at slightly higher voltage.  The amplifier remained stable across the entire voltage sweep at all corners, which was good.

### Typical 
| Maximum Gain (dB) | Minimum Rollett Stability Factor |
|---|---|
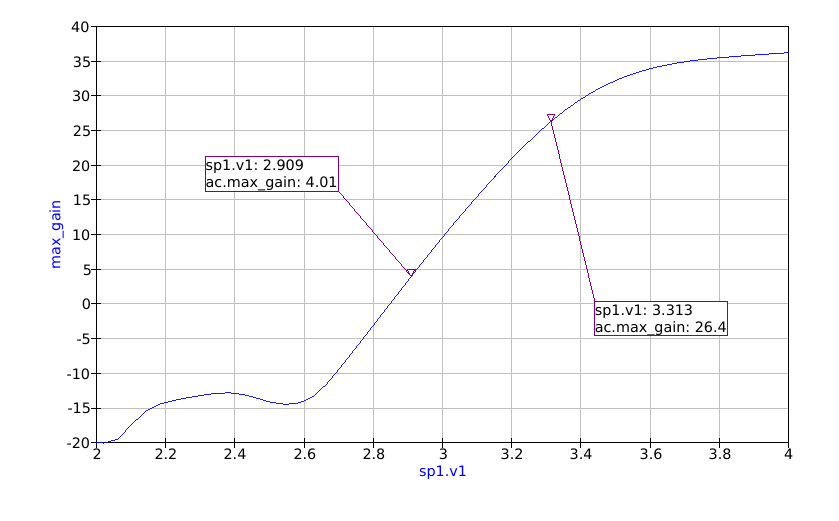
[picture p157: Images/LNA_Supply_Gain_TT.png]
Supply
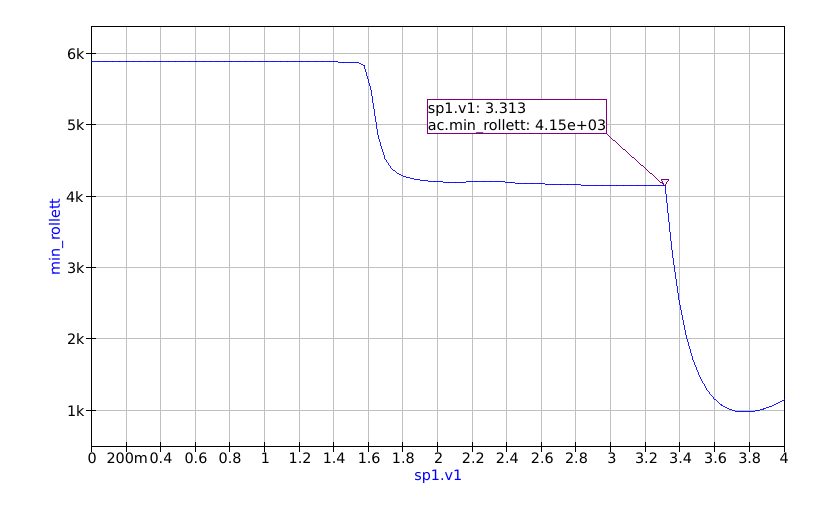
[picture p158: Images/LNA_Supply_Stab_TT.png]
Supply
|||

### Slow-Slow Corner
| Maximum Gain (dB) | Minimum Rollett Stability Factor |
|---|---|
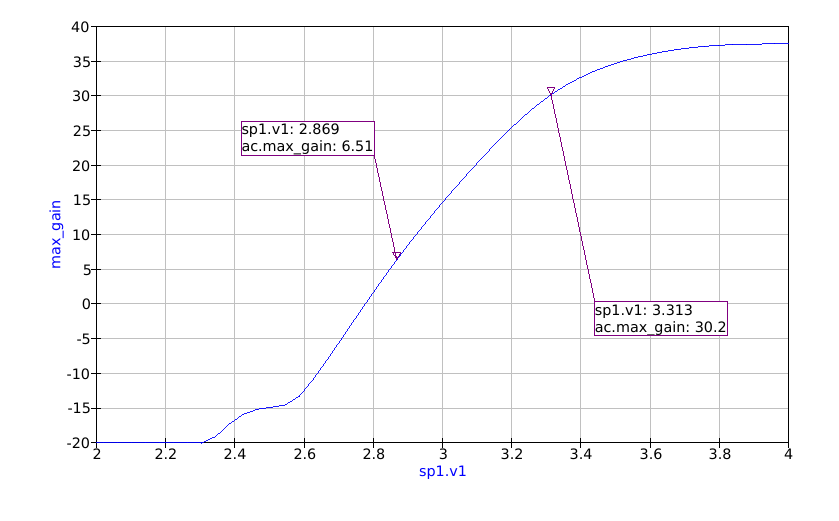
[picture p159: Images/LNA_Supply_Gain_SS.png]
Supply
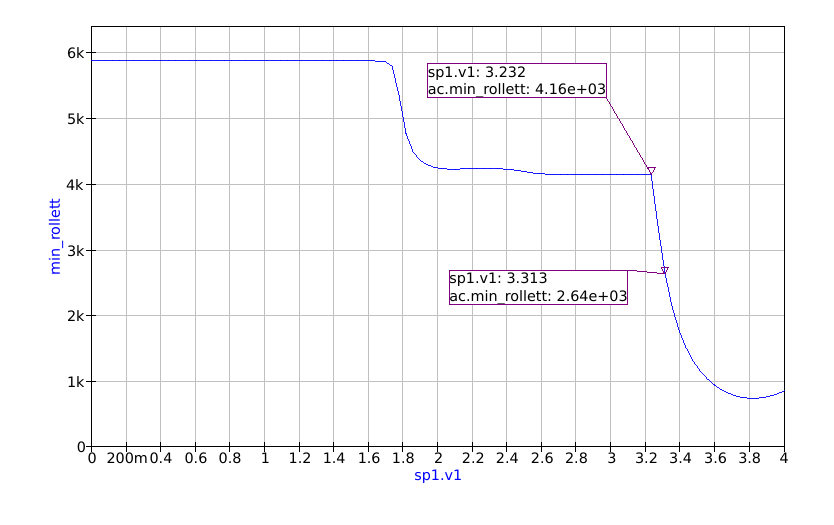
[picture p160: Images/LNA_Supply_Stab_SS.png]
Supply
|||

### Fast-Fast Corner
| Maximum Gain (dB) | Minimum Rollett Stability Factor |
|---|---|
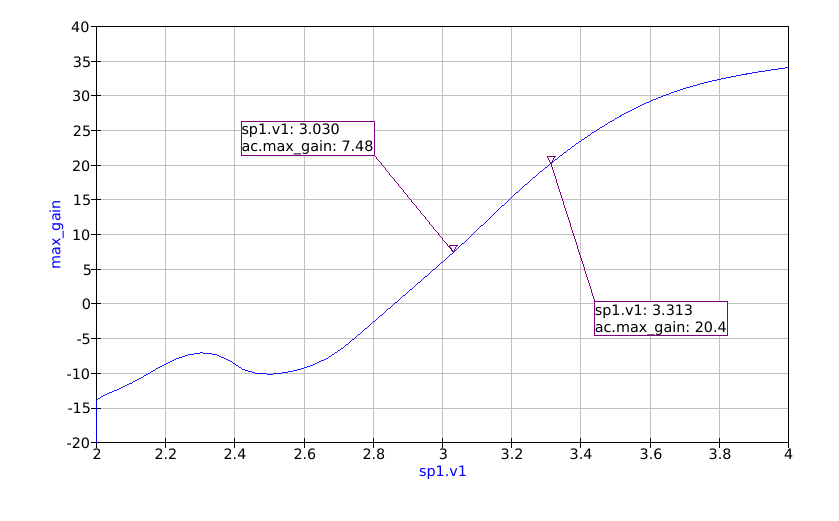
[picture p161: Images/LNA_Supply_Gain_FF.png]
Supply
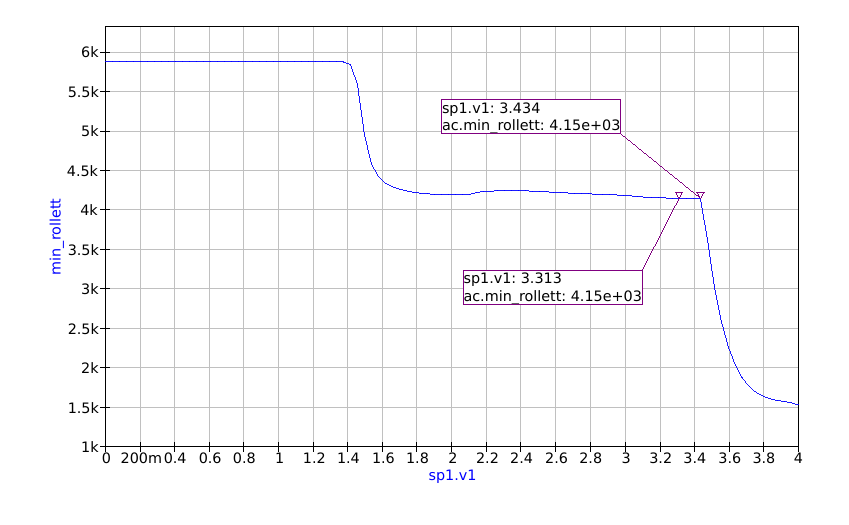
[picture p162: Images/LNA_Supply_Stab_FF.png]
Supply
|||

### Slow-Fast Corner
| Maximum Gain (dB) | Minimum Rollett Stability Factor |
|---|---|
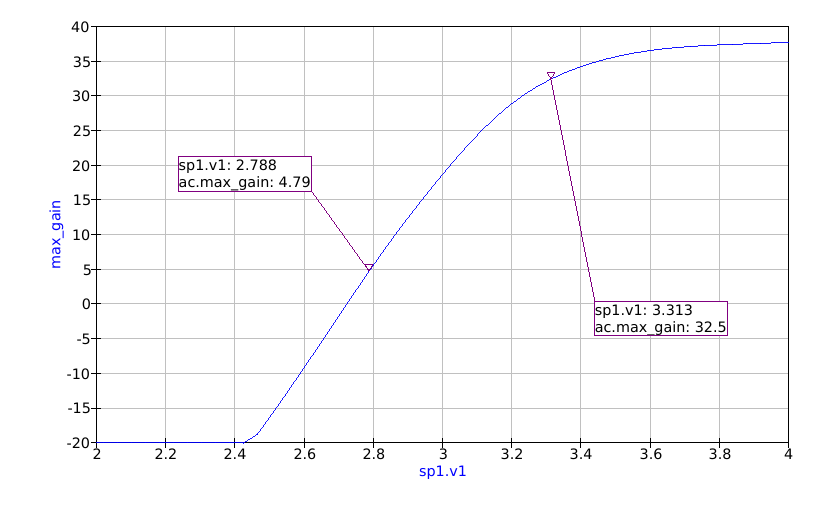
[picture p163: Images/LNA_Supply_Gain_SF.png]
Supply
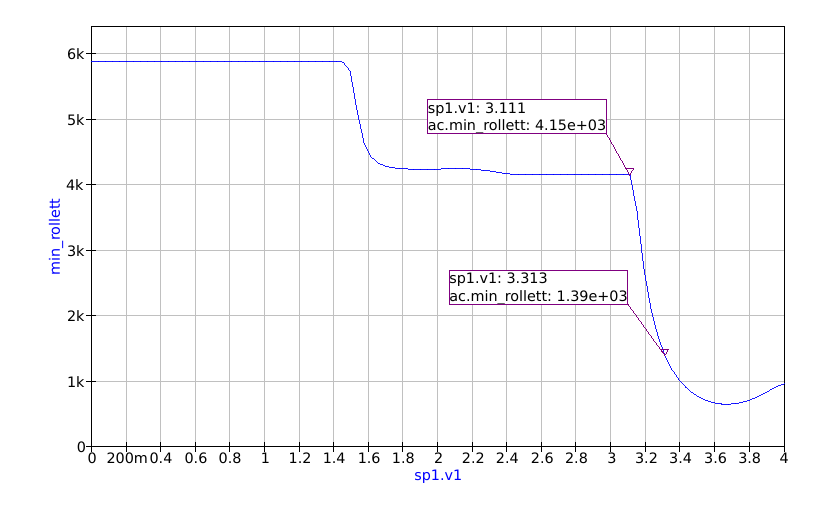
[picture p164: Images/LNA_Supply_Stab_SF.png]
Supply
|||

### Fast-Slow Corner
| Maximum Gain (dB) | Minimum Rollett Stability Factor |
|---|---|
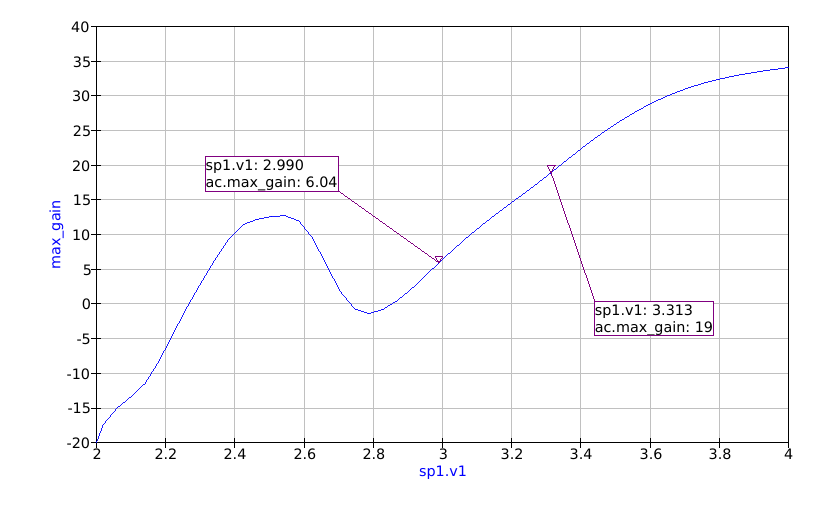
[picture p165: Images/LNA_Supply_Gain_FS.png]
Supply
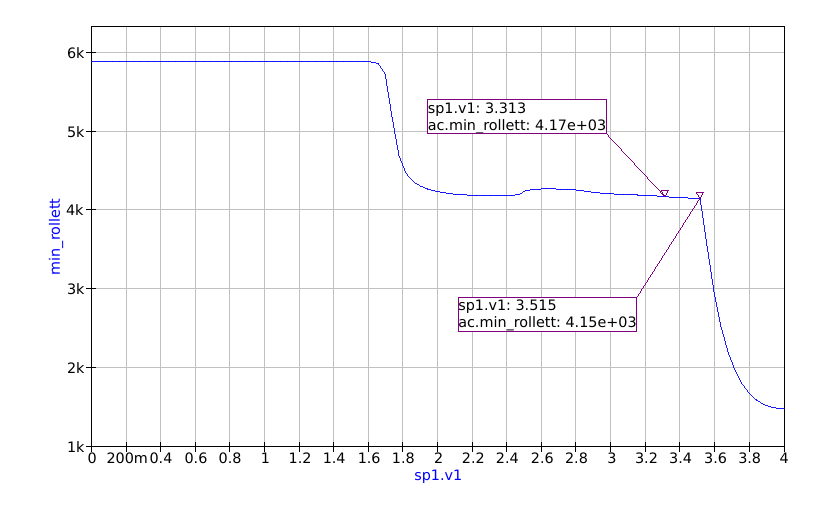
[picture p166: Images/LNA_Supply_Stab_FS.png]
Supply
|||

## Temperature Test Bench

*Most Up-To-Date Test Bench: Schematic/LNA/LNA_Testing_Temp_MkI.sch*

Temperature was sweeped between between -25C and 125C, the automotive component temperature range.  The gain of the LNA fell off somewhat significantly after 80C, although it never stopped providing gain.  This was to be expected because this LNA does not have any temperature compensation (nor does it really have a way to implement that architecturally).  More importantly, the amplifier remained stable across the entire temperature sweep at all corners.

### Typical 
| Maximum Gain (dB) | Minimum Rollett Stability Factor |
|---|---|
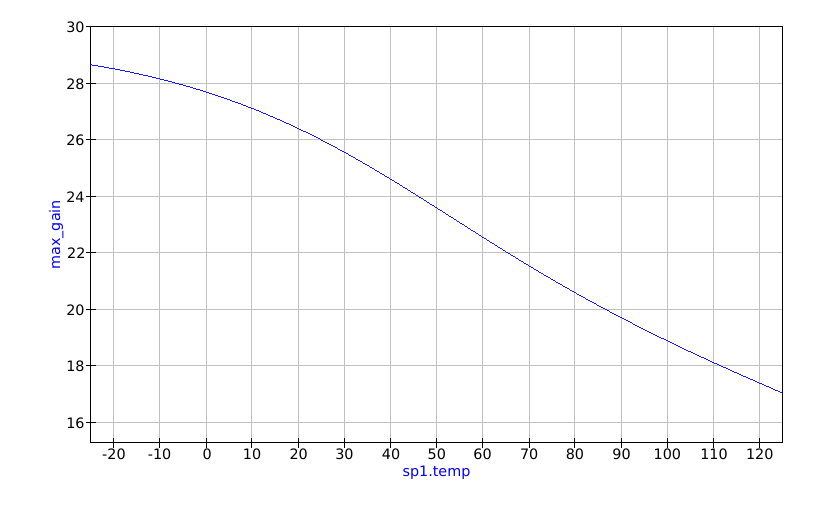
[picture p167: Images/LNA_Temp_Gain_TT.png]
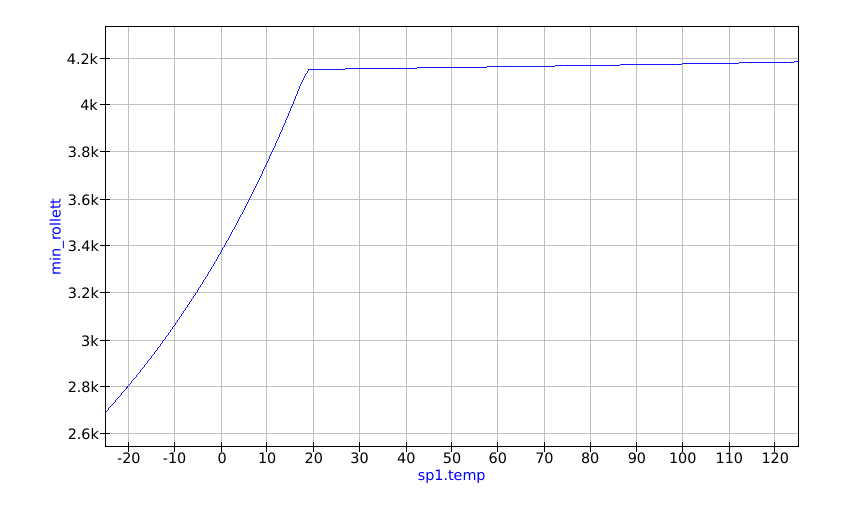
[picture p168: Images/LNA_Temp_Stab_TT.png]
|||

### Slow-Slow Corner
| Maximum Gain (dB) | Minimum Rollett Stability Factor |
|---|---|
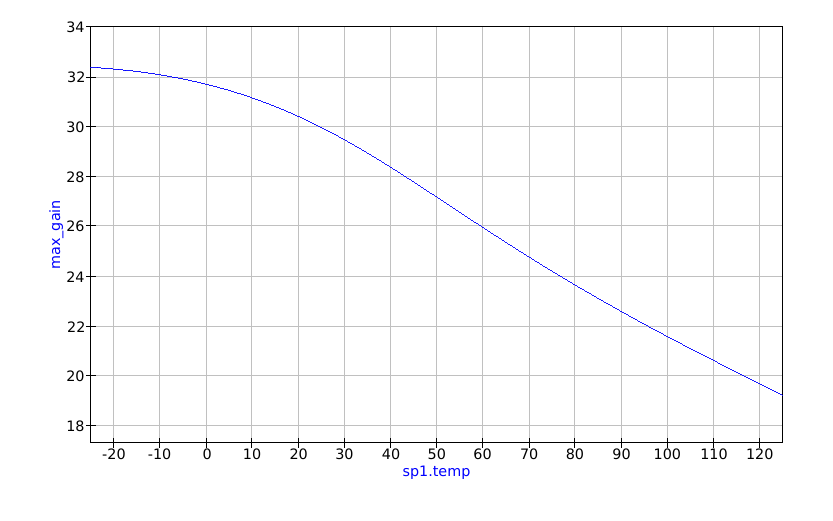
[picture p169: Images/LNA_Temp_Gain_SS.png]
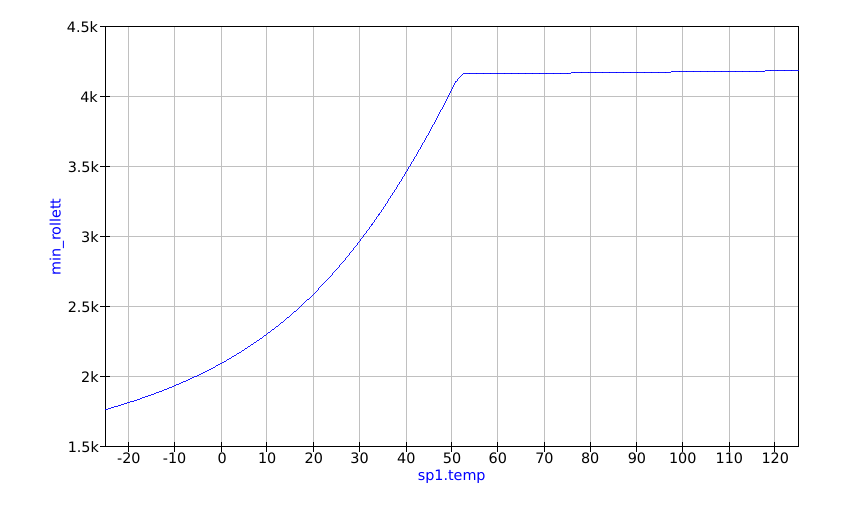
[picture p170: Images/LNA_Temp_Stab_SS.png]
|||

### Fast-Fast Corner
| Maximum Gain (dB) | Minimum Rollett Stability Factor |
|---|---|
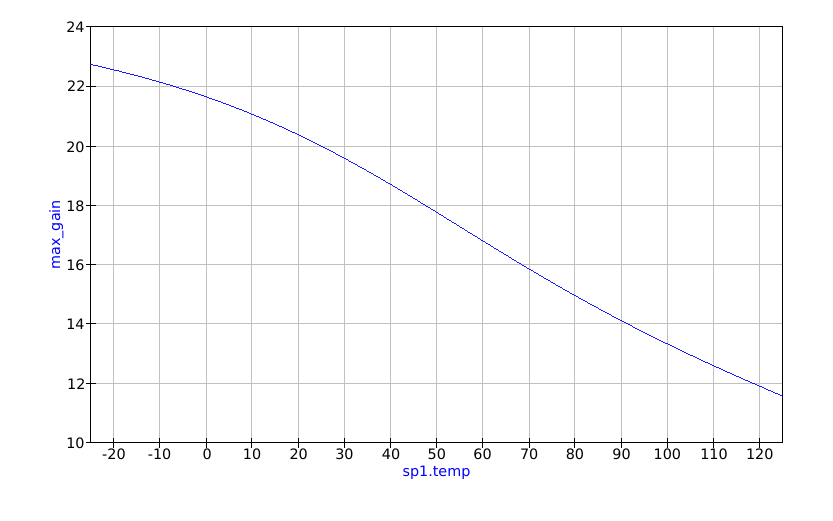
[picture p171: Images/LNA_Temp_Gain_FF.png]
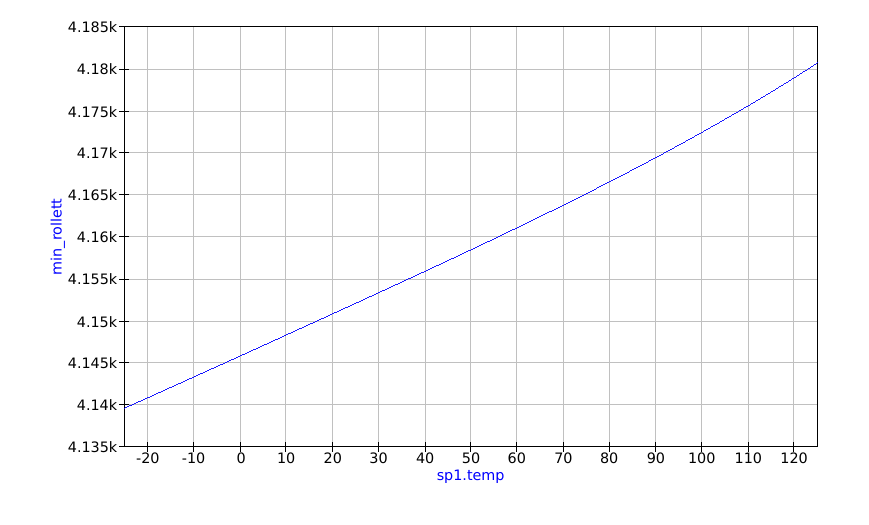
[picture p172: Images/LNA_Temp_Stab_FF.png]
|||

### Slow-Fast Corner
| Maximum Gain (dB) | Minimum Rollett Stability Factor |
|---|---|
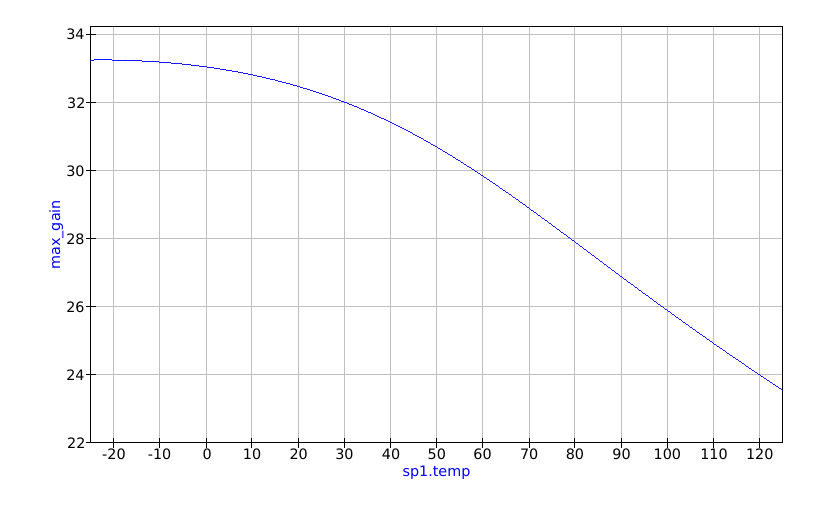
[picture p173: Images/LNA_Temp_Gain_SF.png]
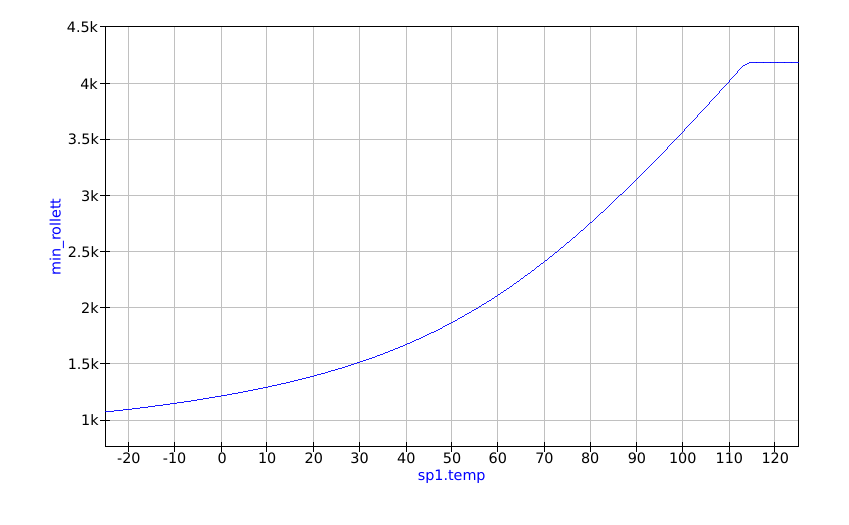
[picture p174: Images/LNA_Temp_Stab_SF.png]
|||

### Fast-Slow Corner
| Maximum Gain (dB) | Minimum Rollett Stability Factor |
|---|---|
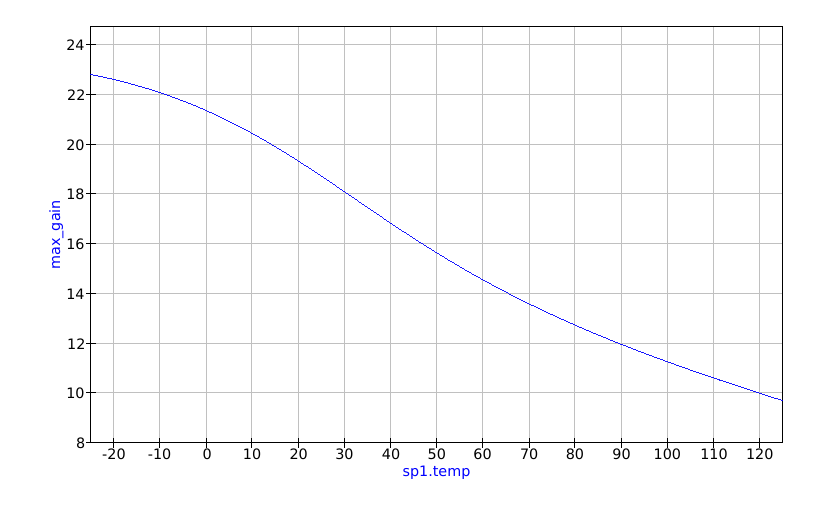
[picture p175: Images/LNA_Temp_Gain_FS.png]
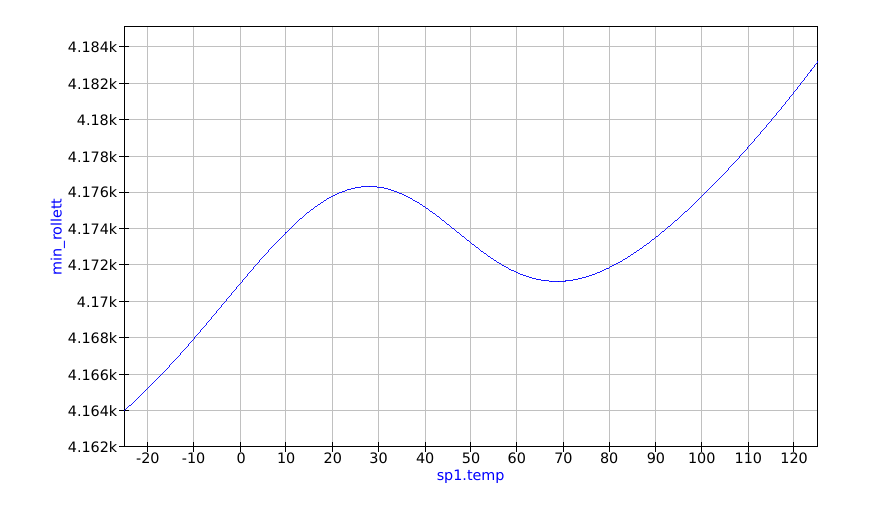
[picture p176: Images/LNA_Temp_Stab_FS.png]
|||
