rcyaon/cmos-lnb/Schematic/Error Amplifier/netlist.cir

* Qucs 26.1.1  /foss/designs/LNA/MkIII/Schematic/Error Amplifier/ErrorAmplifier_Testing_MkI.sch
.PARAM MC_SWITCH = 1.0
.INCLUDE "/foss/tools/qucs-s/share/qucs-s/xspice_cmlib/include/ngspice_mathfunc.inc"
.INCLUDE "/foss/pdks/ciel/gf180mcu/versions/026824c7969ce6f4fc9678e6ca04b0a06a596c4b/gf180mcuD/libs.tech/ngspice/design.ngspice"
.LIB "/foss/pdks/ciel/gf180mcu/versions/026824c7969ce6f4fc9678e6ca04b0a06a596c4b/gf180mcuD/libs.tech/ngspice/sm141064.ngspice" bjt_typical
.LIB "/foss/pdks/ciel/gf180mcu/versions/026824c7969ce6f4fc9678e6ca04b0a06a596c4b/gf180mcuD/libs.tech/ngspice/sm141064.ngspice" typical
.LIB "/foss/pdks/ciel/gf180mcu/versions/026824c7969ce6f4fc9678e6ca04b0a06a596c4b/gf180mcuD/libs.tech/ngspice/sm141064.ngspice" cap_mim
.LIB "/foss/pdks/ciel/gf180mcu/versions/026824c7969ce6f4fc9678e6ca04b0a06a596c4b/gf180mcuD/libs.tech/ngspice/sm141064.ngspice" mimcap_typical
.LIB "/foss/pdks/ciel/gf180mcu/versions/026824c7969ce6f4fc9678e6ca04b0a06a596c4b/gf180mcuD/libs.tech/ngspice/sm141064.ngspice" res_typical
.SUBCKT ErrorAmplifierPMOSMkI _net2 _net0 _net3 _net4 _net1 
X7 _net4  _net1  _net5  _net4 pfet_06v0 L=0.6u W=0.3u nf=1 ad='int((nf+1)/2) * W/nf * 0.18u' as='int((nf+2)/2) * W/nf * 0.18u' pd='2*int((nf+1)/2) * (W/nf + 0.18u)' ps='2*int((nf+2)/2) * (W/nf + 0.18u)' nrd='0.18u / W' nrs='0.18u / W' sa=0 sb=0 sd=0
X8 _net5  _net0  _net3  _net4 pfet_06v0 L=0.6u W=0.3u nf=1 ad='int((nf+1)/2) * W/nf * 0.18u' as='int((nf+2)/2) * W/nf * 0.18u' pd='2*int((nf+1)/2) * (W/nf + 0.18u)' ps='2*int((nf+2)/2) * (W/nf + 0.18u)' nrd='0.18u / W' nrs='0.18u / W' sa=0 sb=0 sd=0
X9 _net5  _net2  _net6  _net4 pfet_06v0 L=0.6u W=0.3u nf=1 ad='int((nf+1)/2) * W/nf * 0.18u' as='int((nf+2)/2) * W/nf * 0.18u' pd='2*int((nf+1)/2) * (W/nf + 0.18u)' ps='2*int((nf+2)/2) * (W/nf + 0.18u)' nrd='0.18u / W' nrs='0.18u / W' sa=0 sb=0 sd=0
X1 _net3  _net6  0  0 nfet_06v0 L=0.6u W=0.3u nf=1 ad='int((nf+1)/2) * W/nf * 0.18u' as='int((nf+2)/2) * W/nf * 0.18u' pd='2*int((nf+1)/2) * (W/nf + 0.18u)' ps='2*int((nf+2)/2) * (W/nf + 0.18u)' nrd='0.18u / W' nrs='0.18u / W' sa=0 sb=0 sd=0
X10 _net6  _net6  0  0 nfet_06v0 L=0.6u W=0.3u nf=1 ad='int((nf+1)/2) * W/nf * 0.18u' as='int((nf+2)/2) * W/nf * 0.18u' pd='2*int((nf+1)/2) * (W/nf + 0.18u)' ps='2*int((nf+2)/2) * (W/nf + 0.18u)' nrd='0.18u / W' nrs='0.18u / W' sa=0 sb=0 sd=0
.ENDS







XSUB1 _net3 _net0 output _net1 _net2 ErrorAmplifierPMOSMkI
V1 _net1 0 DC 5
V2 _net0 0 DC 1.2
I1 _net2 0 DC 10U
X1 _net1  _net2  _net2  _net1 pfet_06v0 L=0.5u W=0.3u nf=1 ad='int((nf+1)/2) * W/nf * 0.18u' as='int((nf+2)/2) * W/nf * 0.18u' pd='2*int((nf+1)/2) * (W/nf + 0.18u)' ps='2*int((nf+2)/2) * (W/nf + 0.18u)' nrd='0.18u / W' nrs='0.18u / W' sa=0 sb=0 sd=0
V3 _net3 0 DC 1.2


.control

op
print v(output)   > spice4qucs.dc1.ngspice.dc.print
destroy all
reset

dc v1 0 5 0.263158
write spice4qucs.sw1.plot v(output)
destroy all
reset

exit
.endc
.END
