rcyaon/cmos-lnb/(commit log)

2026-10-03 Did the LNA design, restuctured the project, created BiCMOS output buffer, designed LDOs and integrated biasing into end-to end tests
    [AmpCore.sch, AmpCore_Testing.sch, Balun.sch, BalunMkI.sch, BalunMkII.sch, BalunTesting.sch, Balun_Testing.sch, Balun_Testing_MkII.sch]
2026-10-05 Updated Schematics and Readme
    [BalunMkII.sch, ErrorAmplifierMkI.sch, ErrorAmplifierPMOSMkI.sch, ErrorAmplifier_Testing_MkI.sch, GainStageMkI.sch, ImpedanceMatchingMkII.sch, ImpedanceMatching_Testing_MkI.sch, LNA.sch]
2026-10-06 Added Inductor Characterization Data
    [ImpedanceMatching_Testing_MkI.sch]
2026-10-06 Added LNA Characterization
    [CapacitorMkI.sch, GainStageMkI.sch, ImpedanceMatchingMkII.sch, ImpedanceMatching_Testing_MkI.sch, InductorMkI.sch, LNAMkI.sch, LNA_OIP3.sch, LNA_S_Parameters.sch]
2026-10-06 Changed to 3V3 devices and an input buffer instead of impedance matching network
    [BalunMkII.sch, BalunMkIII.sch, BalunTestingMkI.sch, ErrorAmplifierPMOSMkII.sch, GainStageMkII.sch, InputBufferMkI.sch, LDO_Testing_MkI.sch, LNAMkI.sch]
2026-10-06 Added Compression Test Benches
    [LNA_Testing_Compression_MkI.sch, LNA_Testing_Compression_MkII.sch]
2026-10-07 Added linearity tests to the project:
    [LNA_Testing_Linearity_MkI.sch]
2026-10-07 added more linearity tests
    [LNA_Testing_Linearity_MkI.sch]
2026-10-07 added temperature, supply and power sweep data
    [LNA_Testing_Linearity_MkI.sch, LNA_Testing_Power_MkI.sch, LNA_Testing_Supply_MkI.sch, LNA_Testing_Temp_MkI.sch]
2026-10-07 Added more images
    [BalunMkIII.sch, LDOMkI.sch, OutputBufferMkVI.sch, ReferenceMkI.sch]
2026-10-07 Added characterization for the reference supply
    [LDOMkI.sch, LDO_Testing_MkII.sch, LDO_Testing_Monte_Carlo_MkI.sch, LDO_Testing_Rise_Time_MkI.sch, LDO_Testing_Supply_MkI.sch, LDO_Testing_Temperature_MkI.sch, LNAMkII.sch, LNA_Testing_Compression_MkII.sch]
2026-10-07 added gain stage monte carlo
    [GainStage_Testing_Monte_Carlo_MkI.sch, LDO_Testing_Monte_Carlo_MkI.sch, LNAMkII.sch, LNBMkII.sch, mc_data.csv]
2026-10-07 added gain stage monte carlo analysis
2026-10-08 Added more LNA labeling:
    [LNAMkII.sch]
2026-10-08 Finished LNB design
    [LNAMkII.sch, LNA_Testing_Compression_MkI.sch, LNA_Testing_Linearity_MkI.sch, LNA_Testing_Power_MkI.sch, LNA_Testing_S_Parameters_MkI.sch, LNA_Testing_S_Parameters_MkII.sch, LNA_Testing_Temp_MkI.sch, LNBMkII.sch]
2026-10-08 Added LNB S-Parameter Measurements
    [LNA_OIP3.sch, LNA_S_Parameters.sch, LNA_SingleStage.sch, LNA_System.sch, LNA_Testing_S_Parameters_MkI.sch, LNA_VoltageGain.sch, LNBMkI.sch, LNB_Backend.sch]
2026-10-08 Added LNB gain data
    [LNB_Testing_Gain_MkI.sch]
2026-10-08 Added images for oscillator
    [LNB_Testing_Transient_MkI.sch, PassiveTest.sch, RingInverterMkI.sch, RingOscillatorMkII.sch]
2026-10-08 added LNA and LNB images
    [LNAMkII.sch, LNBMkII.sch, Oscillator_Frequency_Testing_MkI.sch]
2026-10-08 corrected an image
    [RingInverterMkII.sch]
2026-10-08 Added some small touches
    [LDOMkI.sch, LNAMkII.sch]
